KubaMiszcz/Praca-Inzynierska---RoboPajak/kalibracja serwa SG90/2016-11-22 serwo kalibr.jpg

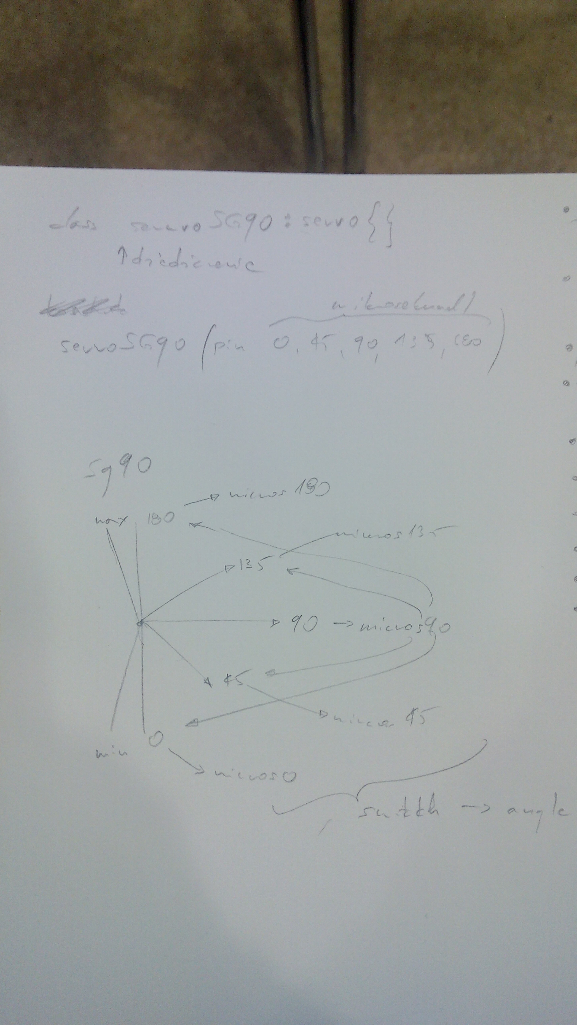
kalibracja serwa SG90/2016-11-22 serwo kalibr.jpg
