KubaMiszcz/Praca-Inzynierska---RoboPajak/2016-12-15 210624.jpg

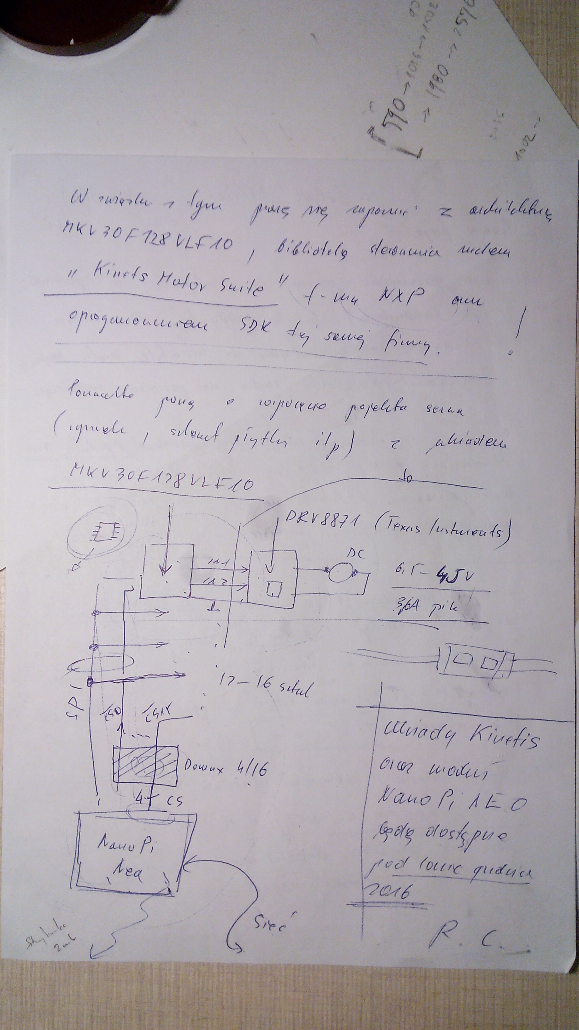
2016-12-15 210624.jpg
