KubaMiszcz/Praca-Inzynierska---RoboPajak/kalibracja serwa SG90/serialcomm/README.md

# serialcomm
communication betwee c# and serialport

na podstawie:
https://majsterkowo.pl/arduino-i-visual-c

plus moje upgrady i poprawki
