KubaMiszcz/Praca-Inzynierska---RoboPajak/do zrobienia plan rozpiska.docx

1. zrobic pozostale 4 nogi i korpus-baze
- czekam na serwa z aliexpressu
2. kalibrator serw i skalibrowac serwa sprawdzic czy trzeba kazde kalibrowac osobno
- metoda do sterowania serwem na podstawei danych z kalibracji - poprawka na nieliniowosc
3. glowa - 8 diod losowo zapalanych/gaszonych
- osobny modul niezalezny - arduino
4. noga o 3 stopniach swobody xyz, notacja DH, kinematyka odwrotna i prosta
- niech suwa noga na poczatek
- sterowanie jakies żeby robil krok
- noga,serwo, robot: klasa w C++(Visual Micro)
- zeby chodzil prosto - zaprogramowane/obliczone wczesniej sekwencje posrednie
- trzeci segment do nog na ok 4cm ktory bybly caly czas pionowo (moze jakas stopa" amortyzowana na koncu)
- zeby skrecal i podnosil sie i obnizal, robil jakies proste figury (sekwencje ktore da rade zrobic)
- przesylanie z zewnatrz zadanej trasy XY i wykonywanie jej - import trasy z pliku
- jezyk skryptowy do wykonywania trasy
5. komunikacja z HC-05
6. sterowanie przez COM z C# sieci petriego
7. DOKUMENTACJA
- napisz co zrobiles matlab uwagi cos tam napisz
- o sieciach petreigo napisz
- o tej kinematyce to pelna tabelka a do katow T23 tylko rozpisz i te uwagi e reszta się prosto liczy
8. pilot do sterowania
- HC-05 i pilot od radia
9. rejestrowal swoje polozenie XY (+Z ale trza by cos do pomiary wysokosci, albo na podstawie przechylow ale to chyba szkoda czasu)
10. wizualizajca/interfejs na PC/Android w c#/Xamarin, (moze w Unity tylko czy po cos?) - komunikacja Bluetooth
