KubaMiszcz/Praca-Inzynierska---RoboPajak/plytka MKV30F128Vxx10P/48LQFP.docx

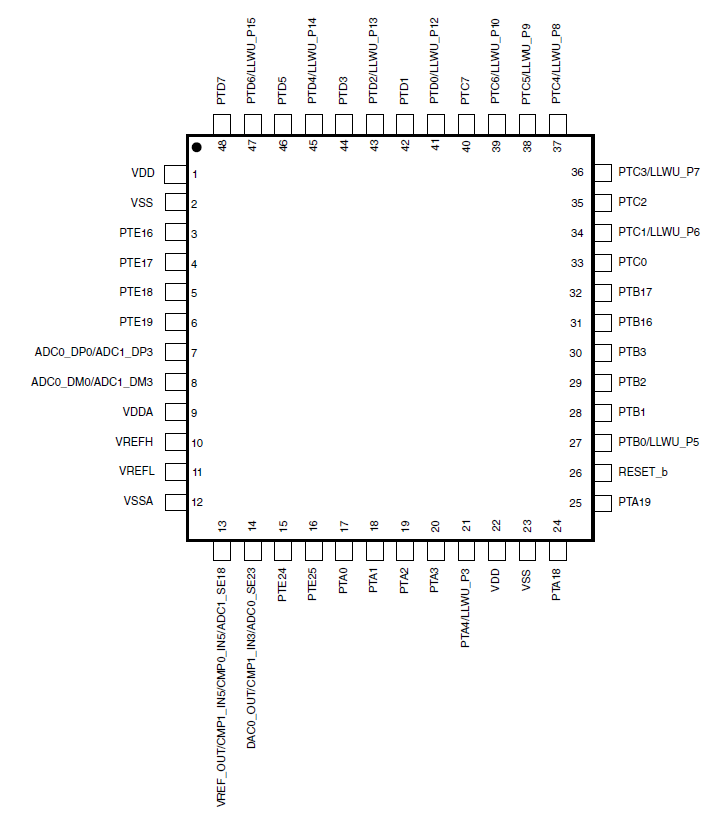
[picture p15: figure]
