KubaMiszcz/Praca-Inzynierska---RoboPajak/=SW 3D v3 new design/spis elementow.xlsx

segment | czesc | szt | kolor | nazwa | cm3 | VB | cm3 |  |  |  |  |  | masaSW | masaRepetier | masaREAL
S0 baza | korpus gora | 1 | czarny
 | korpus dol | 1
 | lacnzik korpusu z 4 obejmami | 1 | obojetne |  |  |  |  |  |  |  |  |  | noga | 509151.36 | mm3 | 509151.36
 | 4obejmy | 1 |  |  |  |  |  |  |  |  |  |  | korpus | 528599.73 | mm3 | 132149.9325
 | zaslepka w obejmie | 4 |  |  |  |  |  |  |  |  |  |  |  |  |  | 641301.2925 | mm3
S1 | rurka lacznik | 1 | obojetne
 | serwo | 2 | czarny
 | obudowa serwa | 2 | czarny
 |  |  |  |  |  |  |  |  |  |  |  |  |  |  |  | 26.1 | cm3
S2 | obejma | 1
 | zaslepka w obejmie | 1 | czarny |  |  |  |  |  |  |  |  |  |  |  |  | 52185.33 | mm3
 | rurka R2 | 1 |  |  |  |  |  |  |  |  |  |  |  |  |  | 52.18533
 | rurka lacznik | 2 | obojetne
 | serwo | 1
 | obudowa serwa | 1
S3 | obejma | 1 | czarny |  | 12.1
 | zaslepka w obejmie | 1
 | rurka R3 | 1 | czarny
 | rurka lacznik | 2 | obojetne
 | serwo | 1 | czarny |  |  | dolna 333 10% | 13.5
 | obudowa serwa | 1 | czarny | czapka |  | dolna 331 | 10.2 | dolna ??? |  | gorna 241 | ??? | 331 obie polwki: 20.6
S4 noga | obejma | 1
 | zaslepka w obejmie | 1 | czarny
 | rurka lacznik | 1 | obojetne
 | golen | 1
 | palec | 3 | czarny | palec232 | 2.6 | palec 342 | 3.6 | palec 333 | 3.1/ | palec 333 | 3.1
