KubaMiszcz/Praca-Inzynierska---RoboPajak/2016-12-01 PI opiska.jpg

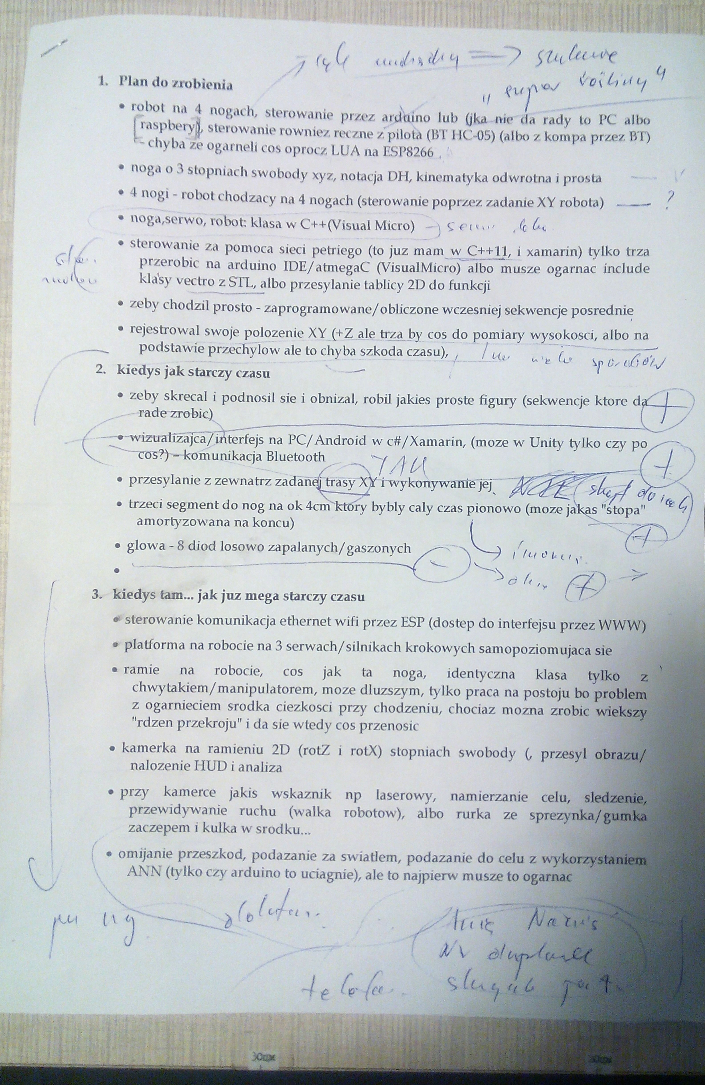
2016-12-01 PI opiska.jpg
