KubaMiszcz/Praca-Inzynierska---RoboPajak/2016-12-15 210615.jpg

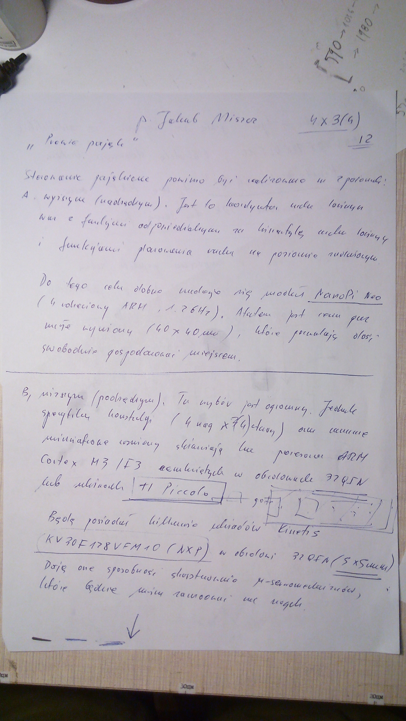
2016-12-15 210615.jpg
