KubaMiszcz/Praca-Inzynierska---RoboPajak/foto idea/2017-03-16 135014.jpg

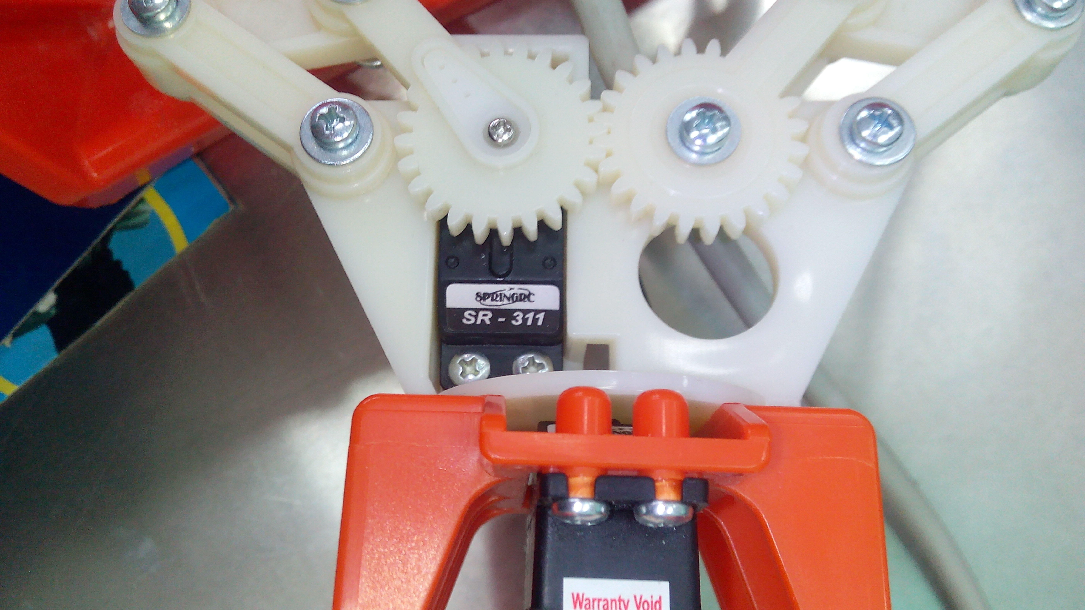
foto idea/2017-03-16 135014.jpg
