KubaMiszcz/Praca-Inzynierska---RoboPajak/foto idea/2017-03-16 135029.jpg

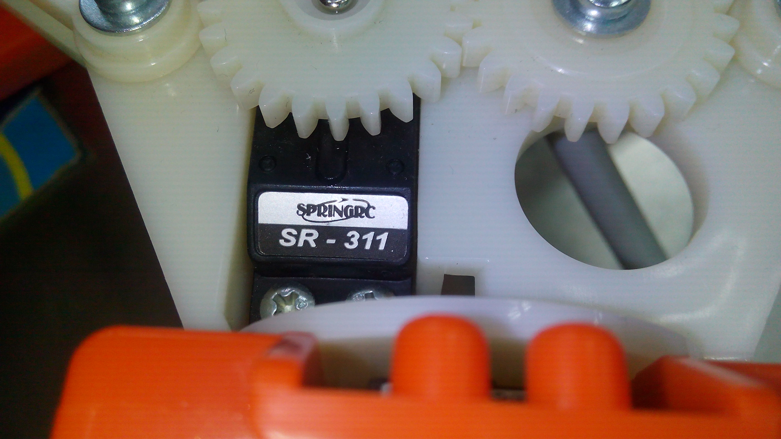
foto idea/2017-03-16 135029.jpg
