KubaMiszcz/Praca-Inzynierska---RoboPajak/foto idea/83620007d3c88add1a90197fbf7187ce.jpg

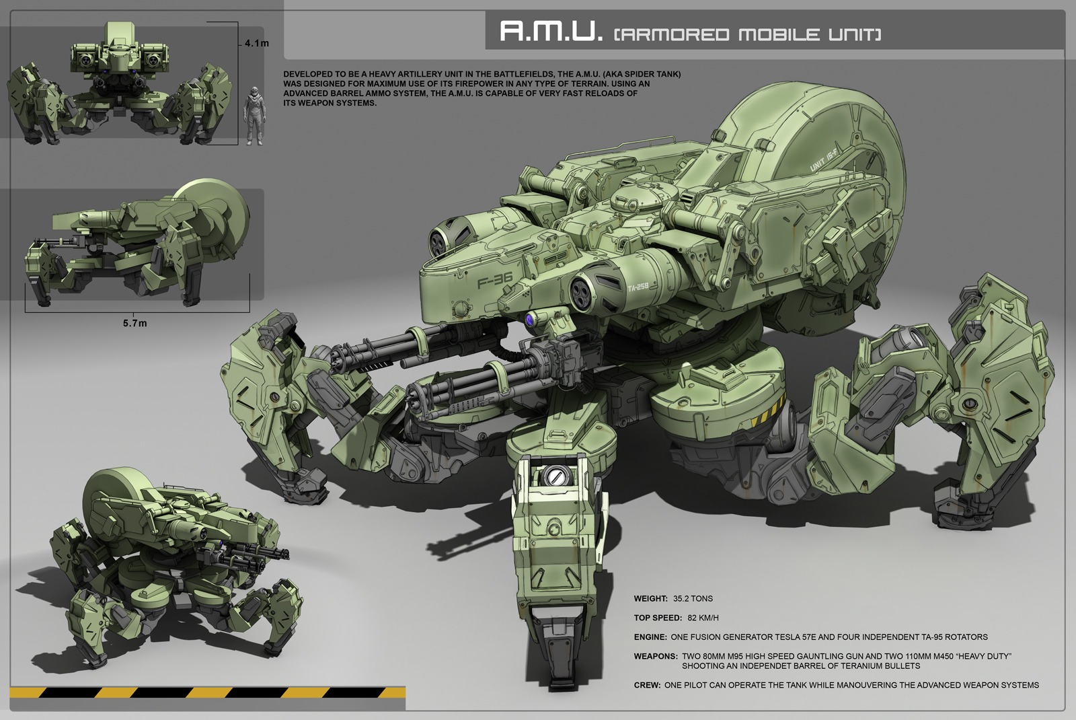
foto idea/83620007d3c88add1a90197fbf7187ce.jpg
