KubaMiszcz/Praca-Inzynierska---RoboPajak/foto idea/c6SfzFi.png

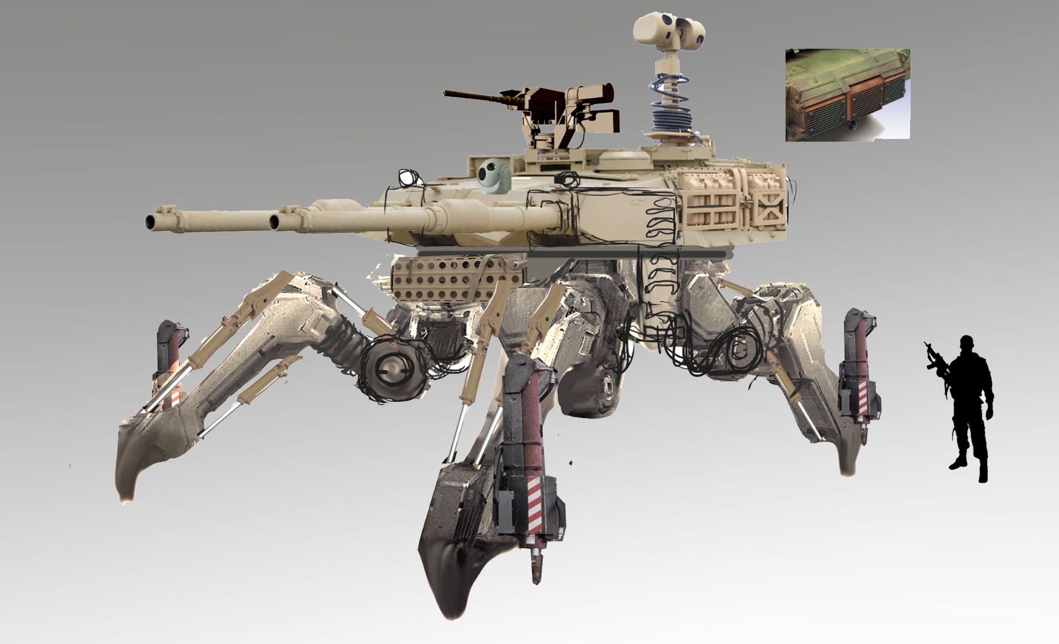
foto idea/c6SfzFi.png
