KubaMiszcz/Praca-Inzynierska---RoboPajak/foto idea/megalith_spider_tank_5354.jpg

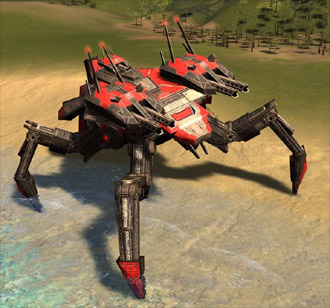
foto idea/megalith_spider_tank_5354.jpg
