KubaMiszcz/Praca-Inzynierska---RoboPajak/foto idea/spider_tank_colored_by_silencedarm-d62n22h.jpg

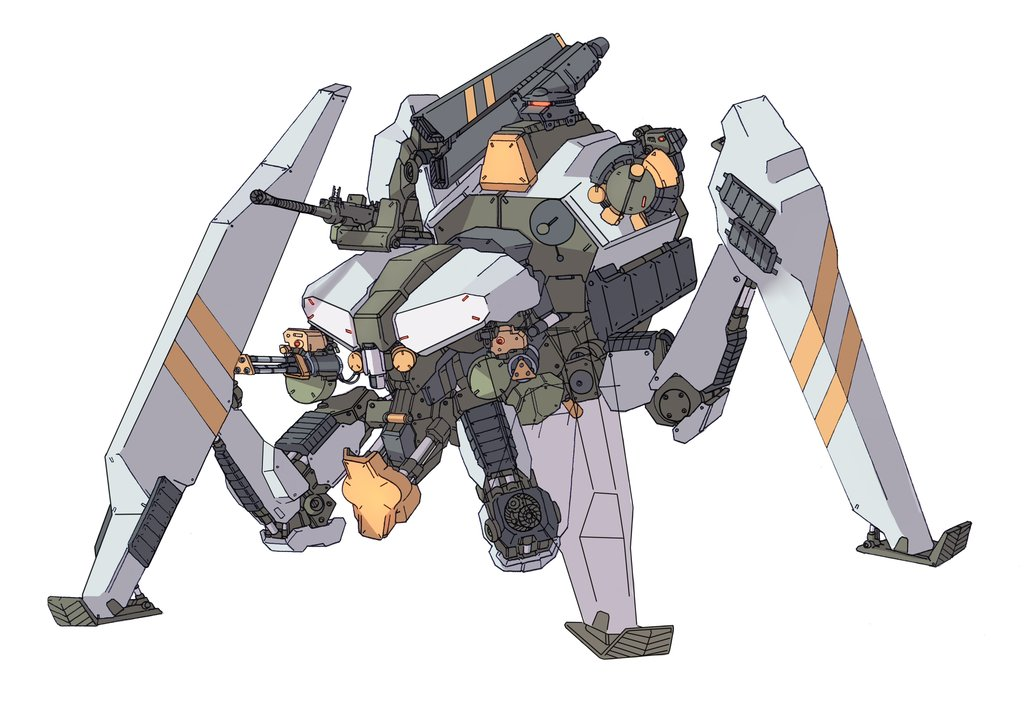
foto idea/spider_tank_colored_by_silencedarm-d62n22h.jpg
