KubaMiszcz/Praca-Inzynierska---RoboPajak/foto idea/spider_tank_in_progress_by_shanenelson.jpg

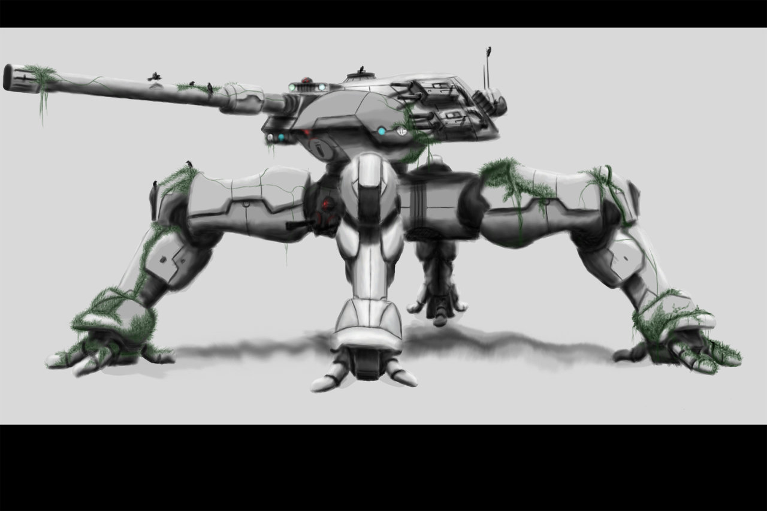
foto idea/spider_tank_in_progress_by_shanenelson.jpg
