KubaMiszcz/Praca-Inzynierska---RoboPajak/fotografie/2016-12-25 pierwsza wersja 1.jpg

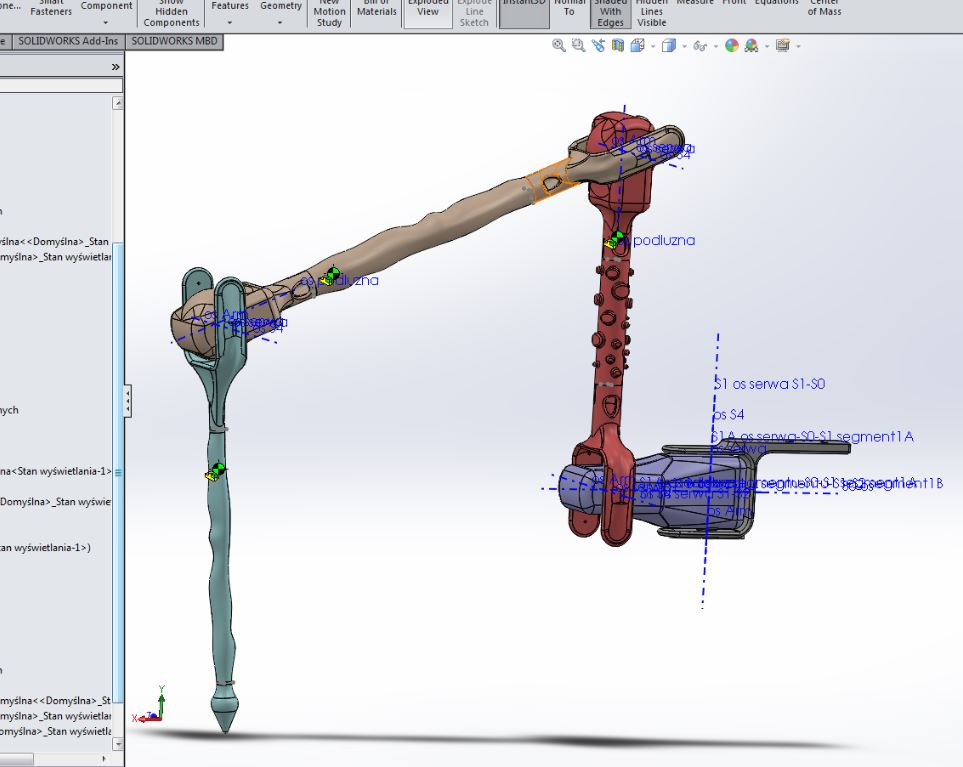
fotografie/2016-12-25 pierwsza wersja 1.jpg
