KubaMiszcz/Praca-Inzynierska---RoboPajak/fotografie/2016-12-25 pierwsza wersja 2.jpg

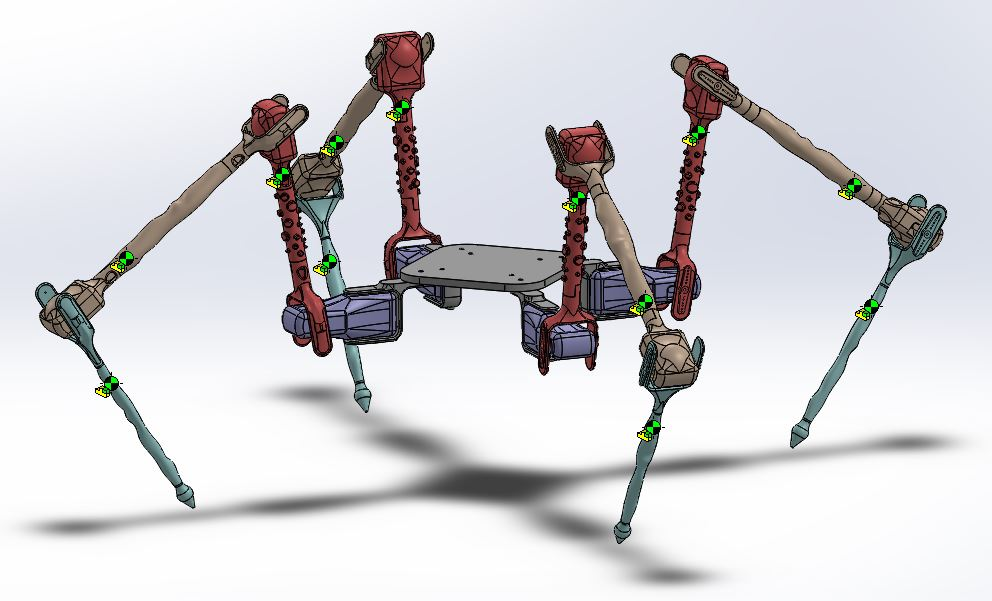
fotografie/2016-12-25 pierwsza wersja 2.jpg
