KubaMiszcz/Praca-Inzynierska---RoboPajak/fotografie/2017-01-03 pierwsza wersja 3.jpg

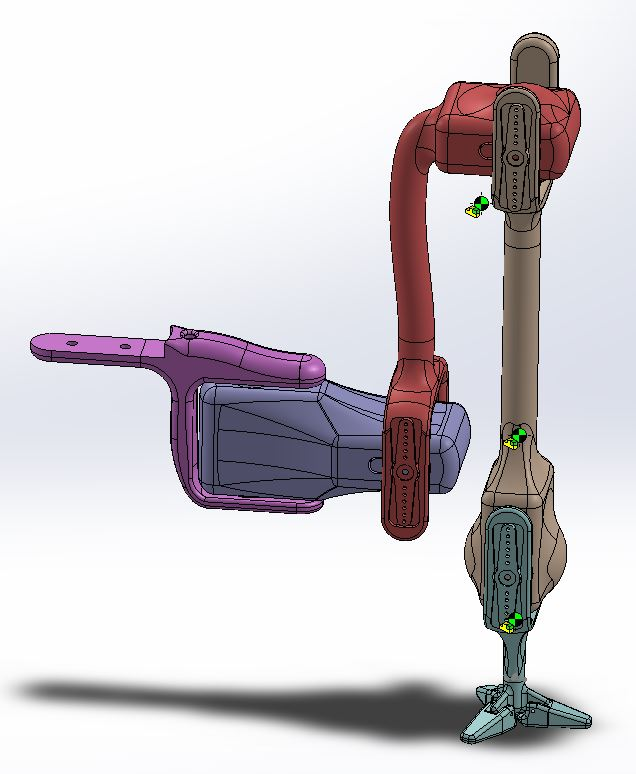
fotografie/2017-01-03 pierwsza wersja 3.jpg
