KubaMiszcz/Praca-Inzynierska---RoboPajak/fotografie/2017-01-05 202605 druk3d.jpg

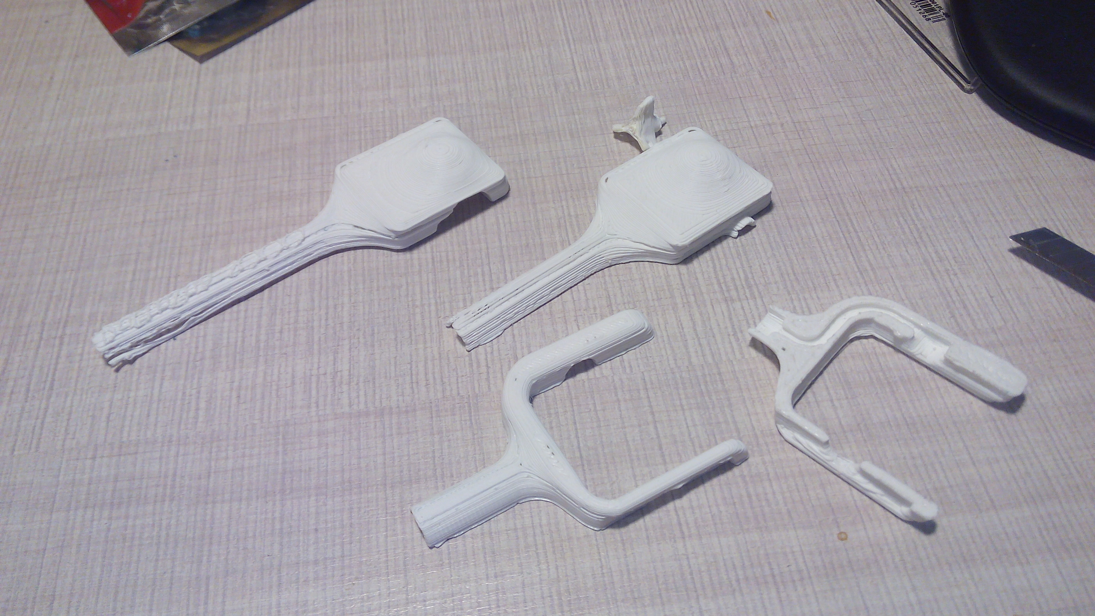
fotografie/2017-01-05 202605 druk3d.jpg
