KubaMiszcz/Praca-Inzynierska---RoboPajak/fotografie/2017-02-20 19-36-34 robot V2 9.jpg

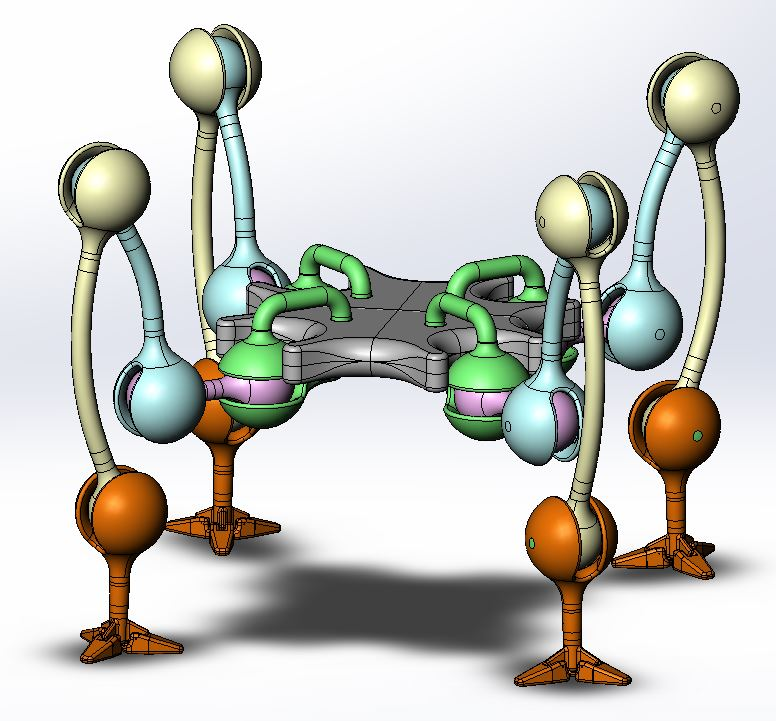
fotografie/2017-02-20 19-36-34 robot V2 9.jpg
