KubaMiszcz/Praca-Inzynierska---RoboPajak/fotografie/2017-02-23 09-51-42 robot V2 1.jpg

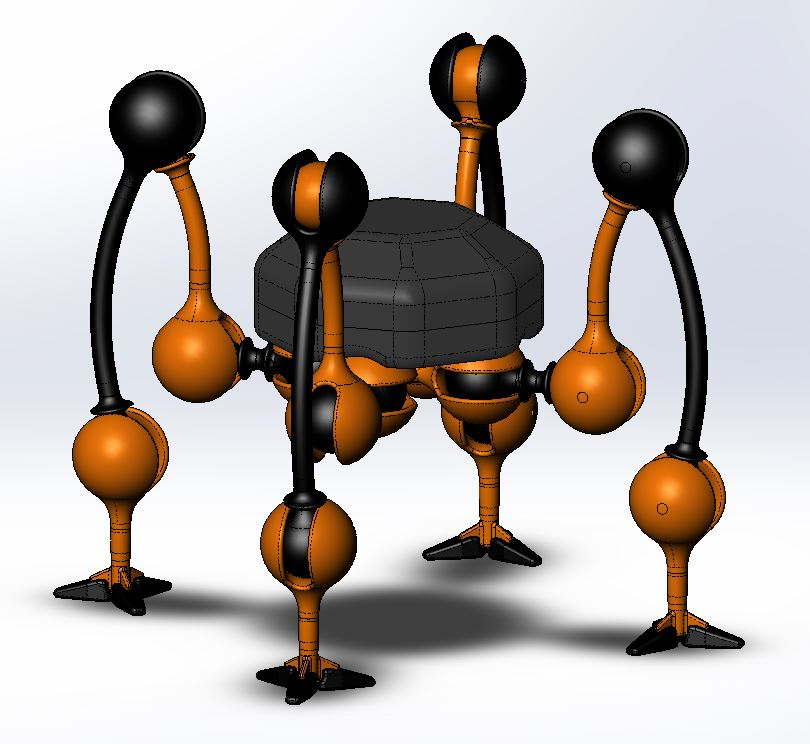
fotografie/2017-02-23 09-51-42 robot V2 1.jpg
