KubaMiszcz/Praca-Inzynierska---RoboPajak/fotografie/2017-02-23 09-52-02 robot V2 2.jpg

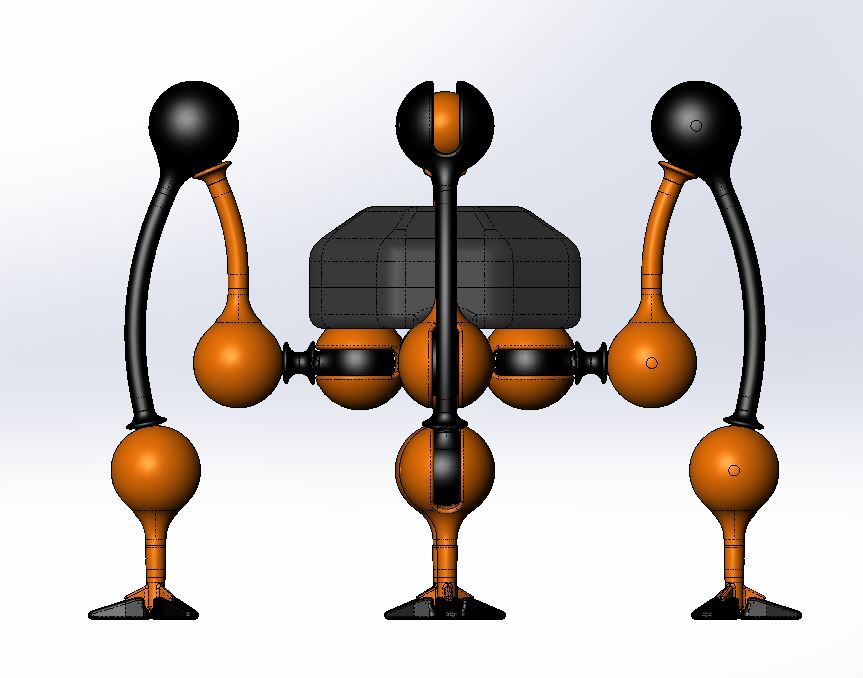
fotografie/2017-02-23 09-52-02 robot V2 2.jpg
