KubaMiszcz/Praca-Inzynierska---RoboPajak/fotografie/2017-02-23 09-52-28 robot V2 3.jpg

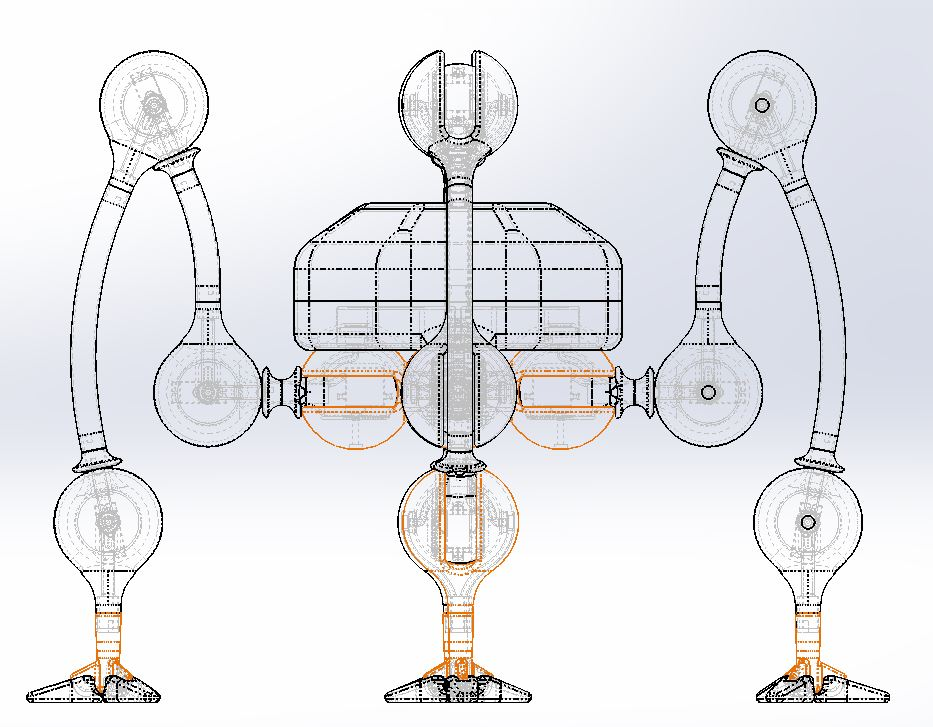
fotografie/2017-02-23 09-52-28 robot V2 3.jpg
