KubaMiszcz/Praca-Inzynierska---RoboPajak/fotografie/2017-02-23 09-53-06 robot V2 4.jpg

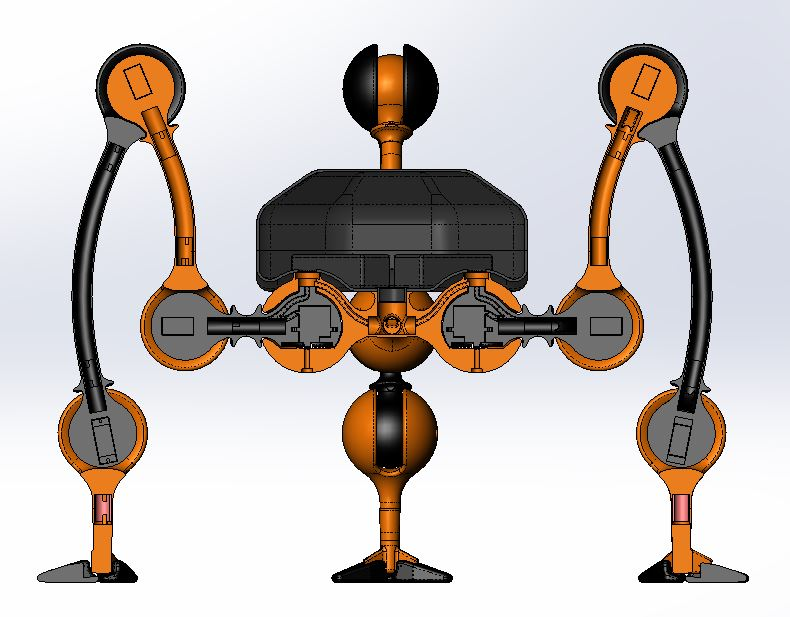
fotografie/2017-02-23 09-53-06 robot V2 4.jpg
