KubaMiszcz/Praca-Inzynierska---RoboPajak/fotografie/2017-02-23 09-54-14 robot V2 5.jpg

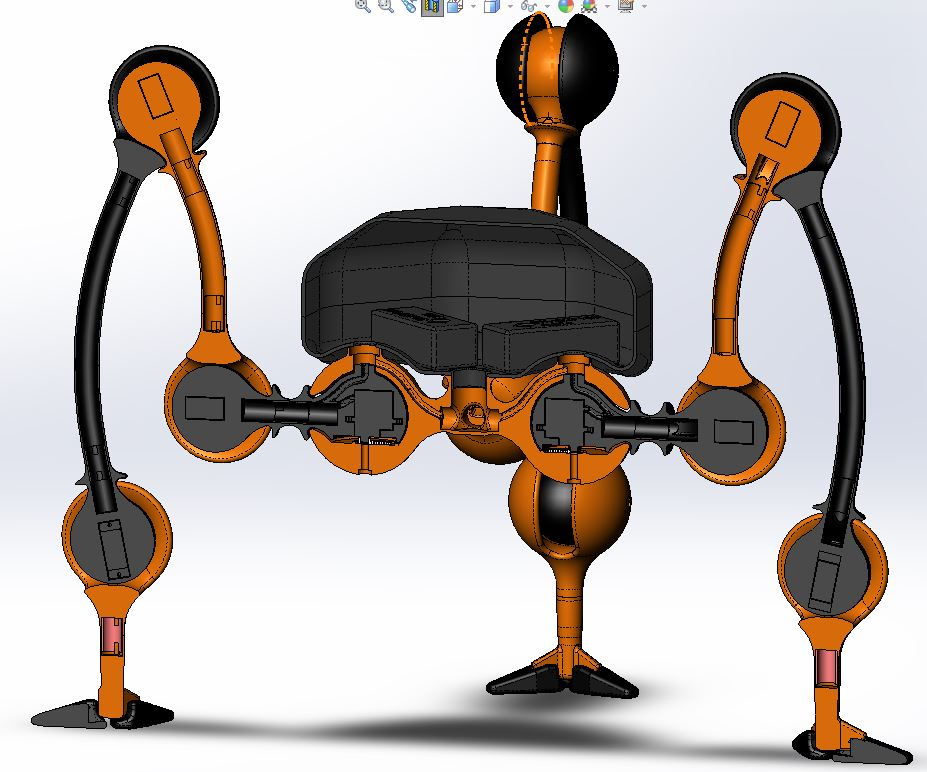
fotografie/2017-02-23 09-54-14 robot V2 5.jpg
