KubaMiszcz/Praca-Inzynierska---RoboPajak/fotografie/2017-02-23 10-03-38 robot V2 6.jpg

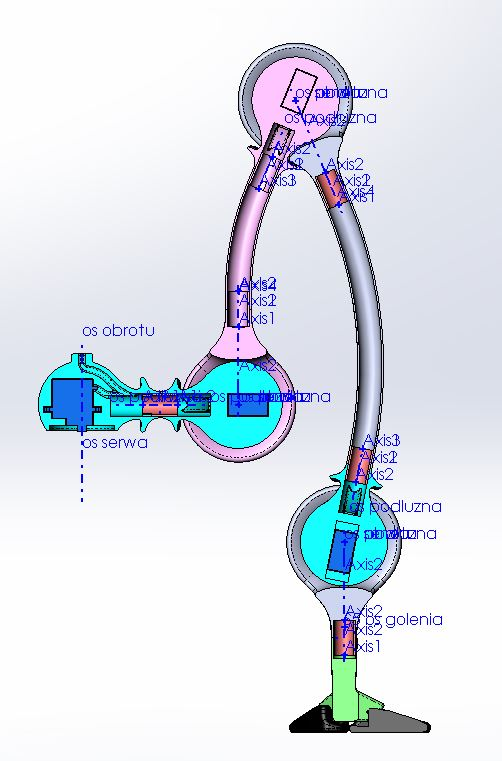
fotografie/2017-02-23 10-03-38 robot V2 6.jpg
