KubaMiszcz/Praca-Inzynierska---RoboPajak/fotografie/2017-02-23 10-05-08 robot V2 7.jpg

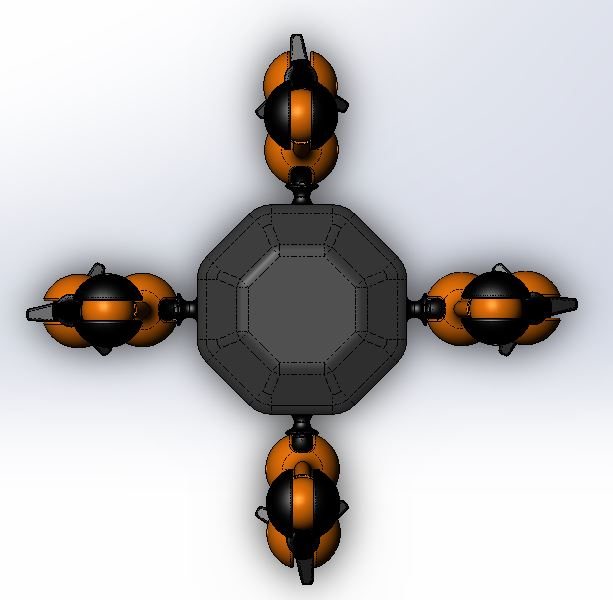
fotografie/2017-02-23 10-05-08 robot V2 7.jpg
