KubaMiszcz/Praca-Inzynierska---RoboPajak/fotografie/2017-02-23 10-05-28 robot V2 8.jpg

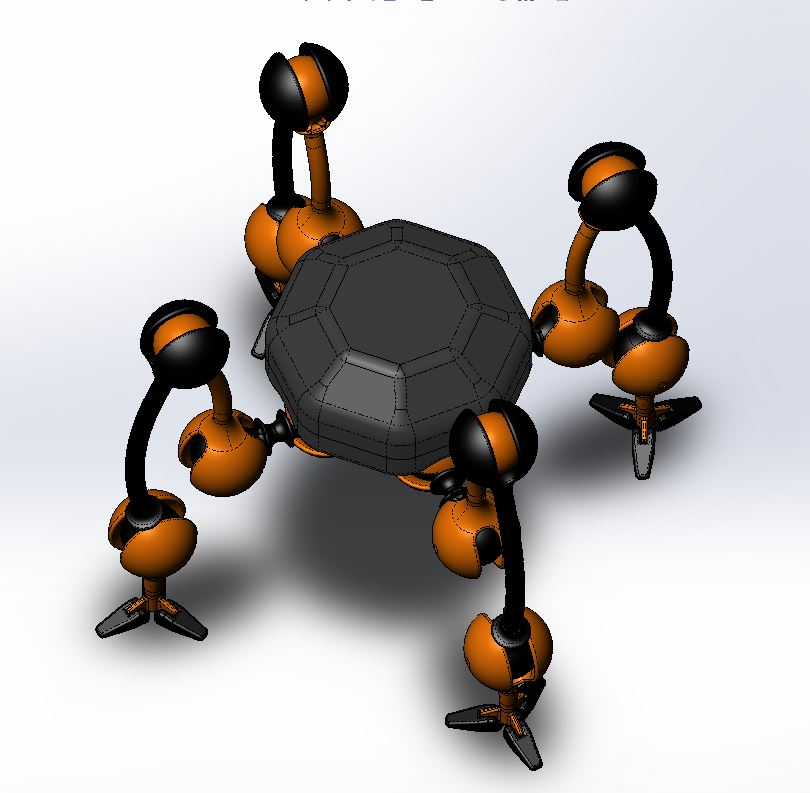
fotografie/2017-02-23 10-05-28 robot V2 8.jpg
