KubaMiszcz/Praca-Inzynierska---RoboPajak/fotografie/2017-02-23 11-02-16 robot V2 10.jpg

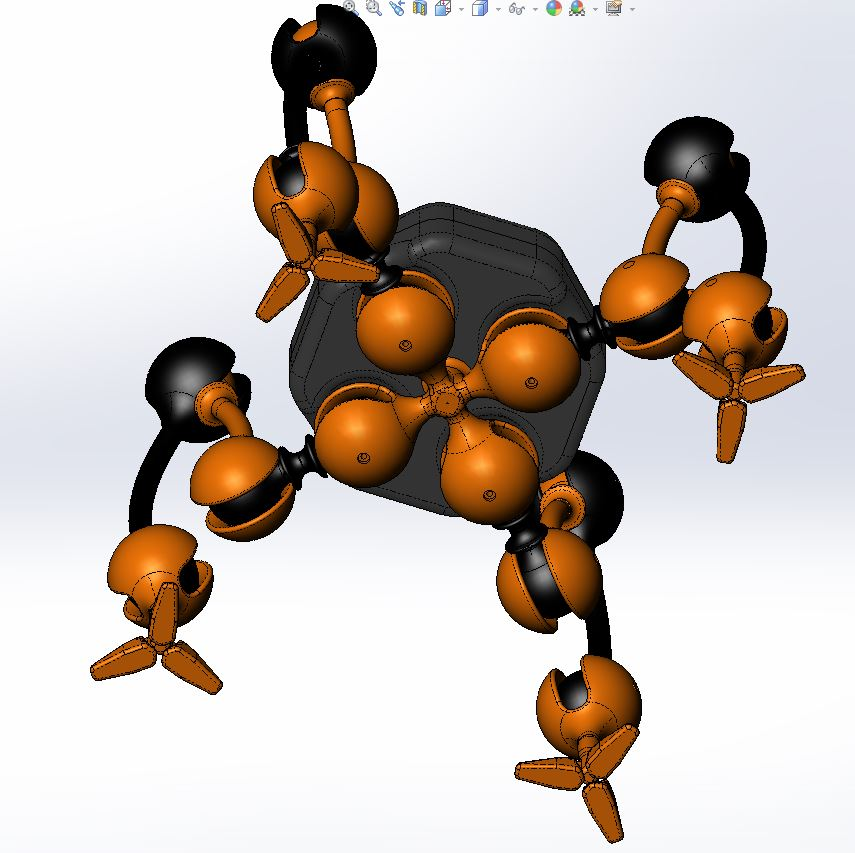
fotografie/2017-02-23 11-02-16 robot V2 10.jpg
