KubaMiszcz/Praca-Inzynierska---RoboPajak/fotografie/2017-02-23 11-03-10 robot V2 12.jpg

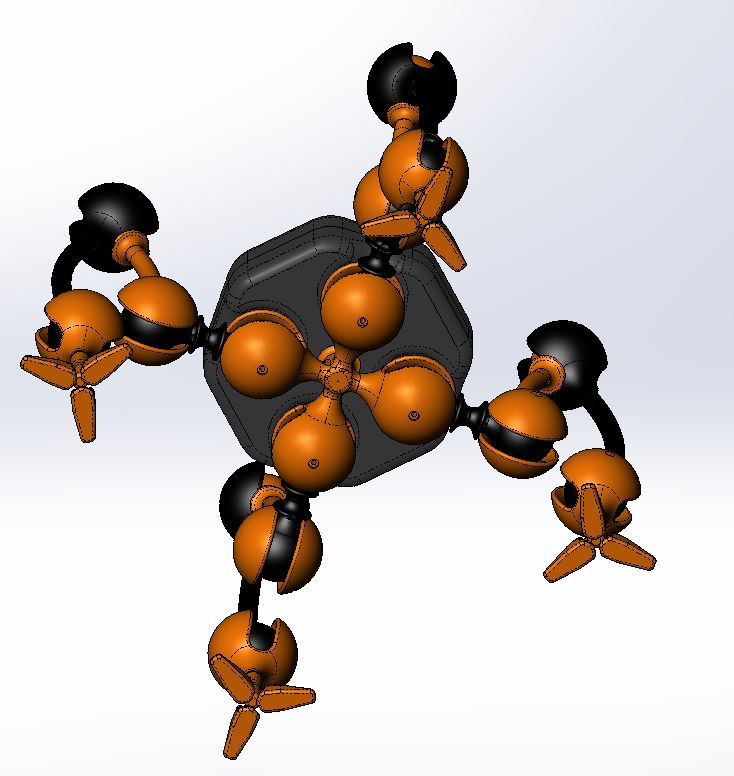
fotografie/2017-02-23 11-03-10 robot V2 12.jpg
