KubaMiszcz/Praca-Inzynierska---RoboPajak/materialy pomocnicze - zrodla/stm32-3 rozpiska rdzeni.jpg

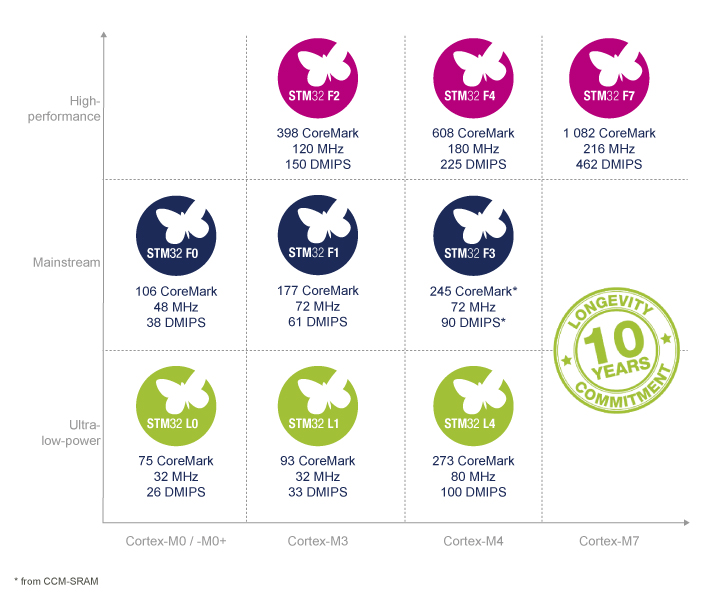
materialy pomocnicze - zrodla/stm32-3 rozpiska rdzeni.jpg
