KubaMiszcz/Praca-Inzynierska---RoboPajak/plytka MKV30F128Vxx10P/MKV30F128VFL10PminimumV2/!PCB!bottomLayer.png

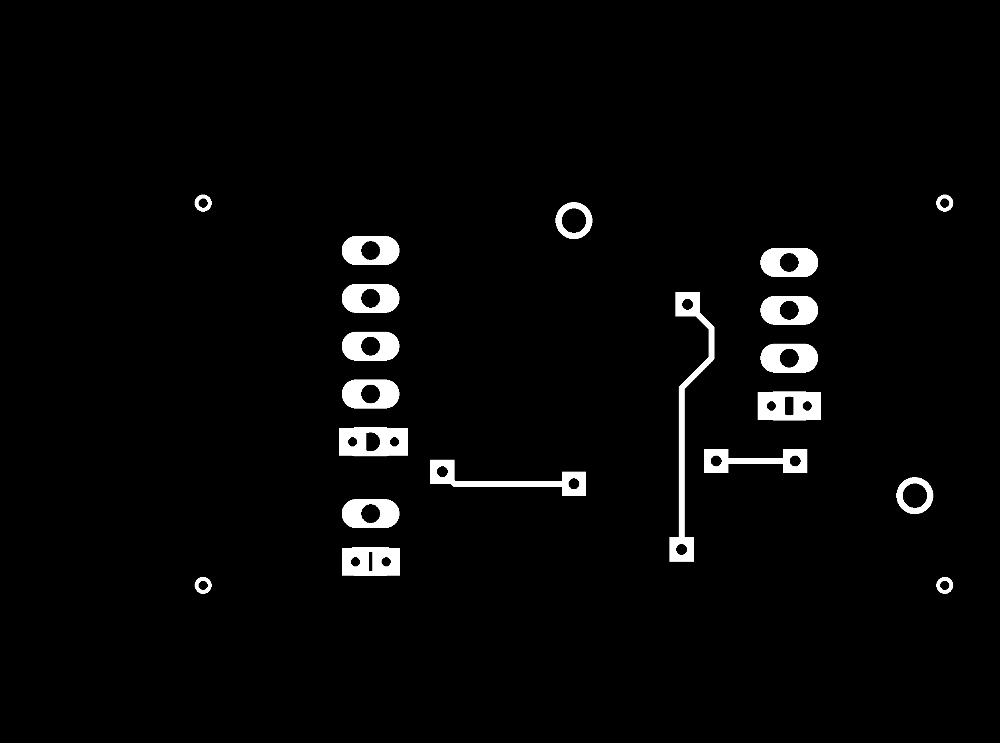
plytka MKV30F128Vxx10P/MKV30F128VFL10PminimumV2/!PCB!bottomLayer.png
