KubaMiszcz/Praca-Inzynierska---RoboPajak/=SW 3D v2 kulkowe preguby/A SX noga.SLDASM

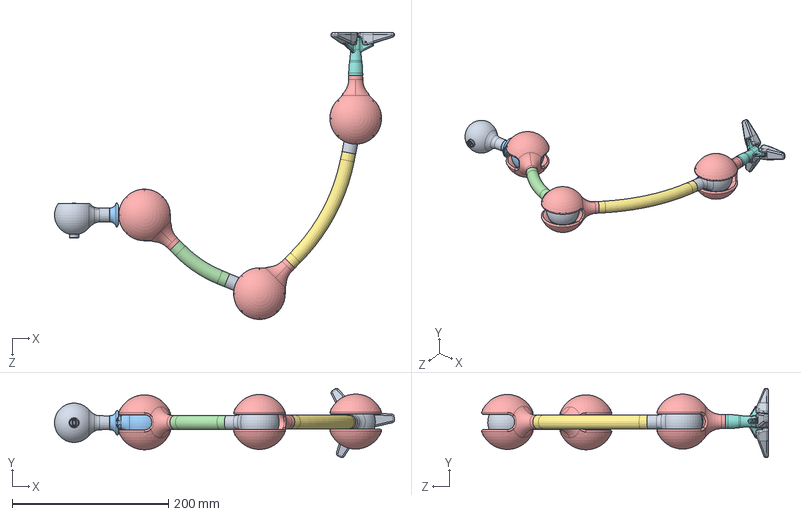
[picture p52: CAD file, 2017-05-17]
=SW 3D v2 kulkowe preguby/A SX noga.SLDASM
434.7 x 88.7 x 366.8 mm
PRT v3 uni obudowa serwa x 3
PRT servo SG90 x 4
PRT uni obudowas serwa 90st z wpustem
PRT S2 rurka v2 wygieta
PRT v2 uni obejma serwa ze znacznikami x 3
PRT SingleServoArm x 3
PRT S3 rurka v2 wygieta
Prt S4 golen
PRT S4 palec v2 sciecie 120st x 3
