KubaMiszcz/Praca-Inzynierska---RoboPajak/=SW 3D v2 kulkowe preguby/parts ogolne/zz/A zzzzzz v3 testowy przegub.SLDASM

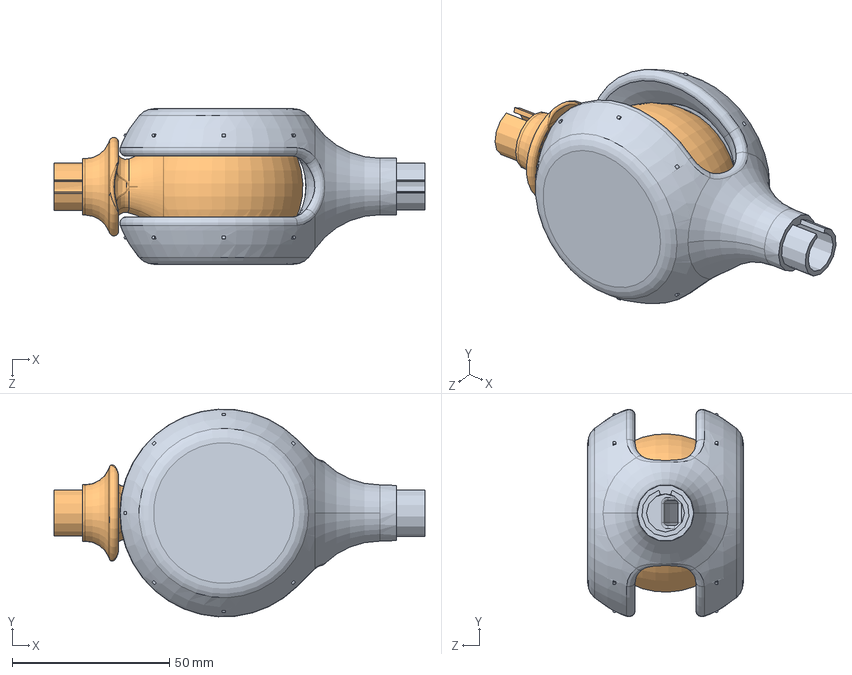
[picture p53: CAD file, 2017-05-17]
=SW 3D v2 kulkowe preguby/parts ogolne/zz/A zzzzzz v3 testowy przegub.SLDASM
118.0 x 66.0 x 49.5 mm
PRT v3 uni obejma serwa ciensza
PRT v3 uni obudowas serwa ciensza
PRT servo SG90
