KubaMiszcz/Praca-Inzynierska---RoboPajak/=SW 3D v2 kulkowe preguby/S0 baza/==/S0 korpus obudowa okragla + dodatki.SLDASM

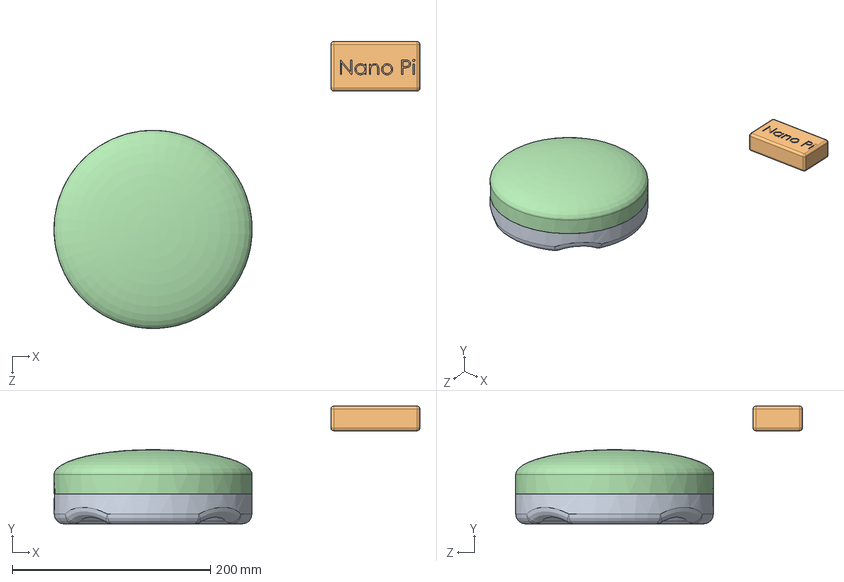
[picture p54: CAD file, 2017-05-17]
=SW 3D v2 kulkowe preguby/S0 baza/==/S0 korpus obudowa okragla + dodatki.SLDASM
369.3 x 118.9 x 289.6 mm
S0 korpus obudowa dolna
NanoPi
STM32F103C8T6 x 4
S0 korpus obudowa gora
