KubaMiszcz/Praca-Inzynierska---RoboPajak/=SW 3D v2 kulkowe preguby/S0 baza/A S0 v3 korpus obudowa + dodatki osmiokat bez pochylen.SLDASM

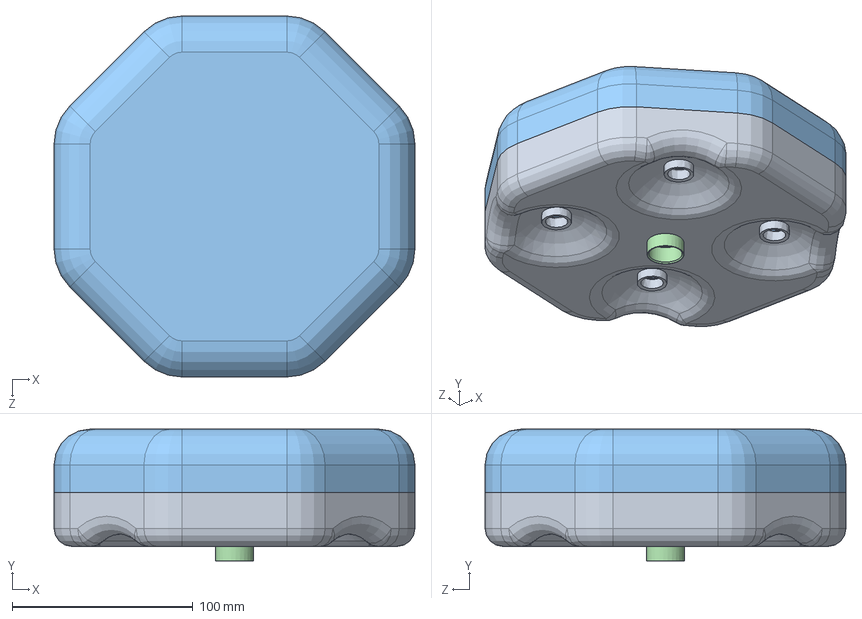
[picture p55: CAD file, 2017-05-17]
=SW 3D v2 kulkowe preguby/S0 baza/A S0 v3 korpus obudowa + dodatki osmiokat bez pochylen.SLDASM
200.0 x 73.0 x 200.0 mm
PRT S0 korpus obudowa dolna v2 osmiokat
PRT STM32F103C8T6 x 4
PRT S0 korpus obudowa gorna v3 osmiokat bez pochylen
Prt S0 lacznik baza+4obejmyPart1
