KubaMiszcz/Praca-Inzynierska---RoboPajak/=SW 3D v2 kulkowe preguby/S4 segment/A S4 segment.SLDASM

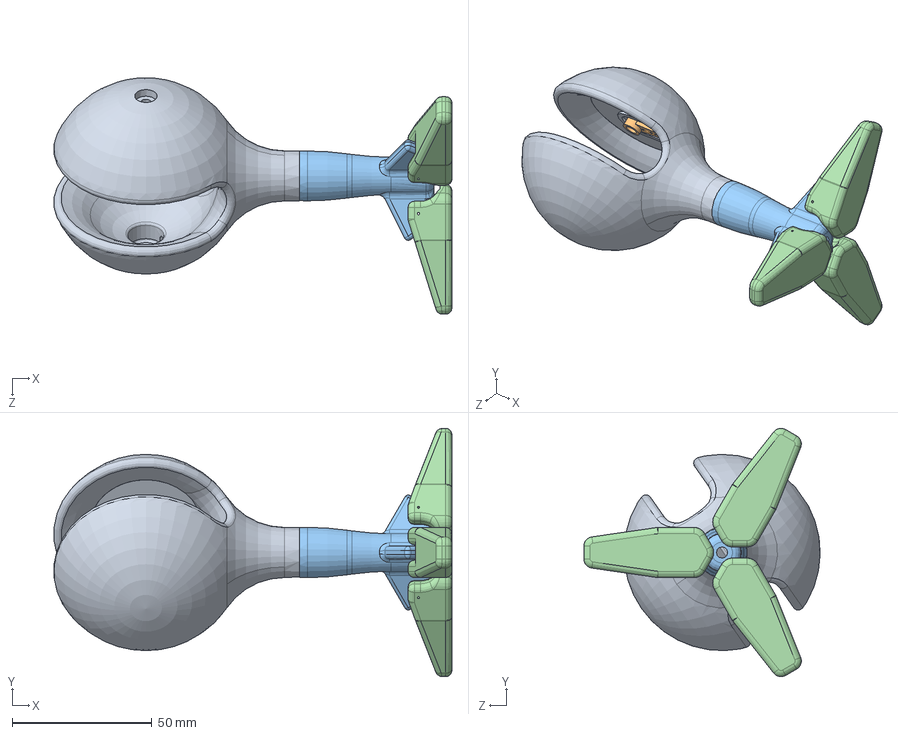
[picture p56: CAD file, 2017-05-17]
=SW 3D v2 kulkowe preguby/S4 segment/A S4 segment.SLDASM
142.6 x 89.0 x 84.7 mm
PRT v2 uni obejma serwa ze znacznikami
PRT SingleServoArm
Prt S4 golen
PRT S4 palec v2 sciecie 120st x 3
