KubaMiszcz/Praca-Inzynierska---RoboPajak/=SW 3D v2 kulkowe preguby/z parts fabryczne i dodatki/zzskasuj.SLDASM

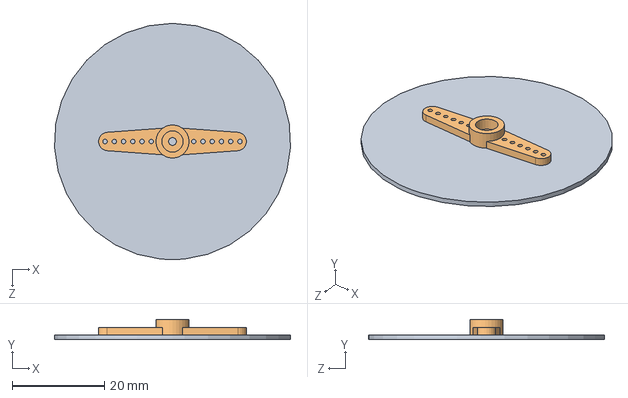
[picture p57: CAD file, 2017-05-17]
=SW 3D v2 kulkowe preguby/z parts fabryczne i dodatki/zzskasuj.SLDASM
51.1 x 4.43 x 51.2 mm
PRT szablon arm
PRT DoubleServoArm
