KubaMiszcz/Praca-Inzynierska---RoboPajak/=SW 3D v3 new design/A SX noga.SLDASM

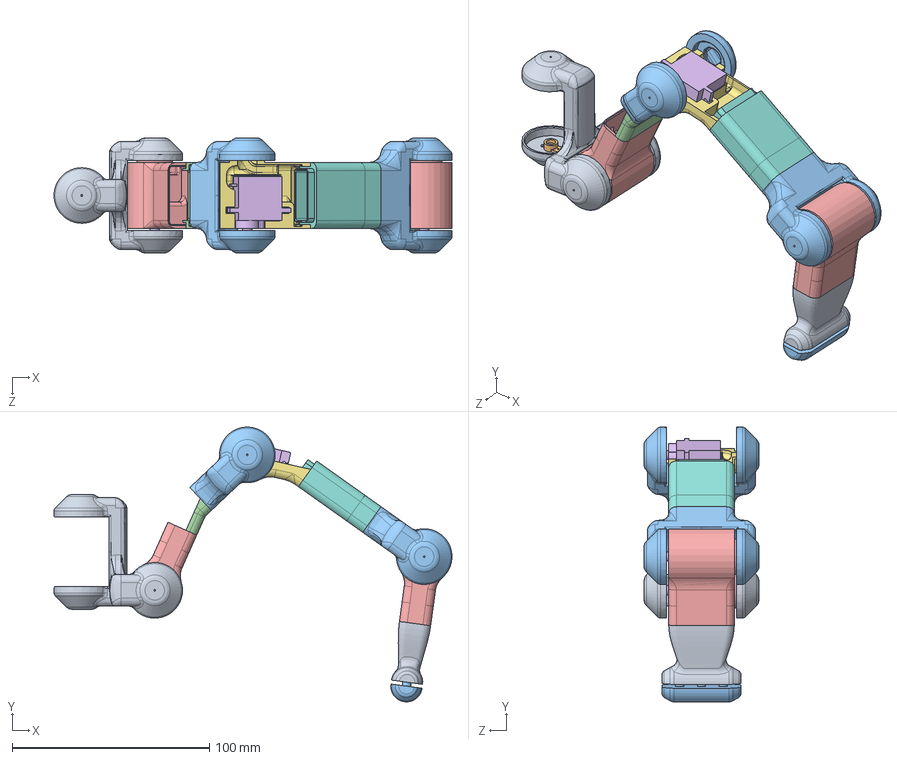
[picture p58: CAD file, 2017-05-17]
=SW 3D v3 new design/A SX noga.SLDASM
201.7 x 139.3 x 58.3 mm
P S1 v2 segment obejmy 90st
P SingleServoArm x 4
P v8 uni obejma serwa szeroka rurka x 2
P S2 rurka v8 sciecia
P v9 uni obudowa serwa szeroka rurak x 2
P servo SG90 x 3
P v8a uni obudowa serwa szeroka rurak 90st
P S3 rurka v9 wygieta sciecia
P S4 v4 golen
P endstop
P S4 trzpien do endstopu
