KubaMiszcz/Praca-Inzynierska---RoboPajak/=SW 3D v3 new design/S0 baza/A S0 v3 podstawa z serwami.SLDASM

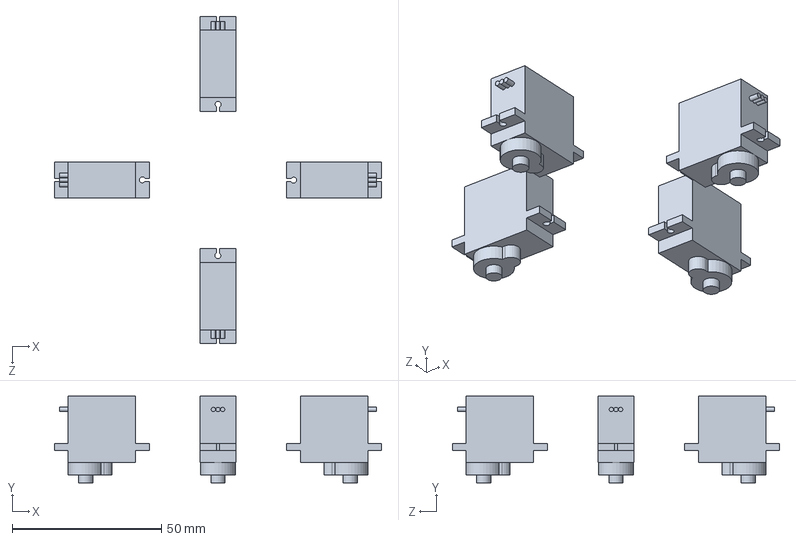
[picture p59: CAD file, 2017-05-17]
=SW 3D v3 new design/S0 baza/A S0 v3 podstawa z serwami.SLDASM
109.4 x 29.0 x 109.4 mm
P servo SG90 x 4
