KubaMiszcz/Praca-Inzynierska---RoboPajak/=SW 3D v3 new design/S4 segment/==/A S4 segment.SLDASM

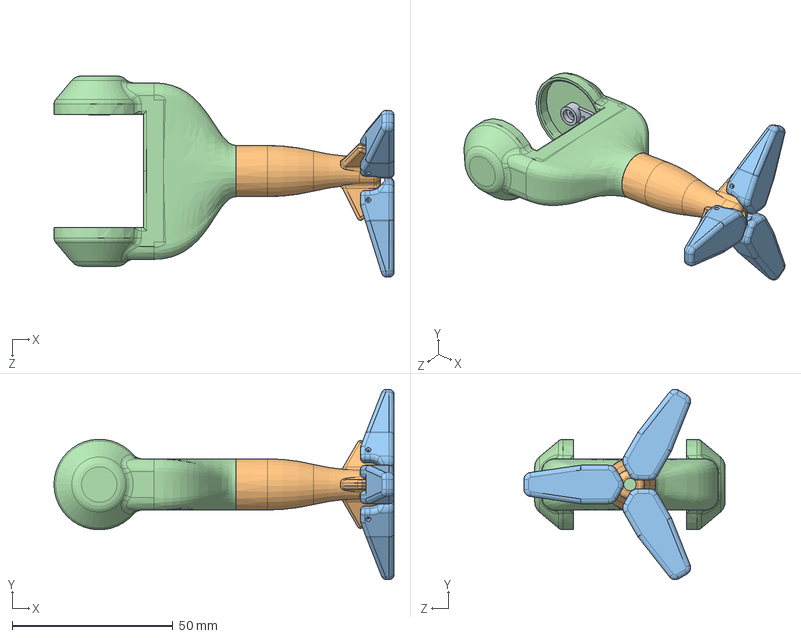
[picture p60: CAD file, 2017-05-17]
=SW 3D v3 new design/S4 segment/==/A S4 segment.SLDASM
105.9 x 59.3 x 62.7 mm
P SingleServoArm
P S4 golen
P S4 palec v2 sciecie 120st x 3
P S4 v1 obejma przy goleniu
