KubaMiszcz/Praca-Inzynierska---RoboPajak/=SW 3D v3 new design/S4 segment/A S4 v2 segment.SLDASM

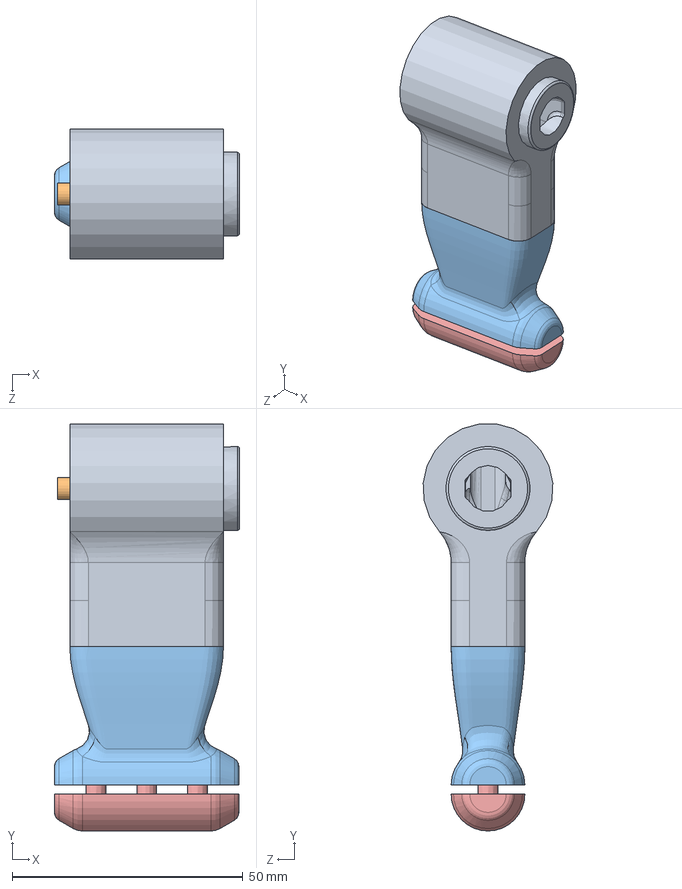
[picture p61: CAD file, 2017-05-17]
=SW 3D v3 new design/S4 segment/A S4 v2 segment.SLDASM
40.2 x 88.2 x 28.1 mm
P v9 uni obudowa serwa szeroka rurak
P servo SG90
P S4 v4 golen
P endstop
P S4 trzpien do endstopu
