KubaMiszcz/Praca-Inzynierska---RoboPajak/=SW 3D v3 new design/zzz testy/gwintyczypasuja.SLDASM

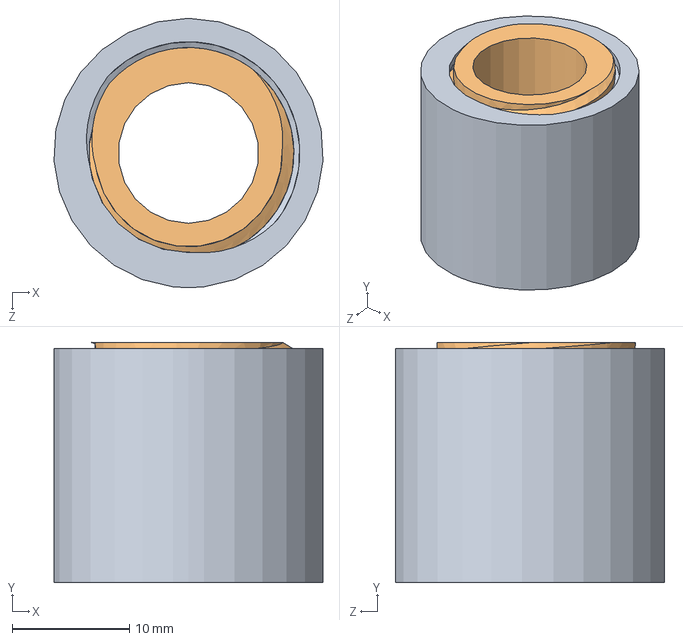
[picture p62: CAD file, 2017-05-17]
=SW 3D v3 new design/zzz testy/gwintyczypasuja.SLDASM
23.0 x 20.5 x 23.0 mm
tuleja gwint
gwint
