KubaMiszcz/Praca-Inzynierska---RoboPajak/zzz inne/Solidworks model3D v1/==aROBO PAJAK CALYv1.SLDASM

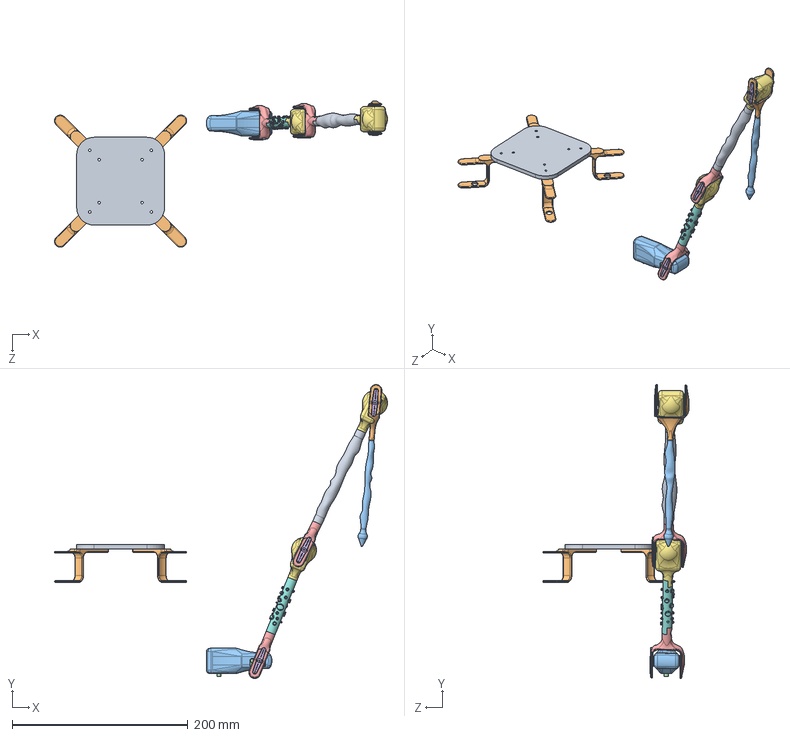
[picture p63: CAD file, 2017-05-17]
zzz inne/Solidworks model3D v1/==aROBO PAJAK CALYv1.SLDASM
378.8 x 334.4 x 166.6 mm
S0 - podstawa
S0-S1(baza-obejma) x 4
S1 segment 2 obudowy na serwo
servo SG90 x 4
obejma serwa x 2
ServoArm x 3
obudowa na serwo x 2
rurkaS2
rurkaS3v2
S4 obejma serwa
S4 rurka v2
