KubaMiszcz/Praca-Inzynierska---RoboPajak/zzz inne/Solidworks model3D v1/S2 - segment/S2 servo w obudowie.SLDASM

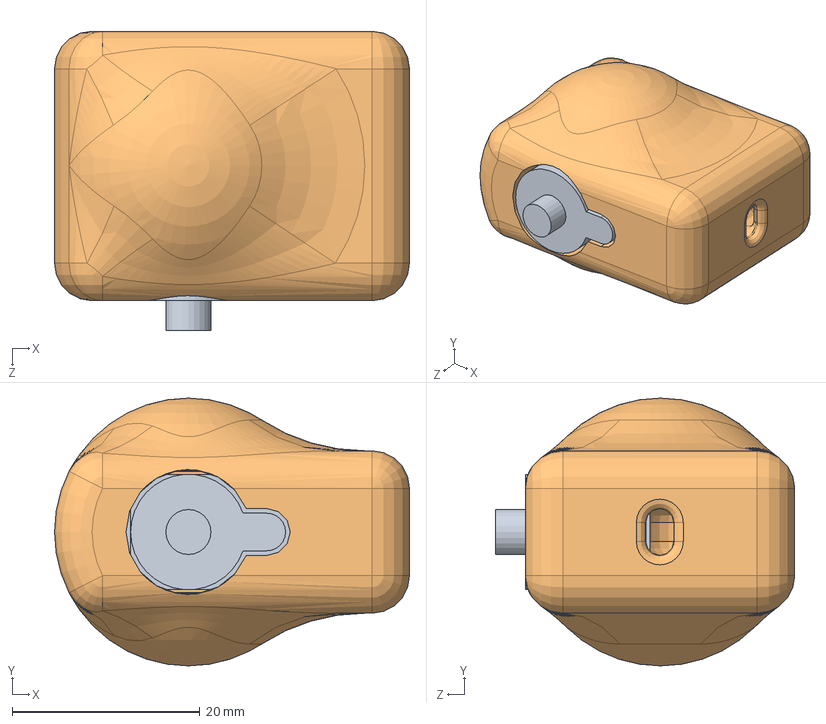
[picture p64: CAD file, 2017-05-17]
zzz inne/Solidworks model3D v1/S2 - segment/S2 servo w obudowie.SLDASM
37.8 x 28.5 x 31.9 mm
servo SG90
S2 obudowa na serwo v2
