KubaMiszcz/Praca-Inzynierska---RoboPajak/zzz inne/Solidworks model3D v1/zz arch/S3 - segment v1.SLDASM

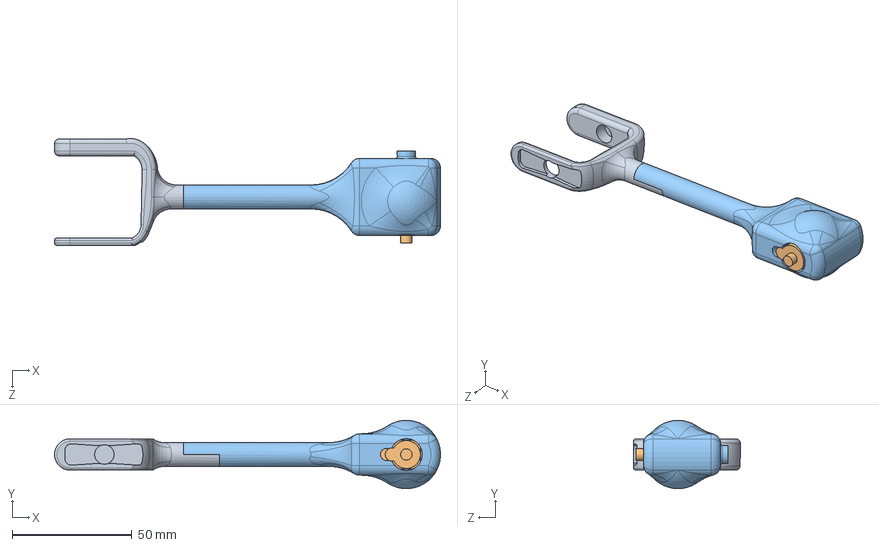
[picture p65: CAD file, 2017-05-17]
zzz inne/Solidworks model3D v1/zz arch/S3 - segment v1.SLDASM
161.0 x 28.5 x 44.7 mm
S3 obejma serwa v2 grubsza na kabel
servo SG90
S3 obudowa na serwo v2
