KubaMiszcz/Praca-Inzynierska---RoboPajak/=SW 3D v2 kulkowe preguby/A S4 ASMem1.SLDASM

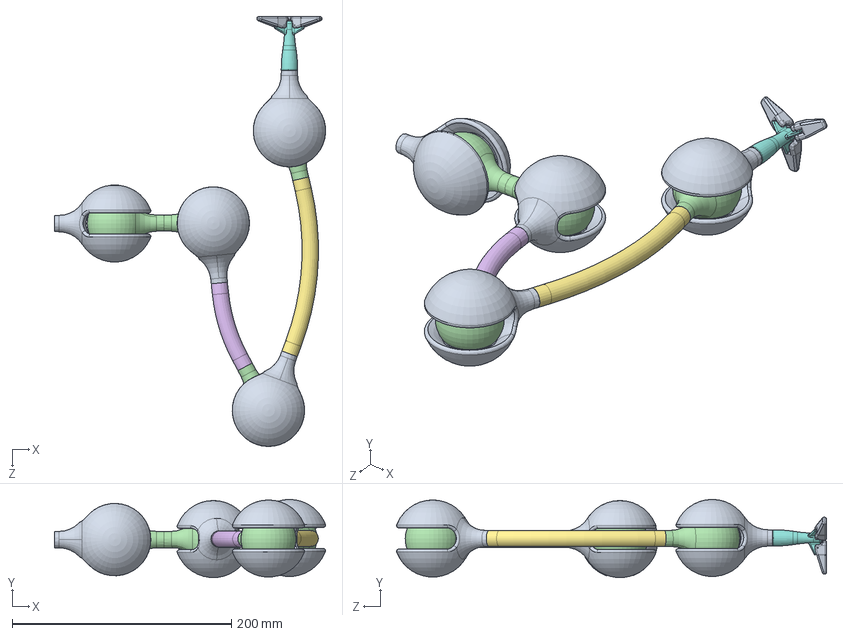
[picture p66: CAD file, 2017-05-17]
=SW 3D v2 kulkowe preguby/A S4 ASMem1.SLDASM
247.5 x 71.4 x 392.3 mm
uni obejma serwa x 4
SingleServoArm x 4
zaslepka obejmy serwa x 4
uni obudowas serwa x 4
servo SG90 x 4
S2 rurka v2 wygieta
S3 rurka v2 wygieta
S4 golen
S4 palec v2 sciecie 120st x 3
lacznik rurek
