KubaMiszcz/Praca-Inzynierska---RoboPajak/=SW 3D v2 kulkowe preguby/S0 baza/A S0 v2 baza cala.SLDASM

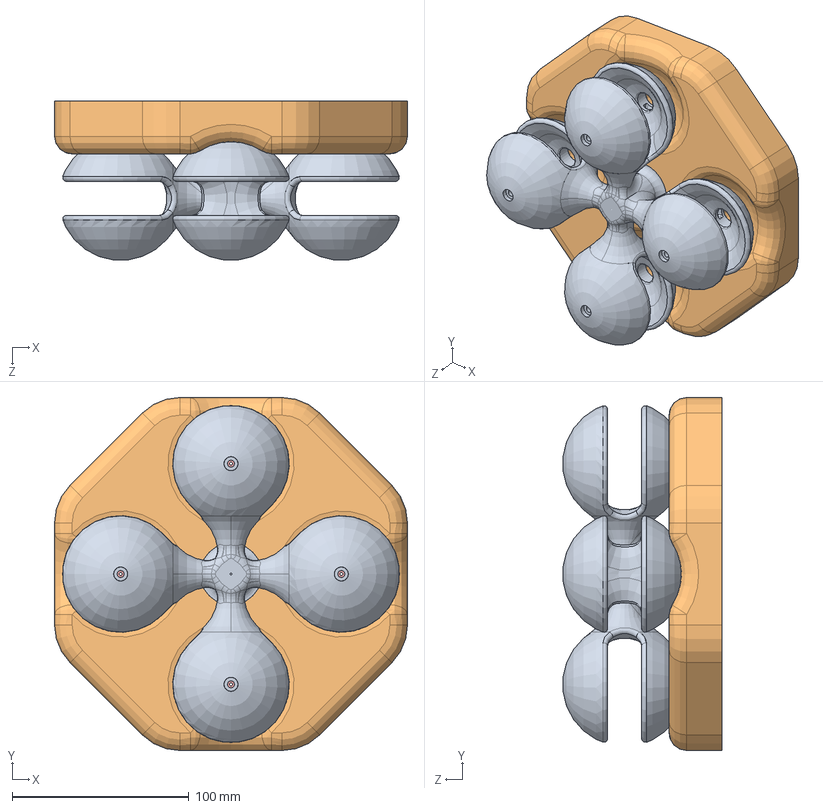
[picture p67: CAD file, 2017-05-17]
=SW 3D v2 kulkowe preguby/S0 baza/A S0 v2 baza cala.SLDASM
200.0 x 200.0 x 90.1 mm
PRT S0 obejma serwa do bazy v2 import z uniparts
PRT S0 korpus obudowa dolna v2 osmiokat
PRT STM32F103C8T6 x 3
Prt S0 lacznik baza+4obejmyPart1
PRT SingleServoArm x 4
