KubaMiszcz/Praca-Inzynierska---RoboPajak/=SW 3D v2 kulkowe preguby/S1 segment/A S1 segment.SLDASM

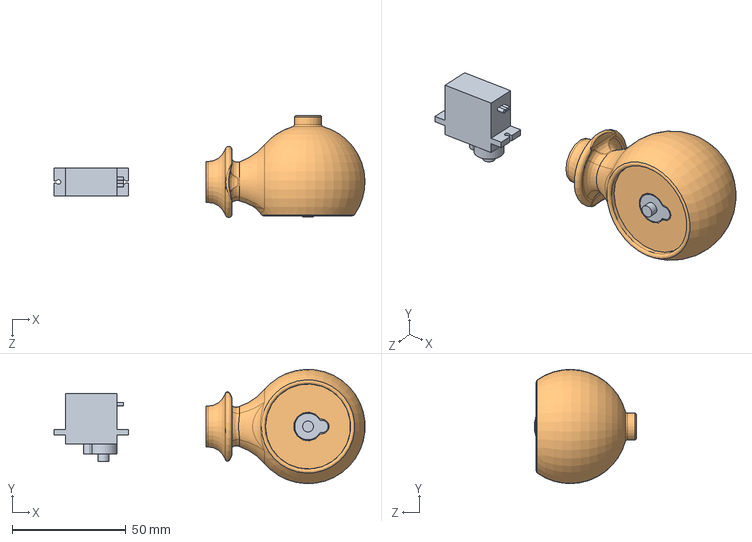
[picture p68: CAD file, 2017-05-17]
=SW 3D v2 kulkowe preguby/S1 segment/A S1 segment.SLDASM
136.9 x 50.3 x 44.9 mm
PRT servo SG90 x 2
PRT uni obudowas serwa 90st z wpustem
