KubaMiszcz/Praca-Inzynierska---RoboPajak/=SW 3D v2 kulkowe preguby/S3 segment/A S3 segment.SLDASM

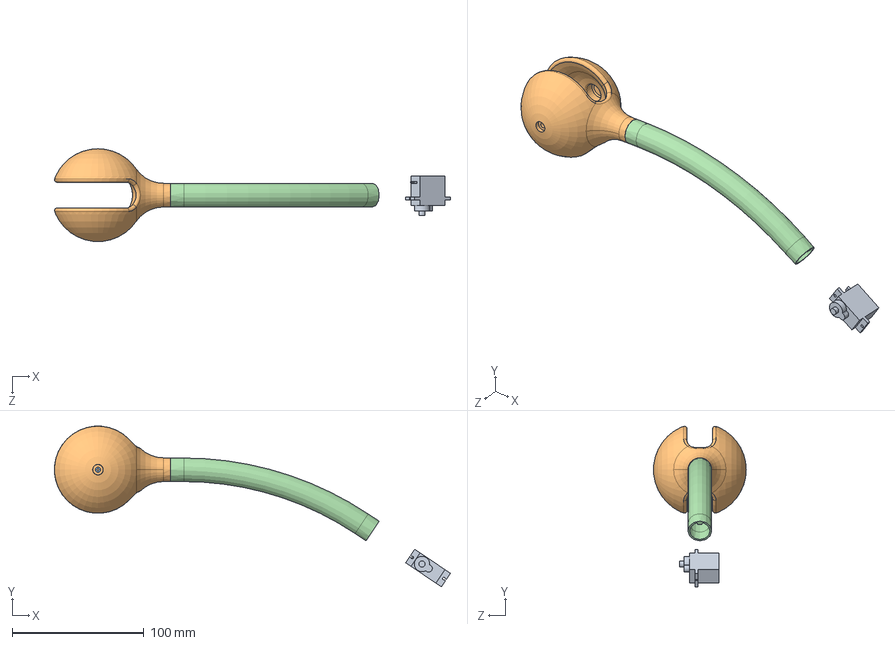
[picture p69: CAD file, 2017-05-17]
=SW 3D v2 kulkowe preguby/S3 segment/A S3 segment.SLDASM
300.0 x 121.6 x 70.1 mm
PRT servo SG90
PRT v2 uni obejma serwa ze znacznikami
PRT SingleServoArm
PRT S3 rurka v2 wygieta
