KubaMiszcz/Praca-Inzynierska---RoboPajak/=SW 3D v3 new design/A Robot caly.SLDASM

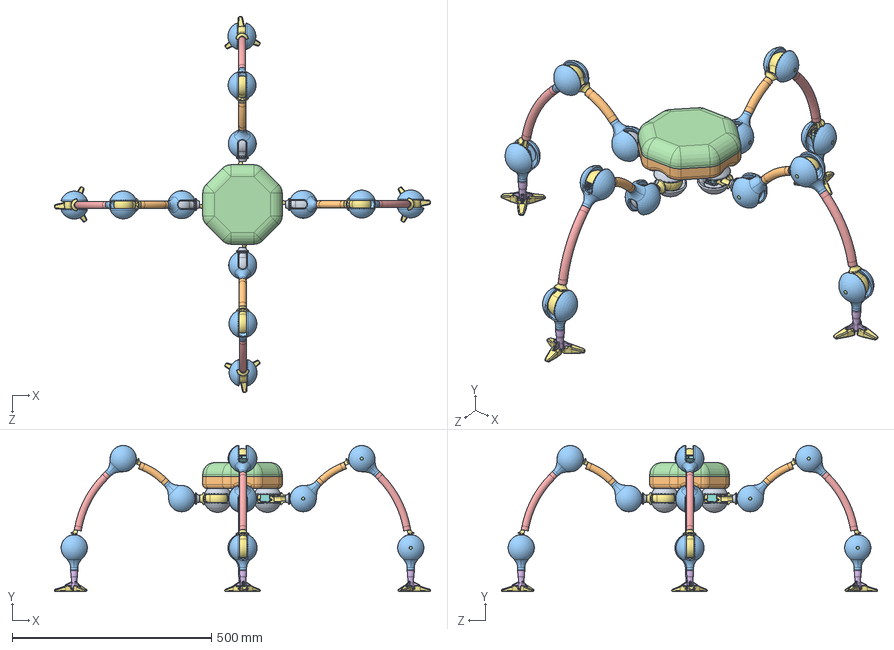
[picture p70: CAD file, 2017-05-17]
=SW 3D v3 new design/A Robot caly.SLDASM
944.3 x 366.9 x 944.3 mm
PRT S0 obejma serwa do bazy v2 import z uniparts
PRT S0 korpus obudowa dolna v2 osmiokat
PRT STM32F103C8T6 x 3
Prt S0 lacznik baza+4obejmyPart1
PRT SingleServoArm x 16
PRT uni obudowas serwa x 12
PRT servo SG90 x 16
PRT uni obudowas serwa 90st z wpustem x 4
PRT S2 rurka v2 wygieta x 4
PRT v2 uni obejma serwa ze znacznikami x 12
PRT zaslepka obejmy serwa x 12
PRT S3 rurka v2 wygieta x 4
Prt S4 golen x 4
PRT S4 palec v2 sciecie 120st x 12
