KubaMiszcz/Praca-Inzynierska---RoboPajak/=SW 3D v3 new design/S0 baza/A S0 v3 baza cala.SLDASM

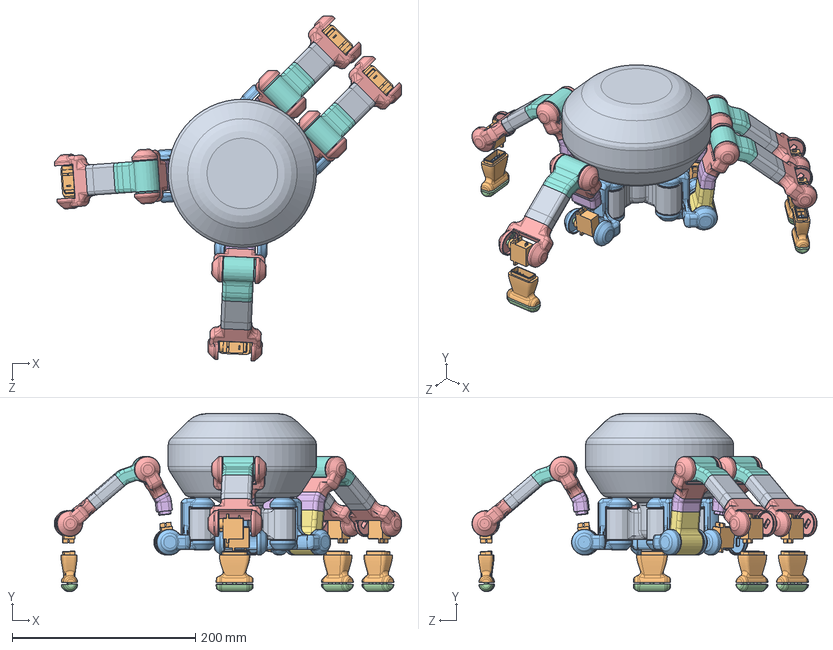
[picture p71: CAD file, 2017-05-17]
=SW 3D v3 new design/S0 baza/A S0 v3 baza cala.SLDASM
379.6 x 194.6 x 377.0 mm
P S0 v2 podstawa 4 obudowy serw
P servo SG90 x 16
P S1 v2 segment obejmy 90st x 4
P SingleServoArm x 16
P v9 uni obejma serwa szeroka rurka+1mm x 8
P S2 rurka v8 sciecia x 4
P v8a uni obudowa serwa szeroka rurak 90st x 4
P S3 rurka v9 wygieta sciecia x 4
P S4 v4 golen x 4
P endstop x 4
P S4 trzpien do endstopu x 4
