KubaMiszcz/Praca-Inzynierska---RoboPajak/=SW 3D v3 new design/S2 segment/zz/A S2 segment.SLDASM

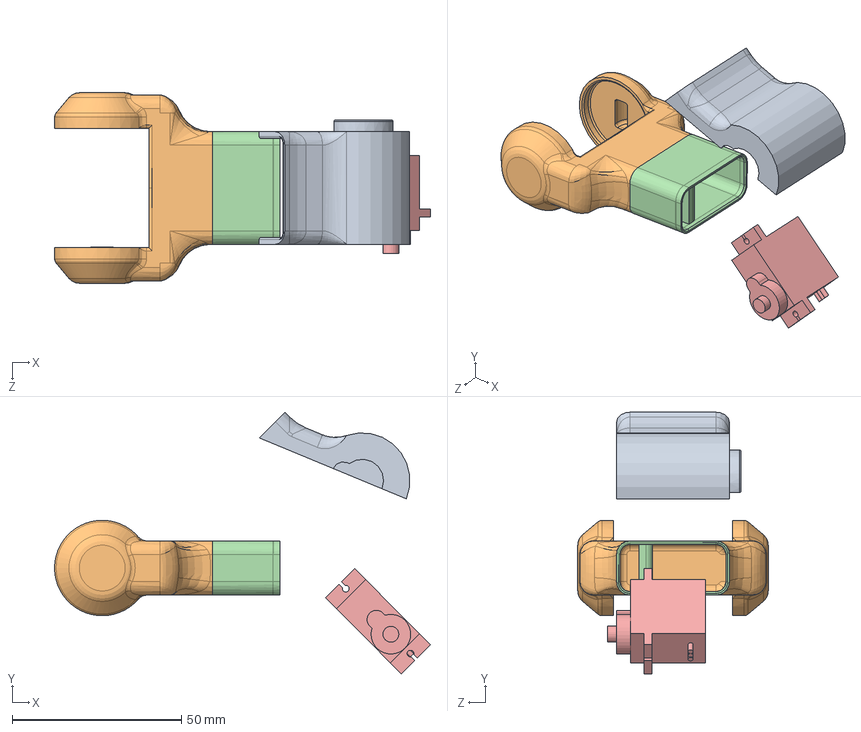
[picture p73: CAD file, 2017-05-17]
=SW 3D v3 new design/S2 segment/zz/A S2 segment.SLDASM
111.1 x 77.3 x 56.3 mm
P v8 uni obejma serwa szeroka rurka
P SingleServoArm
P S2 rurka v6
P servo SG90
P v8a uni obudowa serwa szeroka rurak 90st
