KubaMiszcz/Praca-Inzynierska---RoboPajak/zzz inne/Solidworks model3D v1/S0 - baza.SLDASM

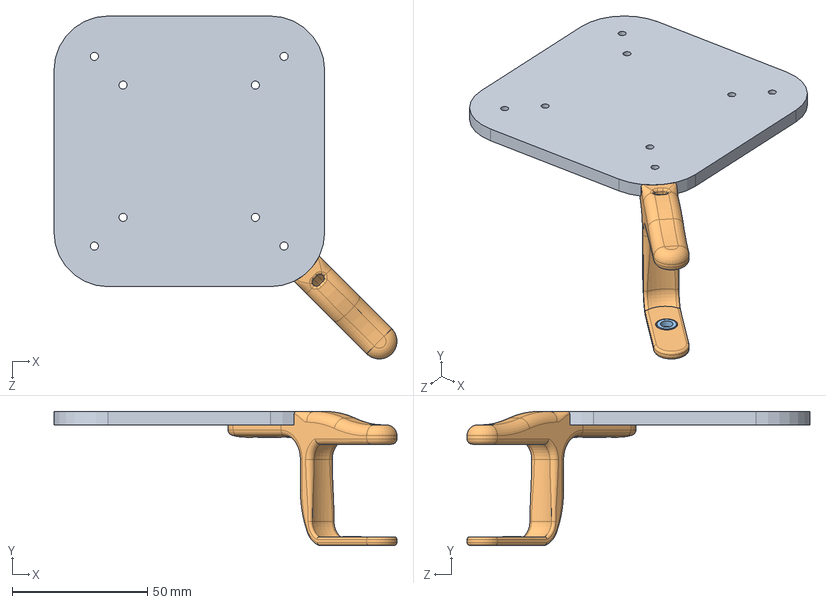
[picture p74: CAD file, 2017-05-17]
zzz inne/Solidworks model3D v1/S0 - baza.SLDASM
126.7 x 49.6 x 126.7 mm
S0 podstawa
S0 obejma serwa v2 grubsza na kabel
ServoArm
