KubaMiszcz/Praca-Inzynierska---RoboPajak/zzz inne/Solidworks model3D v1/S0 - baza/S0 obejma serwa v2 lacznik z baza.SLDASM

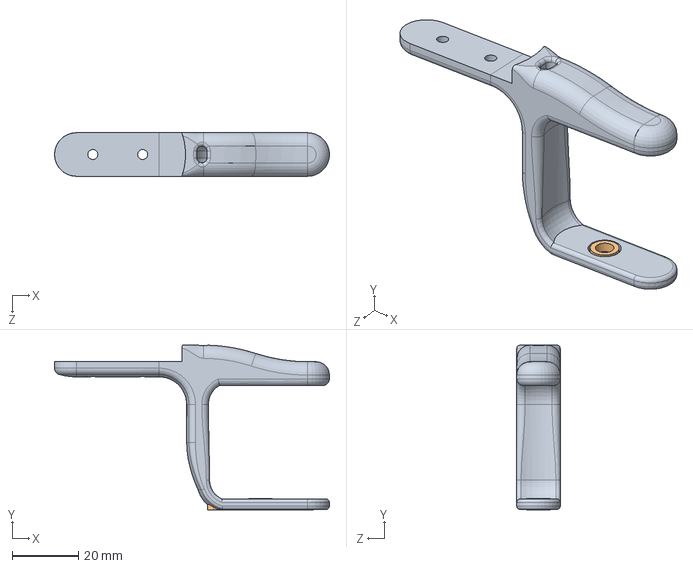
[picture p75: CAD file, 2017-05-17]
zzz inne/Solidworks model3D v1/S0 - baza/S0 obejma serwa v2 lacznik z baza.SLDASM
82.9 x 49.6 x 13.1 mm
S0 obejma serwa v2 grubsza na kabel
ServoArm
