KubaMiszcz/Praca-Inzynierska---RoboPajak/=SW 3D v2 kulkowe preguby/S0 baza/==/S0 baza.SLDASM

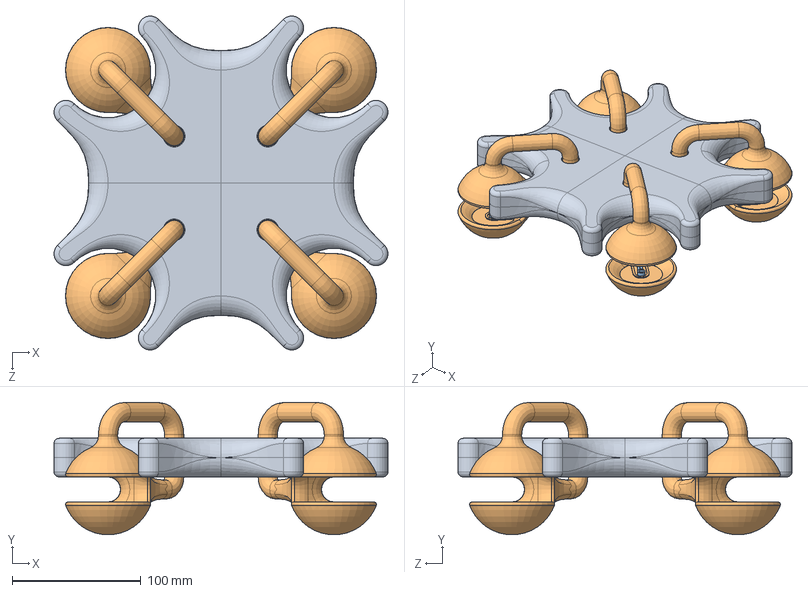
[picture p76: CAD file, 2017-05-17]
=SW 3D v2 kulkowe preguby/S0 baza/==/S0 baza.SLDASM
259.1 x 102.4 x 259.1 mm
S0 podstawa x 2
S0 obejma serwa do bazy x 4
SingleServoArm x 4
