KubaMiszcz/Praca-Inzynierska---RoboPajak/=SW 3D v2 kulkowe preguby/S0 baza/A S0 korpus obudowa + dodatki v2 osmiokat.SLDASM

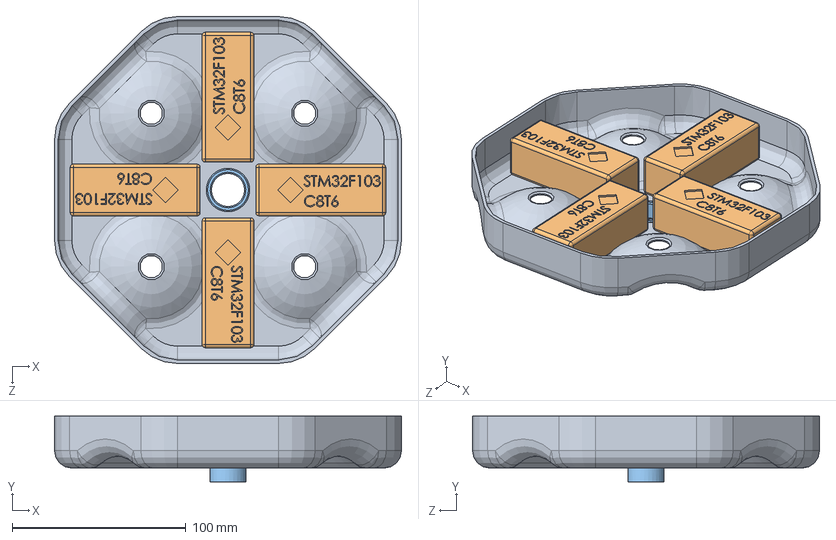
[picture p77: CAD file, 2017-05-17]
=SW 3D v2 kulkowe preguby/S0 baza/A S0 korpus obudowa + dodatki v2 osmiokat.SLDASM
200.0 x 38.0 x 200.0 mm
S0 korpus obudowa dolna v2 osmiokat
STM32F103C8T6 x 4
S0 lacznik baza+4obejmyPart1
