KubaMiszcz/Praca-Inzynierska---RoboPajak/=SW 3D v2 kulkowe preguby/S2 segment/A S2 segment.SLDASM

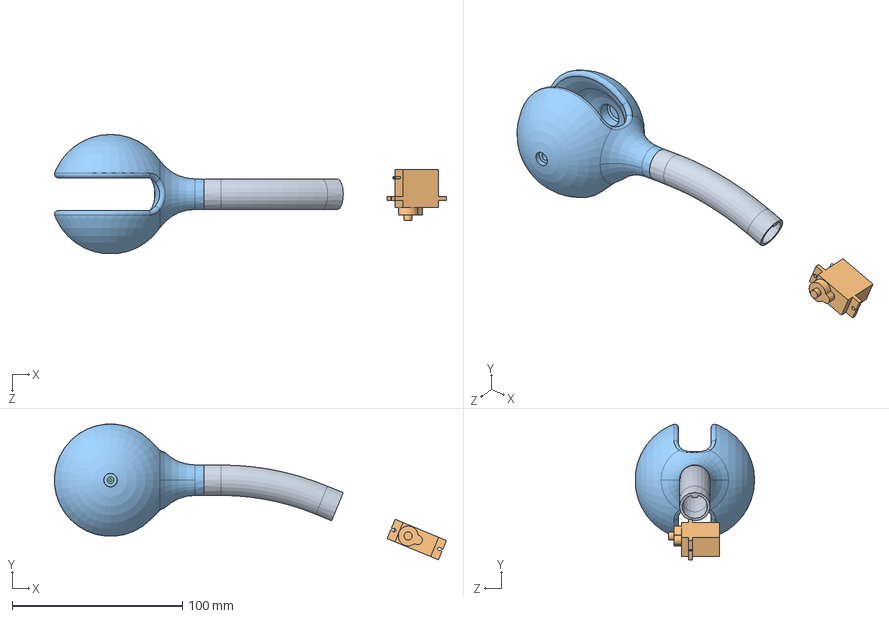
[picture p78: CAD file, 2017-05-17]
=SW 3D v2 kulkowe preguby/S2 segment/A S2 segment.SLDASM
230.5 x 79.8 x 70.1 mm
PRT S2 rurka v2 wygieta
PRT servo SG90
PRT v2 uni obejma serwa ze znacznikami
PRT SingleServoArm
