KubaMiszcz/Praca-Inzynierska---RoboPajak/=SW 3D v3 new design/S3 segment/zz/A S3 segment.SLDASM

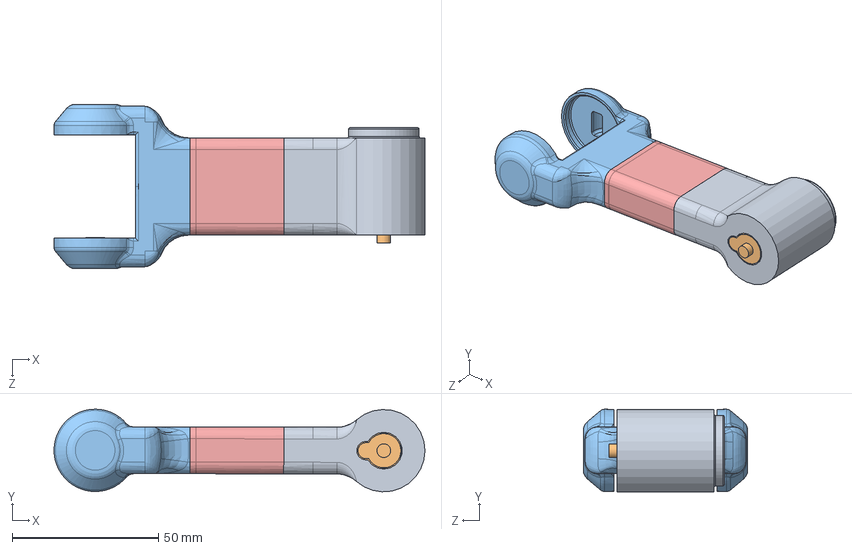
[picture p79: CAD file, 2017-05-17]
=SW 3D v3 new design/S3 segment/zz/A S3 segment.SLDASM
127.0 x 28.3 x 56.3 mm
P v8 uni obudowa serwa szeroka rurak
P servo SG90
P v8 uni obejma serwa szeroka rurka
P SingleServoArm
P S3 rurka v7 wygieta
