KubaMiszcz/Praca-Inzynierska---RoboPajak/zzz inne/Solidworks model3D v1/S1 - uchwyt do bazy.SLDASM

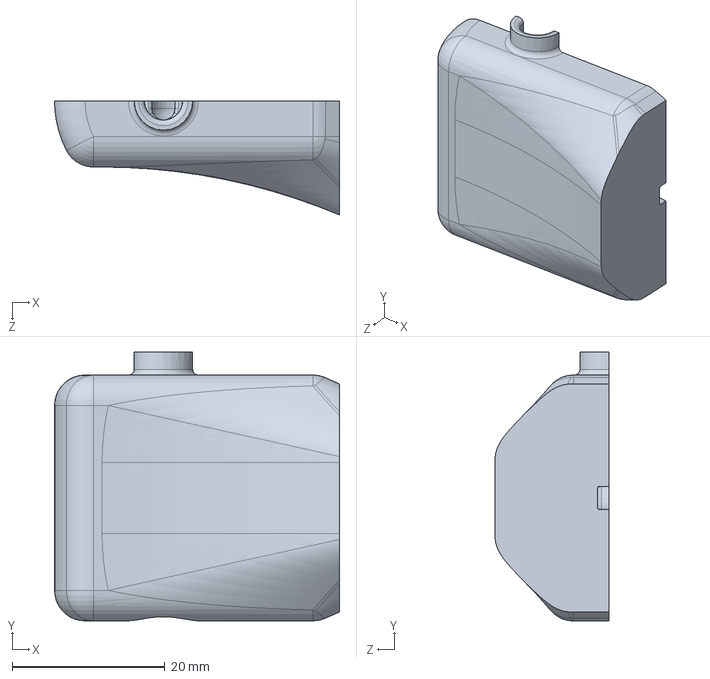
[picture p80: CAD file, 2017-05-17]
zzz inne/Solidworks model3D v1/S1 - uchwyt do bazy.SLDASM
37.3 x 35.2 x 14.9 mm
