KubaMiszcz/Praca-Inzynierska---RoboPajak/zzz inne/Solidworks model3D v1/S3 - segment/S3 servo w obudowie.SLDASM

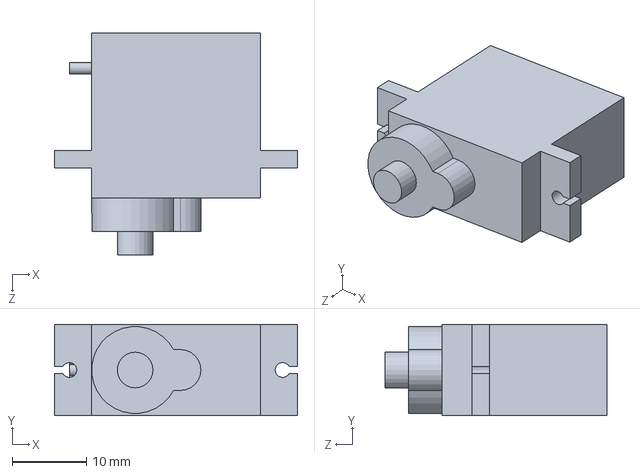
[picture p81: CAD file, 2017-05-17]
zzz inne/Solidworks model3D v1/S3 - segment/S3 servo w obudowie.SLDASM
32.7 x 12.3 x 29.9 mm
