KubaMiszcz/Praca-Inzynierska---RoboPajak/=SW 3D v2 kulkowe preguby/S0 baza/A zz S0 testy baza v2  z nogami juz.SLDASM

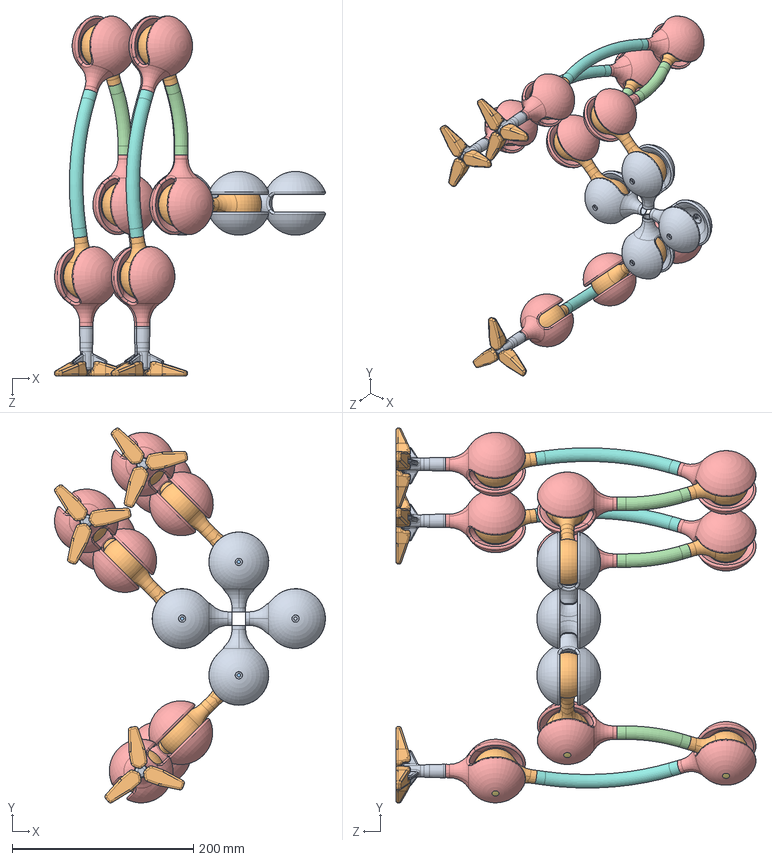
[picture p82: CAD file, 2017-05-17]
=SW 3D v3 new design/S0 baza/==/A zz S0 testy baza v2 z nogami juz.SLDASM
298.8 x 413.2 x 396.9 mm
S0 obejma serwa do bazy v2 import z uniparts
uni obudowas serwa x 12
servo SG90 x 12
S2 rurka v2 wygieta x 3
uni obejma serwa x 9
SingleServoArm x 9
zaslepka obejmy serwa x 9
S3 rurka v2 wygieta x 3
S4 golen x 3
S4 palec v2 sciecie 120st x 9
lacznik rurek x 3
