KubaMiszcz/Praca-Inzynierska---RoboPajak/=SW 3D v3 new design/S1 segment/zz/A S1 segment.SLDASM

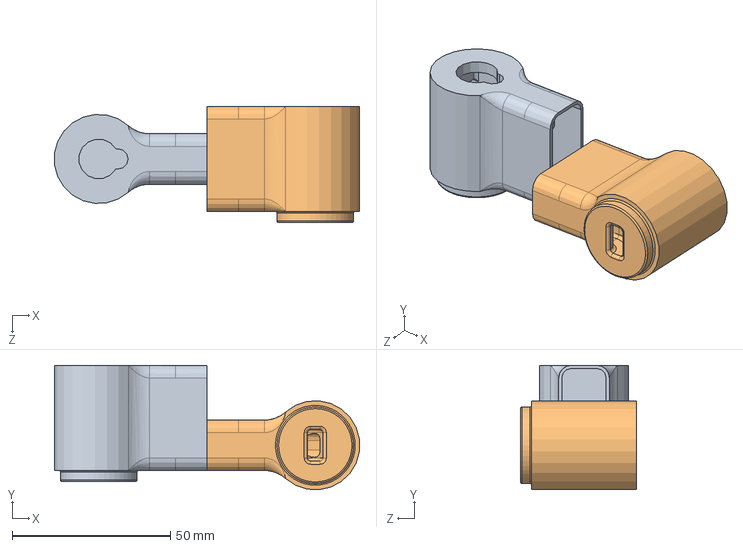
[picture p83: CAD file, 2017-05-17]
=SW 3D v3 new design/S1 segment/zz/A S1 segment.SLDASM
96.4 x 39.4 x 36.8 mm
P S1 obudowy serw o 90st
P v8 uni obudowa serwa szeroka rurak
