KubaMiszcz/Praca-Inzynierska---RoboPajak/=SW 3D v3 new design/S3 segment/A S3 v2 segment.SLDASM

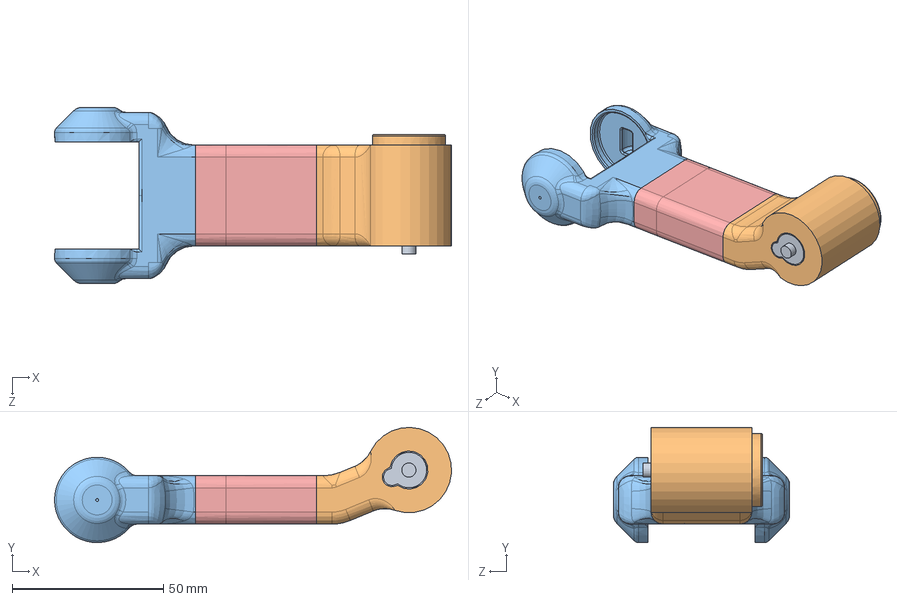
[picture p84: CAD file, 2017-05-17]
=SW 3D v3 new design/S3 segment/A S3 v2 segment.SLDASM
131.2 x 38.1 x 58.3 mm
P servo SG90
P v8a uni obudowa serwa szeroka rurak 90st
P v8 uni obejma serwa szeroka rurka
P SingleServoArm
P S3 rurka v9 wygieta sciecia
