KubaMiszcz/Praca-Inzynierska---RoboPajak/zzz inne/Solidworks model3D v1/==aROBO PAJAK CALYv2.SLDASM

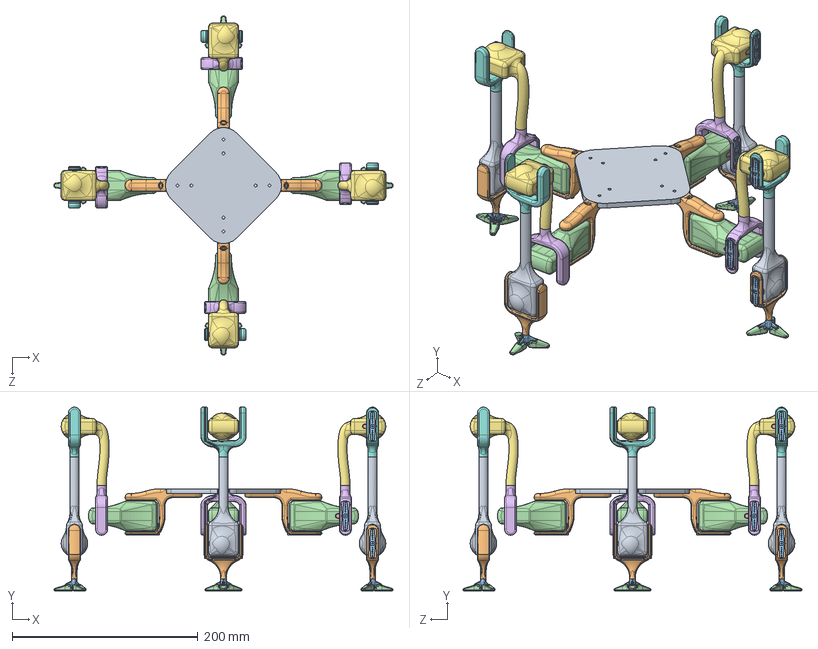
[picture p85: CAD file, 2017-05-17]
zzz inne/Solidworks model3D v1/==aROBO PAJAK CALYv2.SLDASM
364.9 x 197.8 x 364.9 mm
S0 podstawa
S0 obejma serwa v2 grubsza na kabel x 4
ServoArm x 16
S1 segment 2 obudowy na serwo v2 x 4
servo SG90 x 16
S2 obejma serwa v2 grubsza na kabel x 4
S2 obudowa na serwo v3 x 4
S3 obejma serwa v2 grubsza na kabel x 4
S3 obudowa na serwo v2 x 4
S4 obejma serwa x 4
S4 golen x 4
S4 palec v2 sciecie 120st x 12
