KubaMiszcz/Praca-Inzynierska---RoboPajak/=SW 3D v3 new design/S2 segment/A S2 v2 segment.SLDASM

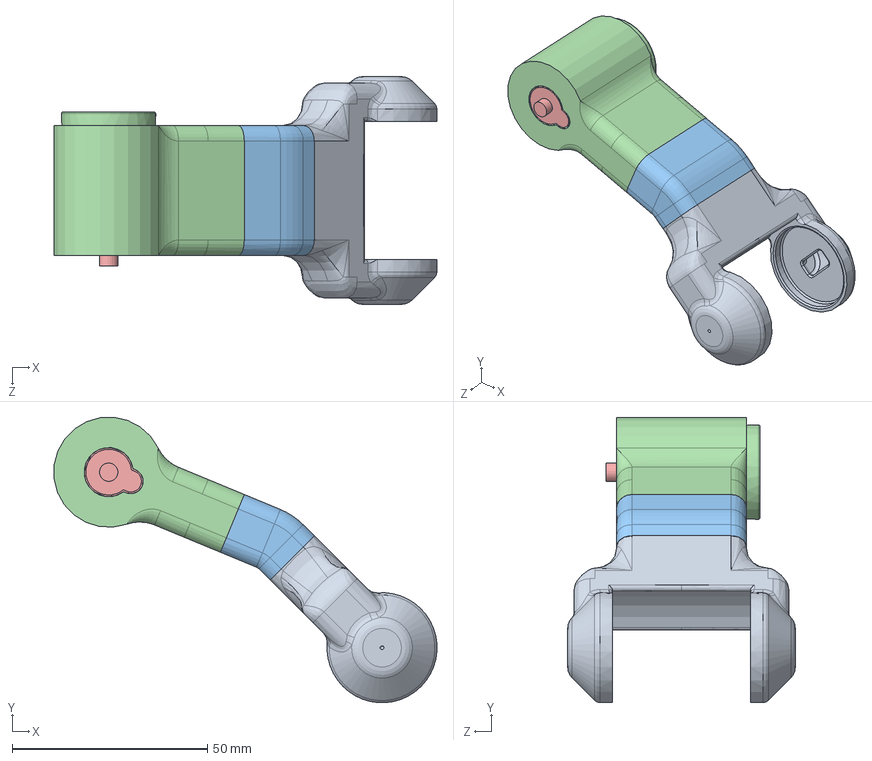
[picture p86: CAD file, 2017-05-17]
=SW 3D v3 new design/S2 segment/A S2 v2 segment.SLDASM
98.0 x 73.0 x 58.3 mm
P v8 uni obejma serwa szeroka rurka
P SingleServoArm
P S2 rurka v8 sciecia
P v9 uni obudowa serwa szeroka rurak
P servo SG90
