KubaMiszcz/Praca-Inzynierska---RoboPajak/=SW 3D v3 new design/S4 segment/test.SLDASM

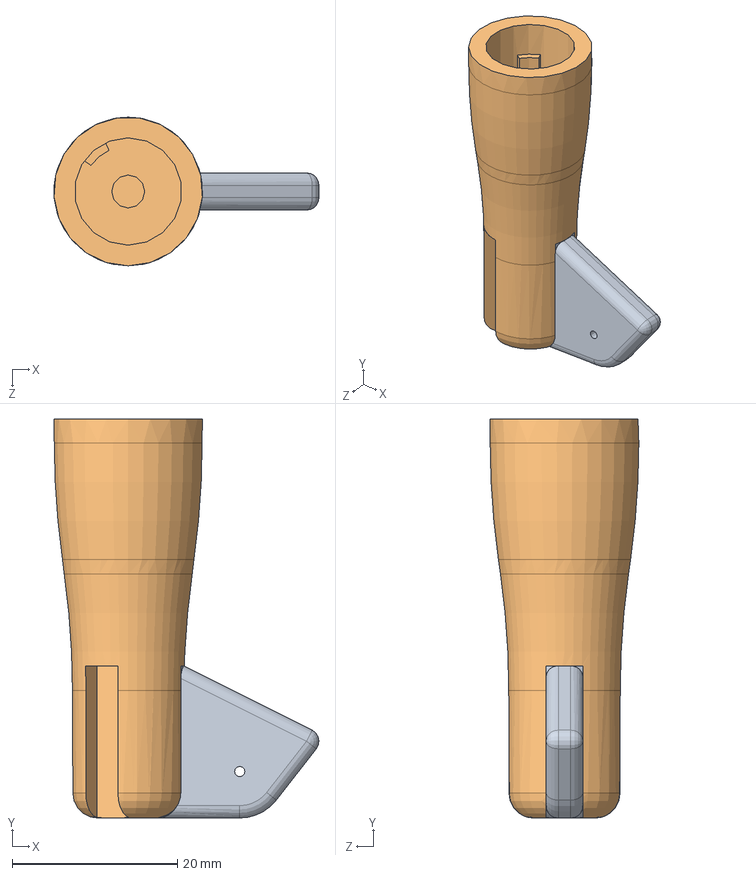
[picture p87: CAD file, 2017-05-17]
=SW 3D v3 new design/S4 segment/test.SLDASM
32.1 x 48.3 x 18.0 mm
Prt S4 uchwyt na palce do golenia
Prt S4 v3 golen bez uchwytow na palce
