KubaMiszcz/Praca-Inzynierska---RoboPajak/zzz inne/Solidworks model3D v1/servo w obudowie.SLDASM

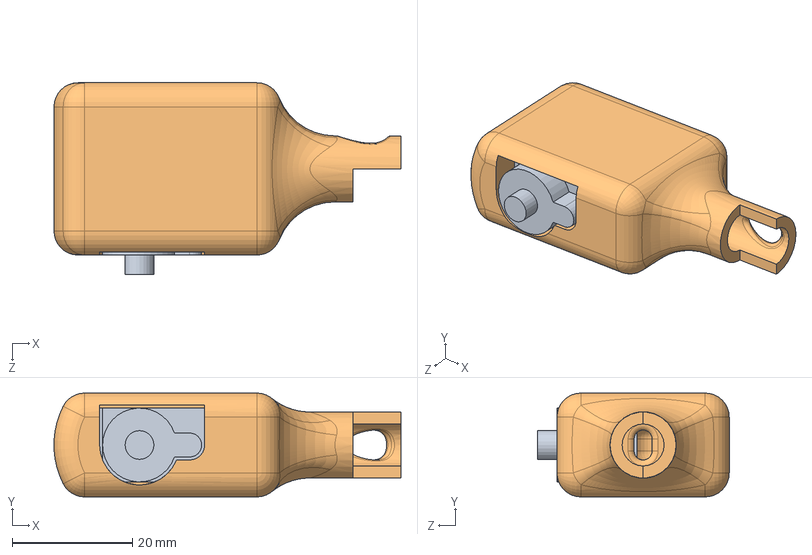
[picture p88: CAD file, 2017-05-17]
zzz inne/Solidworks model3D v1/servo w obudowie.SLDASM
57.8 x 17.3 x 31.9 mm
servo SG90
obudowa na serwo
