KubaMiszcz/Praca-Inzynierska---RoboPajak/=SW 3D v2 kulkowe preguby/parts ogolne/skasuj 3.SLDASM

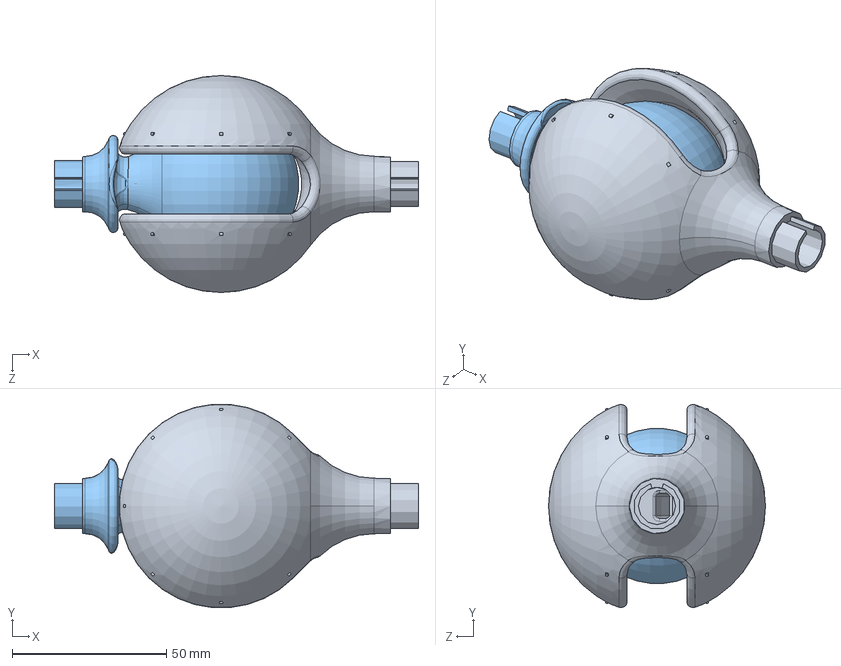
[picture p89: CAD file, 2017-05-17]
=SW 3D v2 kulkowe preguby/parts ogolne/skasuj 3.SLDASM
118.0 x 65.9 x 70.4 mm
PRT v2 uni obejma serwa ze znacznikami
PRT v3 prowadnik w obejmie
PRT v3 uni obudowa serwa
