KubaMiszcz/Praca-Inzynierska---RoboPajak/=SW 3D v3 new design/parts ogolne/A uni obudowas serwa + serwo 90st.SLDASM

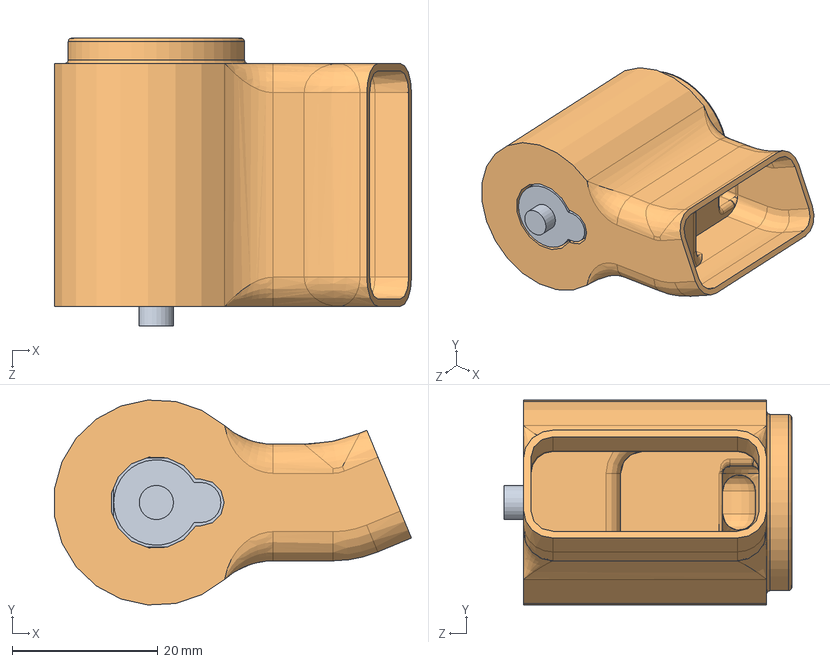
[picture p90: CAD file, 2017-05-17]
=SW 3D v3 new design/parts ogolne/A uni obudowas serwa + serwo 90st.SLDASM
49.0 x 28.1 x 39.5 mm
P servo SG90
P v8a uni obudowa serwa szeroka rurak 90st
