KubaMiszcz/Praca-Inzynierska---RoboPajak/zzz inne/Solidworks model3D v1/S3 - segment v2.SLDASM

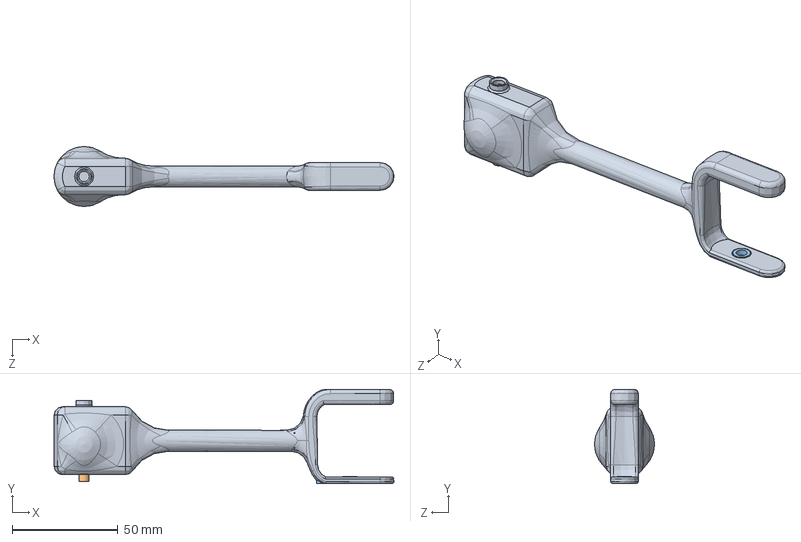
[picture p91: CAD file, 2017-05-17]
zzz inne/Solidworks model3D v1/S3 - segment v2.SLDASM
161.0 x 44.8 x 28.5 mm
S3 segment calosc v2
servo SG90
ServoArm
