KubaMiszcz/Praca-Inzynierska---RoboPajak/zzz inne/Solidworks model3D v1/==Noga1v4.SLDASM

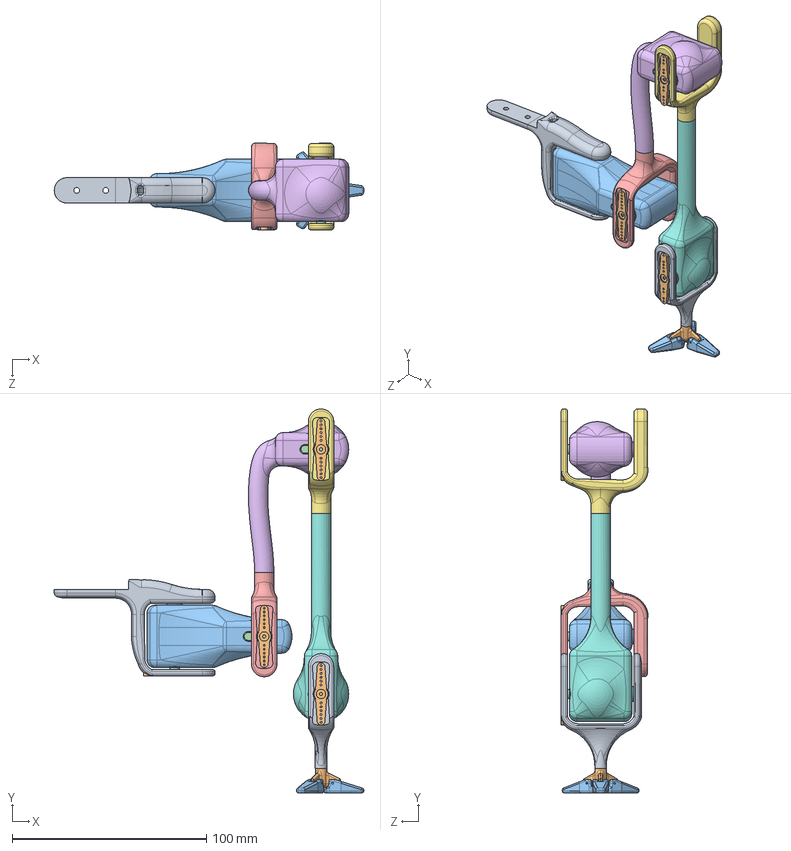
[picture p92: CAD file, 2017-05-17]
zzz inne/Solidworks model3D v1/==Noga1v4.SLDASM
159.4 x 197.8 x 44.8 mm
S0 obejma serwa v2 grubsza na kabel
ServoArm x 4
S1 segment 2 obudowy na serwo v2
servo SG90 x 4
S2 obejma serwa v2 grubsza na kabel
S2 obudowa na serwo v3
S3 obejma serwa v2 grubsza na kabel
S3 obudowa na serwo v2
S4 obejma serwa
S4 golen
S4 palec v2 sciecie 120st x 3
