KubaMiszcz/Praca-Inzynierska---RoboPajak/=SW 3D v2 kulkowe preguby/parts ogolne/skausj.SLDASM

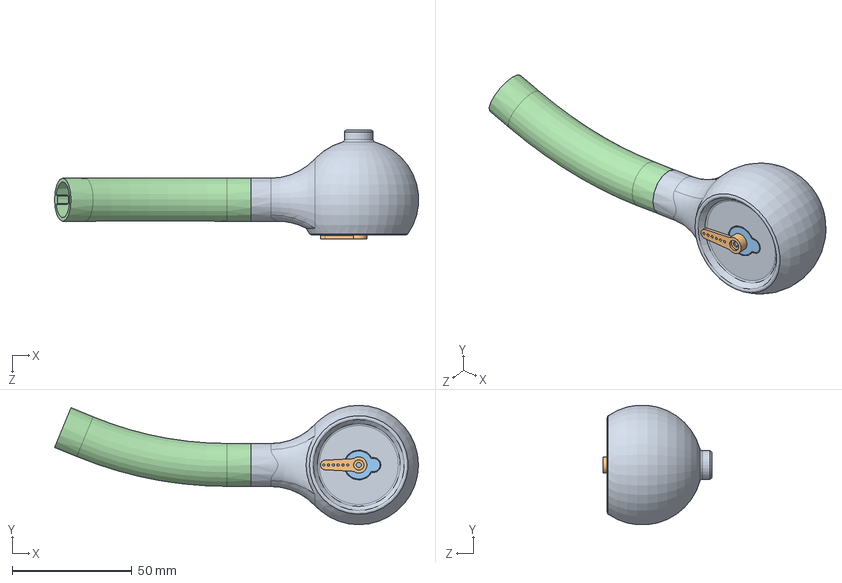
[picture p93: CAD file, 2017-05-17]
=SW 3D v2 kulkowe preguby/parts ogolne/skausj.SLDASM
151.8 x 49.8 x 45.3 mm
P v3 uni obudowa serwa
P servo SG90
P S2 rurka v2 wygieta
