KubaMiszcz/Praca-Inzynierska---RoboPajak/zzz inne/Solidworks model3D v1/S4 - segment.SLDASM

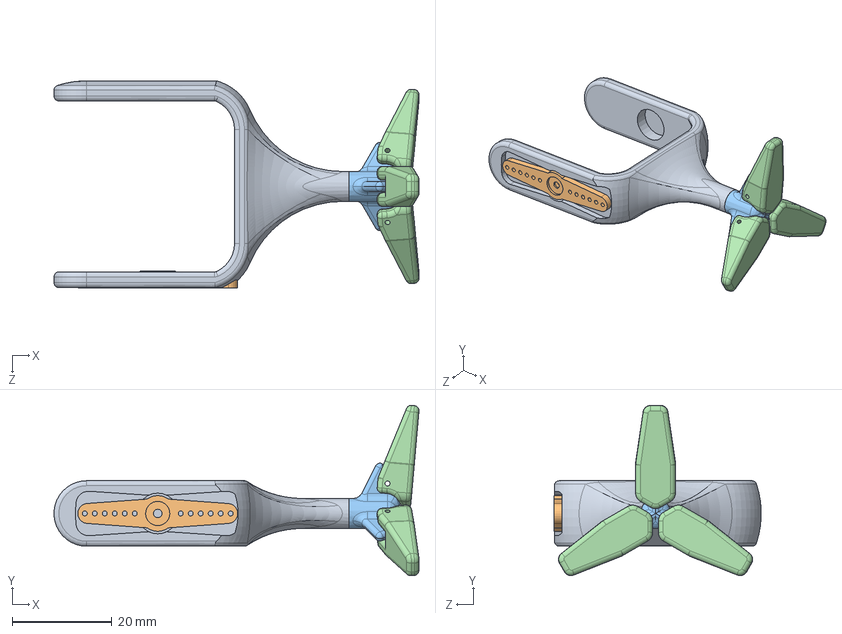
[picture p94: CAD file, 2017-05-17]
zzz inne/Solidworks model3D v1/S4 - segment.SLDASM
73.1 x 34.1 x 41.5 mm
S4 obejma serwa
ServoArm
S4 golen
S4 palec v2 sciecie 120st x 3
