KubaMiszcz/Praca-Inzynierska---RoboPajak/zzz inne/Solidworks model3D v1/S2 - segment.SLDASM

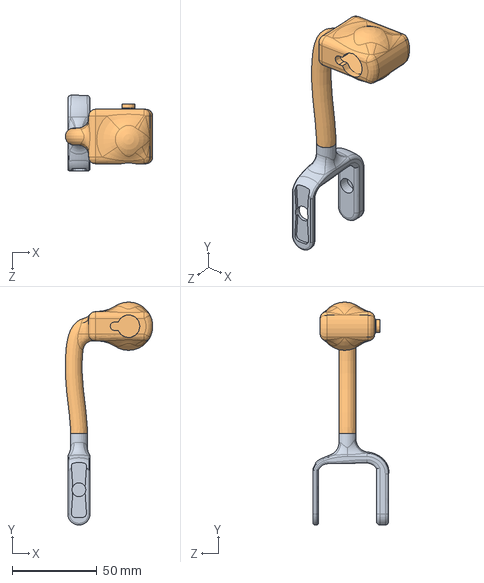
[picture p95: CAD file, 2017-05-17]
zzz inne/Solidworks model3D v1/S2 - segment.SLDASM
51.5 x 131.4 x 44.7 mm
S2 obejma serwa v2 grubsza na kabel
S2 obudowa na serwo v3
