KubaMiszcz/Praca-Inzynierska---RoboPajak/zzz inne/Solidworks model3D v1/S2 - segment/S2 servo w obudowie v2.SLDASM

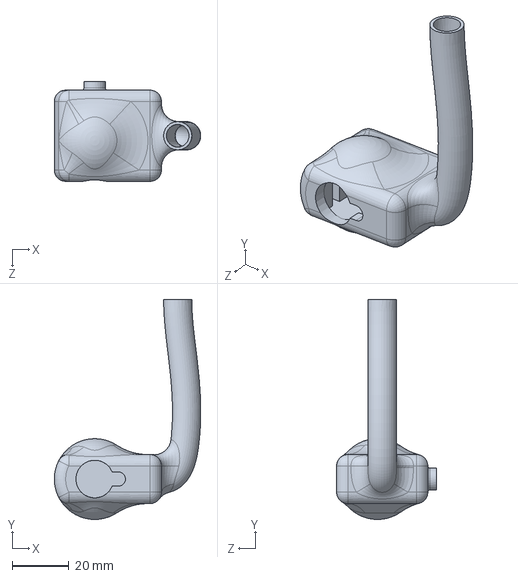
[picture p96: CAD file, 2017-05-17]
zzz inne/Solidworks model3D v1/S2 - segment/S2 servo w obudowie v2.SLDASM
51.7 x 77.6 x 35.2 mm
