KubaMiszcz/Praca-Inzynierska---RoboPajak/=SW 3D v3 new design/parts ogolne/zzzzzz v2 testowy przegub.SLDASM

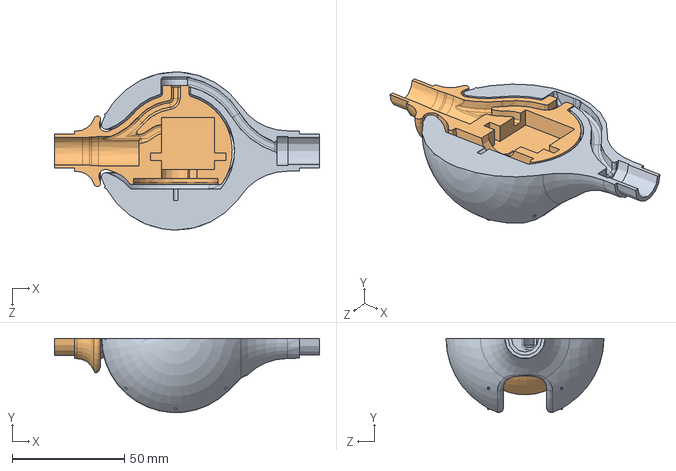
[picture p97: CAD file, 2017-05-17]
=SW 3D v3 new design/parts ogolne/zzzzzz v2 testowy przegub.SLDASM
118.0 x 33.0 x 70.4 mm
PRT v2 uni obejma serwa ze znacznikami
PRT uni obudowas serwa
