KubaMiszcz/Praca-Inzynierska---RoboPajak/zzz inne/Solidworks model3D v1/skasuj.SLDASM

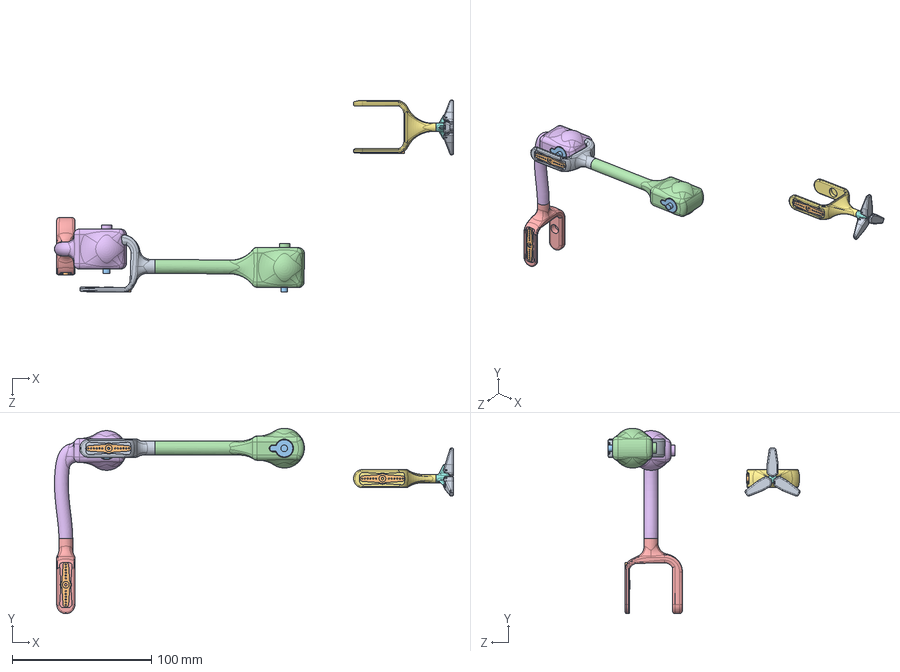
[picture p98: CAD file, 2017-05-17]
zzz inne/Solidworks model3D v1/skasuj.SLDASM
286.4 x 133.1 x 138.1 mm
S3 obejma serwa v2 grubsza na kabel
ServoArm x 3
servo SG90 x 2
S3 obudowa na serwo v2
S2 obejma serwa v2 grubsza na kabel
S2 obudowa na serwo v2
S4 obejma serwa
S4 golen
S4 palec v2 sciecie 120st x 3
