KubaMiszcz/Praca-Inzynierska---RoboPajak/=SW 3D v3 new design/parts ogolne/zz przegub testy.SLDASM

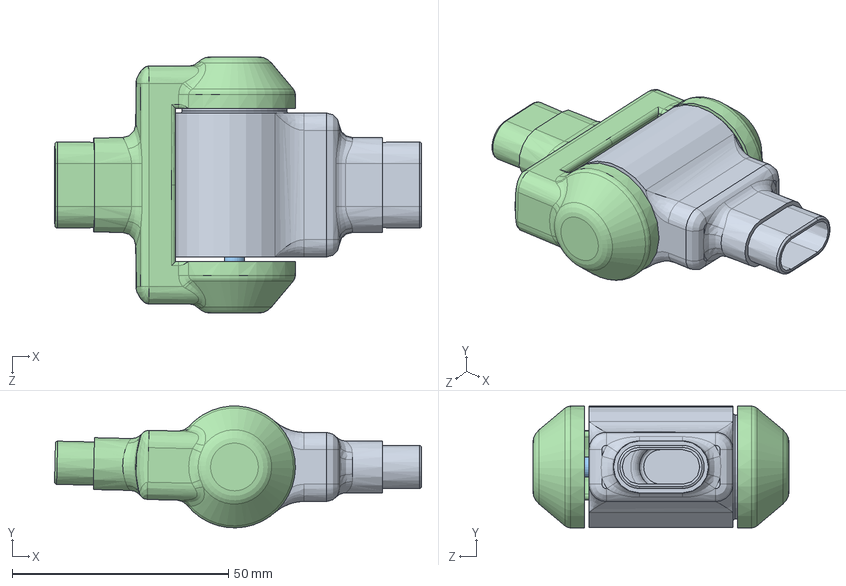
[picture p99: CAD file, 2017-05-17]
=SW 3D v3 new design/parts ogolne/zz przegub testy.SLDASM
84.9 x 28.2 x 59.3 mm
P v5 uni obudowa serwa
P SingleServoArm
P servo SG90
P v5 uni obejma serwa
