KubaMiszcz/Praca-Inzynierska---RoboPajak/=SW 3D v3 new design/parts ogolne/A uni obejma serwa + arm.SLDASM

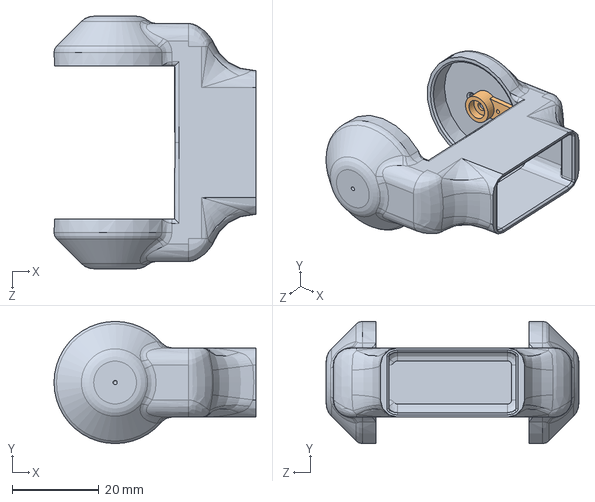
[picture p100: CAD file, 2017-05-17]
=SW 3D v3 new design/parts ogolne/A uni obejma serwa + arm.SLDASM
46.6 x 28.2 x 58.3 mm
P v8 uni obejma serwa szeroka rurka
P SingleServoArm
