KubaMiszcz/Praca-Inzynierska---RoboPajak/=SW 3D v3 new design/parts ogolne/A uni obudowas serwa + serwo.SLDASM

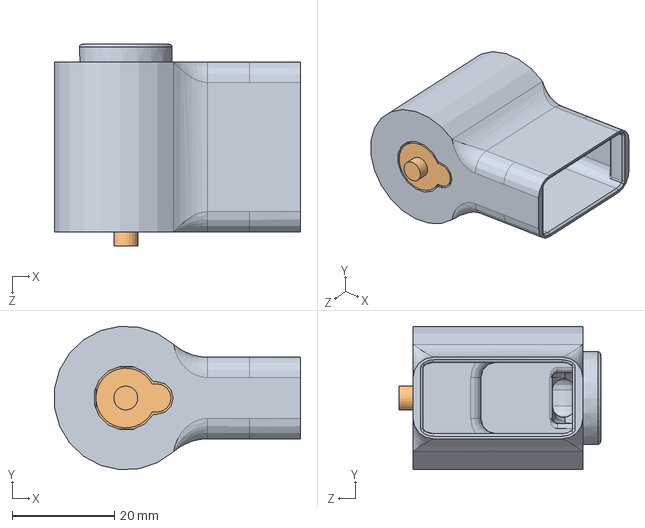
[picture p101: CAD file, 2017-05-17]
=SW 3D v3 new design/parts ogolne/A uni obudowas serwa + serwo.SLDASM
48.2 x 28.1 x 39.5 mm
P v9 uni obudowa serwa szeroka rurak
P servo SG90
