KubaMiszcz/Praca-Inzynierska---RoboPajak/=SW 3D v2 kulkowe preguby/parts ogolne/A uni obejma serwa + arm.SLDASM

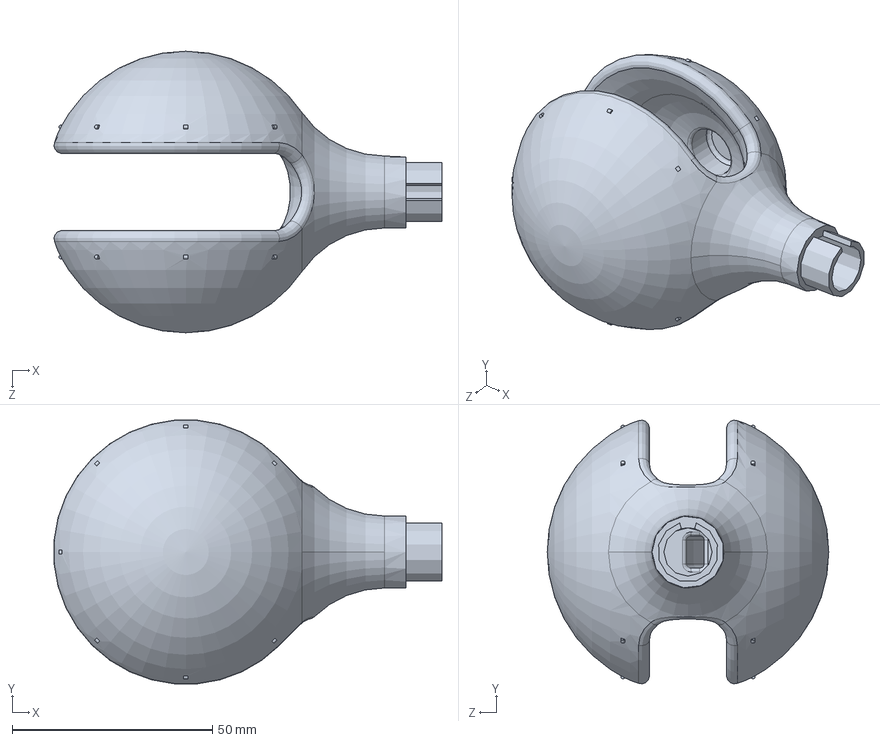
[picture p102: CAD file, 2017-05-17]
=SW 3D v2 kulkowe preguby/parts ogolne/A uni obejma serwa + arm.SLDASM
96.9 x 65.9 x 70.4 mm
PRT v2 uni obejma serwa ze znacznikami
PRT SingleServoArm
