KubaMiszcz/Praca-Inzynierska---RoboPajak/=SW 3D v2 kulkowe preguby/parts ogolne/STL v2 uni obej mniejsze pol.STL

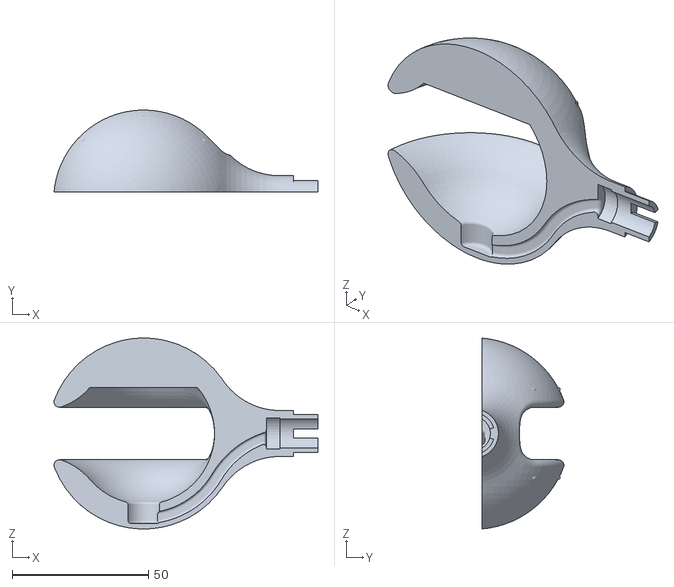
[picture p103: CAD file, 2017-05-17]
=SW 3D v2 kulkowe preguby/parts ogolne/STL v2 uni obej mniejsze pol.STL
96.9 x 30.1 x 70.1
