KubaMiszcz/Praca-Inzynierska---RoboPajak/=SW 3D v2 kulkowe preguby/S1 segment/zz/P S1 dwie obejmy 90st part.SLDPRT

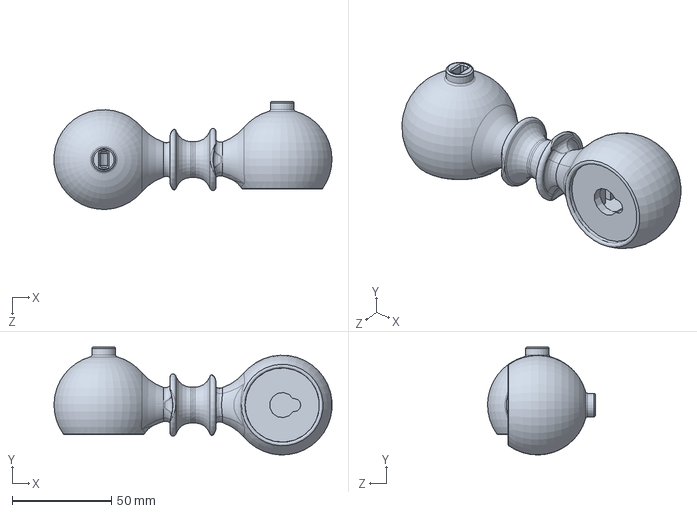
[picture p104: CAD file, 2017-05-17]
=SW 3D v2 kulkowe preguby/S1 segment/zz/P S1 dwie obejmy 90st part.SLDPRT
140.2 x 54.4 x 54.4 mm
