KubaMiszcz/Praca-Inzynierska---RoboPajak/=SW 3D v2 kulkowe preguby/S2 segment/STL S2 rurka v2 wygieta lewa.STL

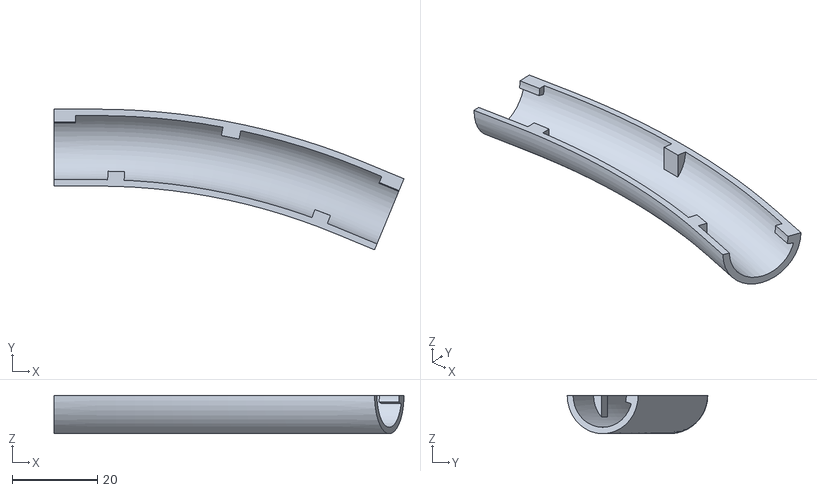
[picture p105: CAD file, 2017-05-17]
=SW 3D v2 kulkowe preguby/S2 segment/STL S2 rurka v2 wygieta lewa.STL
81.9 x 32.9 x 9.00
