KubaMiszcz/Praca-Inzynierska---RoboPajak/=SW 3D v2 kulkowe preguby/S3 segment/STL S3 rurka v2 wygieta.STL

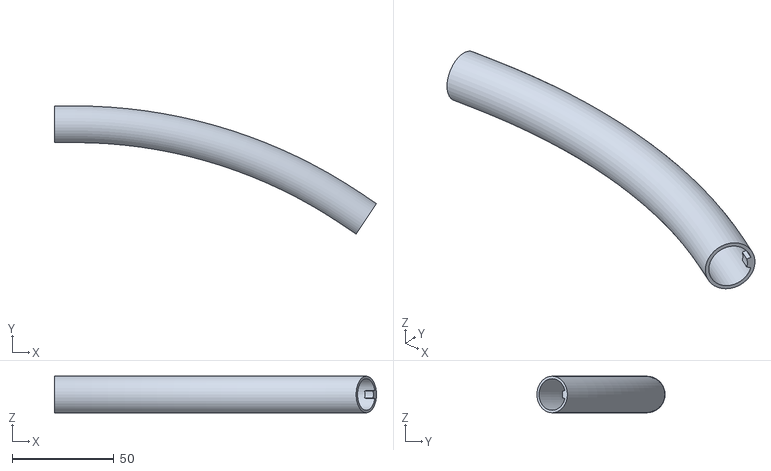
[picture p106: CAD file, 2017-05-17]
=SW 3D v2 kulkowe preguby/S3 segment/STL S3 rurka v2 wygieta.STL
158.1 x 62.9 x 18.0
