KubaMiszcz/Praca-Inzynierska---RoboPajak/=SW 3D v2 kulkowe preguby/S4 segment/==/P S4 golen ze szpicem.SLDPRT

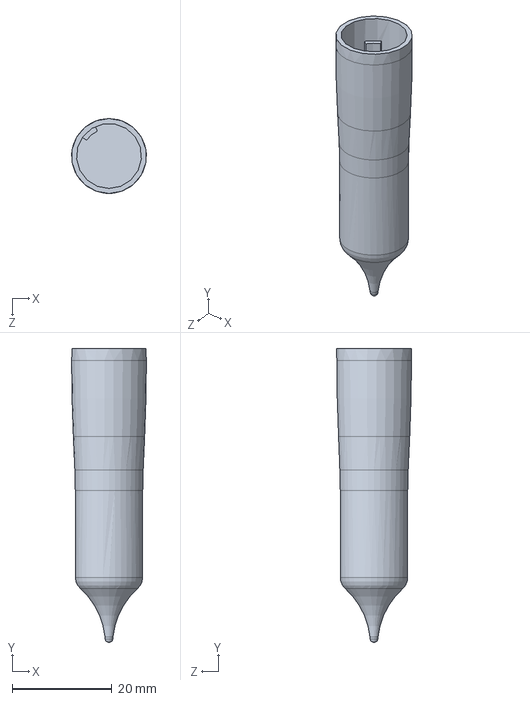
[picture p107: CAD file, 2017-05-17]
=SW 3D v2 kulkowe preguby/S4 segment/==/P S4 golen ze szpicem.SLDPRT
15.0 x 58.8 x 15.0 mm
