KubaMiszcz/Praca-Inzynierska---RoboPajak/=SW 3D v2 kulkowe preguby/zzz testy/gwint.SLDPRT

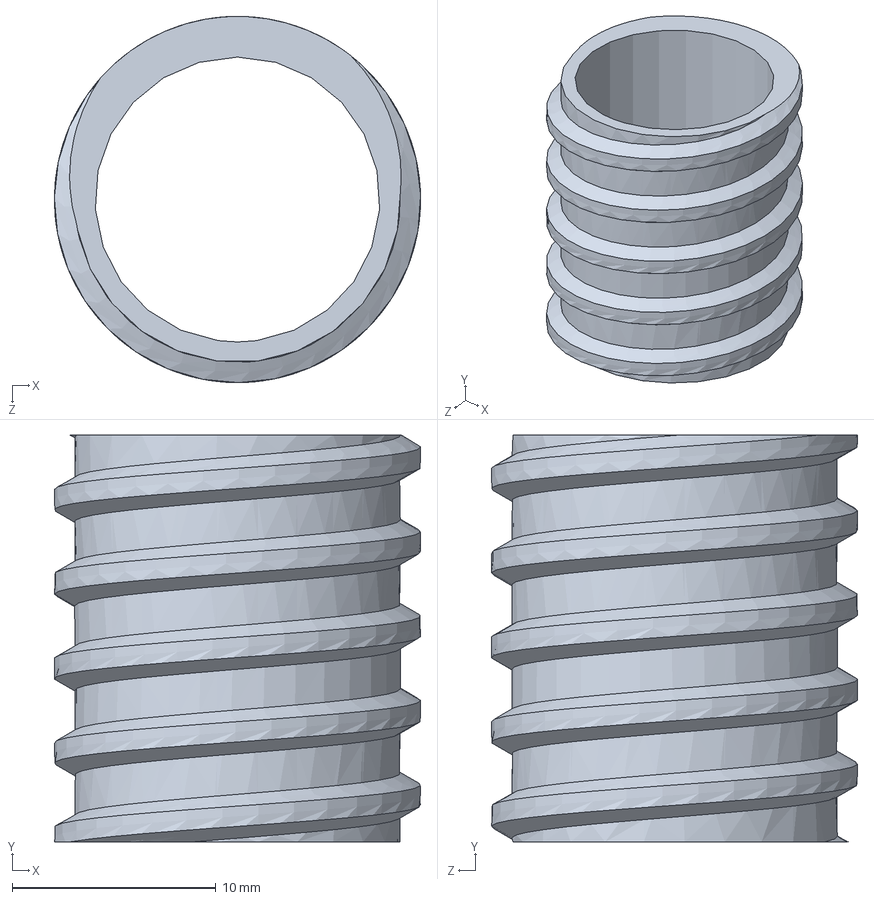
[picture p108: CAD file, 2017-05-17]
=SW 3D v2 kulkowe preguby/zzz testy/gwint.SLDPRT
18.0 x 20.0 x 18.0 mm
