KubaMiszcz/Praca-Inzynierska---RoboPajak/=SW 3D v3 new design/parts ogolne/rozkladobejmyproste.stl

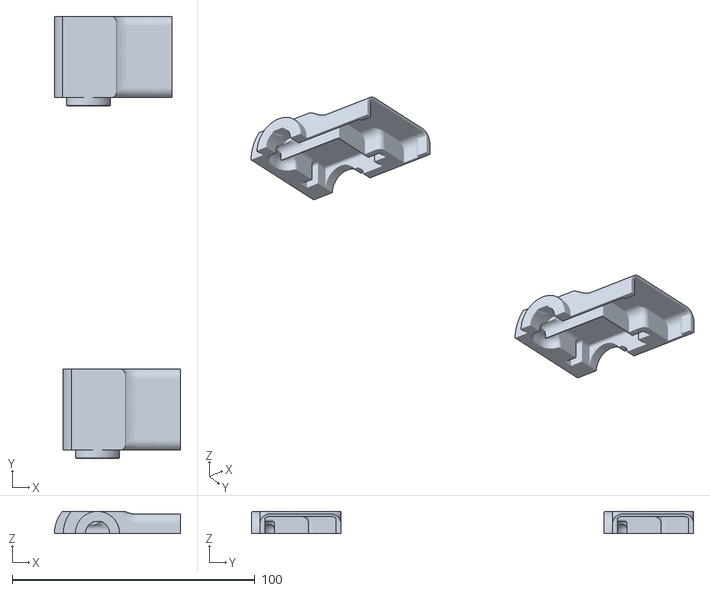
[picture p109: CAD file, 2017-06-12]
=SW 3D v3 new design/parts ogolne/rozkladobejmyproste.stl
52.0 x 181.9 x 9.10
