KubaMiszcz/Praca-Inzynierska---RoboPajak/=SW 3D v3 new design/parts ogolne/zz/P lacznik rurek wciecia 90st.SLDPRT

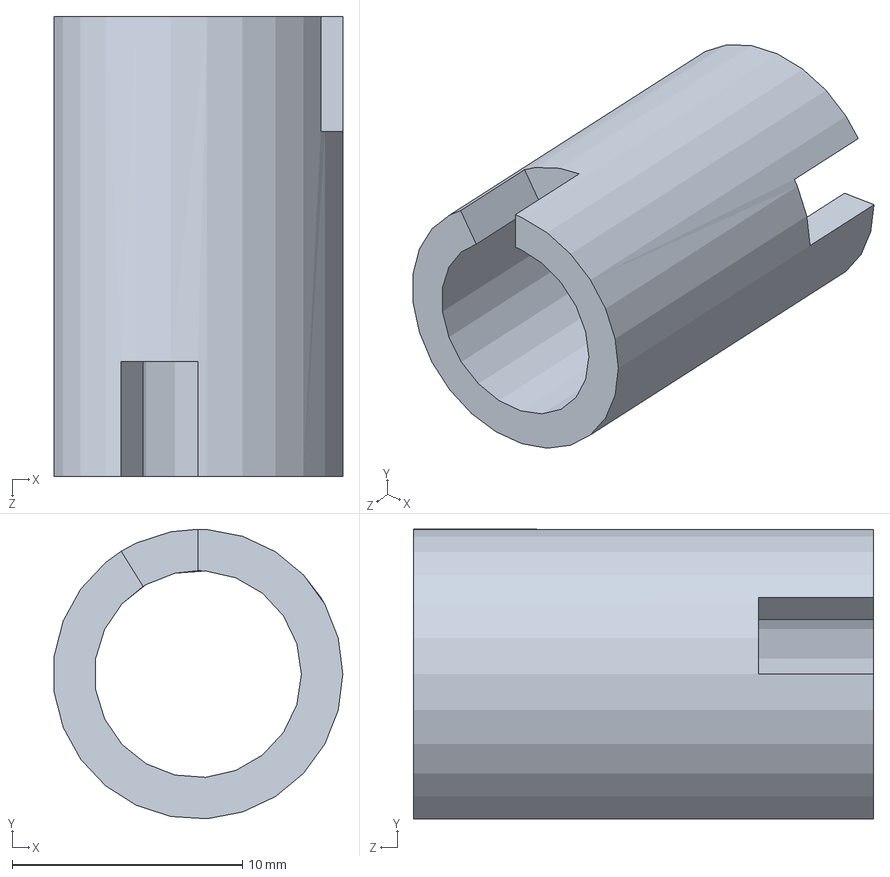
[picture p110: CAD file, 2017-05-17]
=SW 3D v3 new design/parts ogolne/zz/P lacznik rurek wciecia 90st.SLDPRT
12.6 x 12.6 x 20.0 mm
