KubaMiszcz/Praca-Inzynierska---RoboPajak/=SW 3D v3 new design/S1 segment/P S1 v2 segment obejmy 90st.SLDPRT

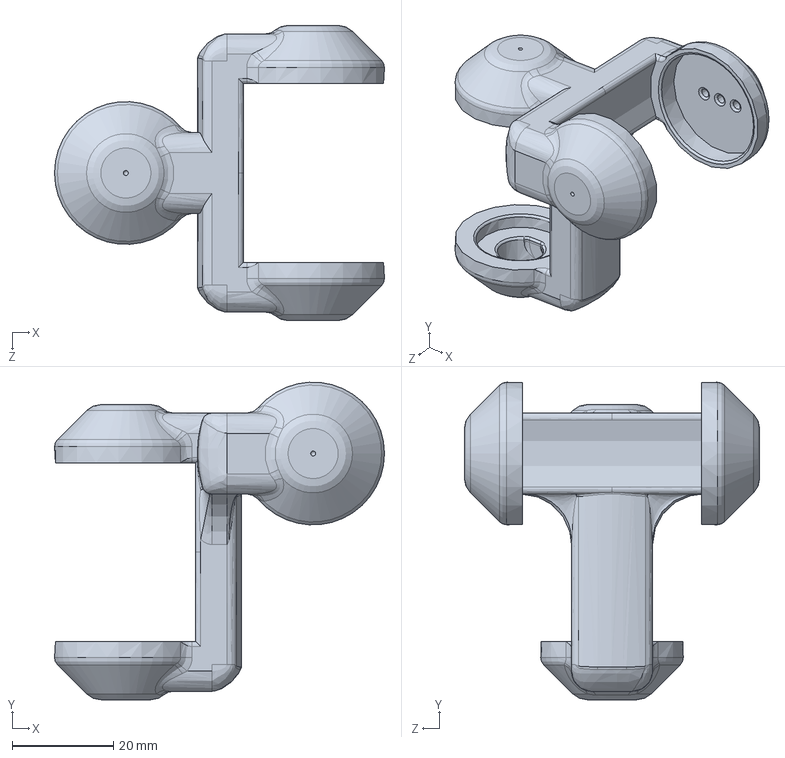
[picture p111: CAD file, 2017-05-17]
=SW 3D v3 new design/S1 segment/P S1 v2 segment obejmy 90st.SLDPRT
65.2 x 62.7 x 58.3 mm
