KubaMiszcz/Praca-Inzynierska---RoboPajak/=SW 3D v3 new design/S2 segment/zz/P S2 rurka v5.SLDPRT

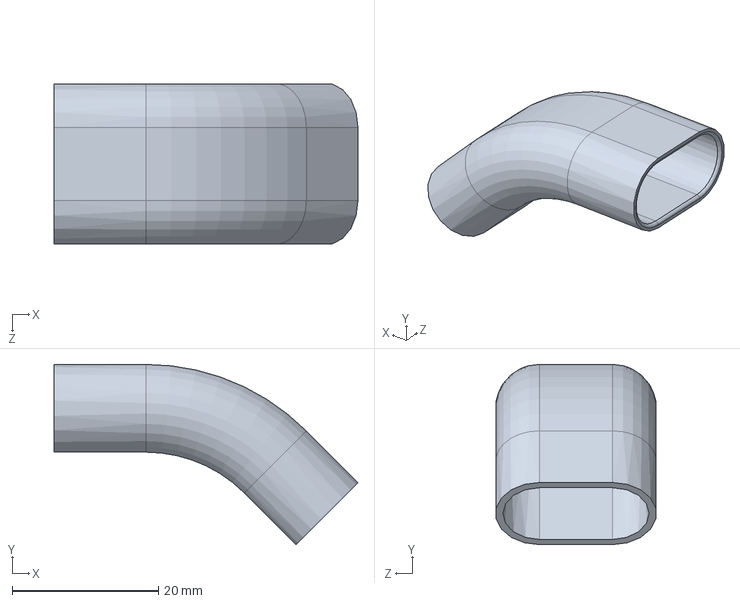
[picture p112: CAD file, 2017-05-17]
=SW 3D v3 new design/S2 segment/zz/P S2 rurka v5.SLDPRT
41.6 x 24.6 x 21.9 mm
