KubaMiszcz/Praca-Inzynierska---RoboPajak/=SW 3D v3 new design/S3 segment/P S3 rurka v7 wygieta.SLDPRT

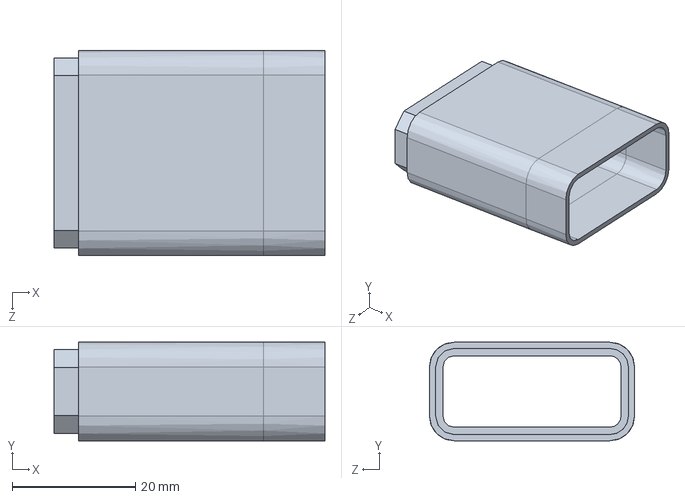
[picture p113: CAD file, 2017-05-17]
=SW 3D v3 new design/S3 segment/P S3 rurka v7 wygieta.SLDPRT
44.0 x 16.0 x 33.3 mm
