KubaMiszcz/Praca-Inzynierska---RoboPajak/=SW 3D v3 new design/S3 segment/zz/P S3 rurka v2 wygieta.SLDPRT

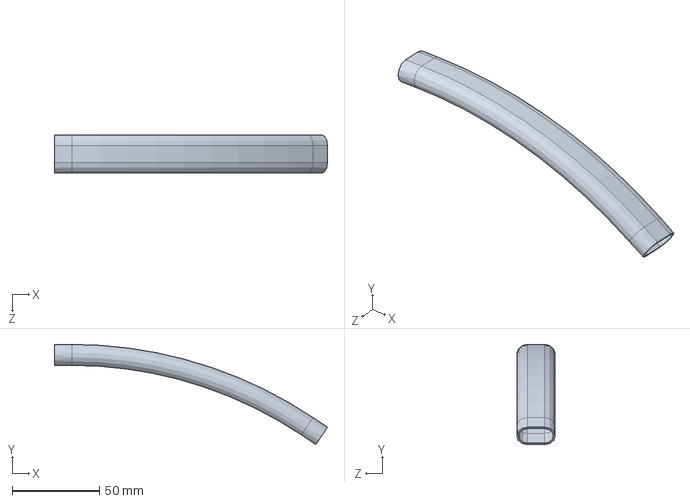
[picture p114: CAD file, 2017-05-17]
=SW 3D v3 new design/S3 segment/zz/P S3 rurka v2 wygieta.SLDPRT
156.4 x 57.4 x 22.0 mm
