KubaMiszcz/Praca-Inzynierska---RoboPajak/=SW 3D v3 new design/z parts fabryczne i dodatki/P SingleServoArm.SLDPRT

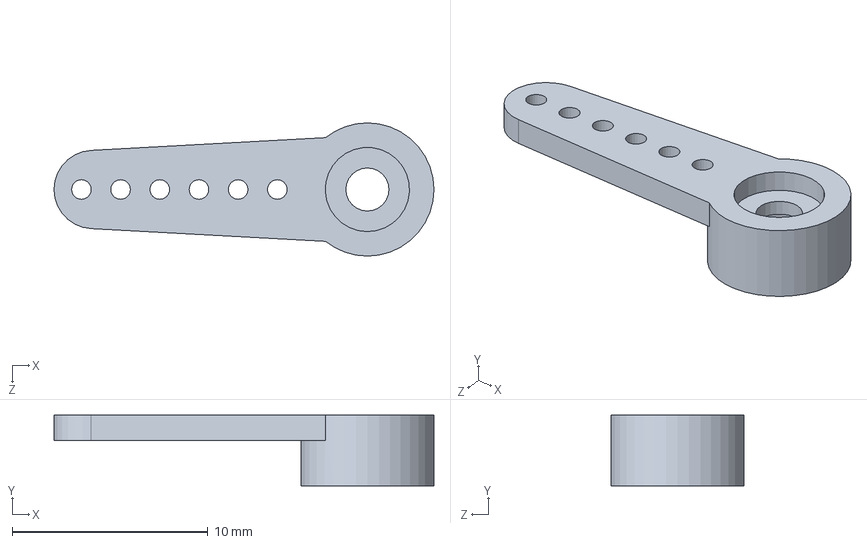
[picture p115: CAD file, 2017-05-17]
=SW 3D v3 new design/z parts fabryczne i dodatki/P SingleServoArm.SLDPRT
19.4 x 3.60 x 6.80 mm
