KubaMiszcz/Praca-Inzynierska---RoboPajak/plytka MKV30F128Vxx10P/MKV30F128VFL10P/DXF/2016-12-16_17-09-52/Library_View.dxf

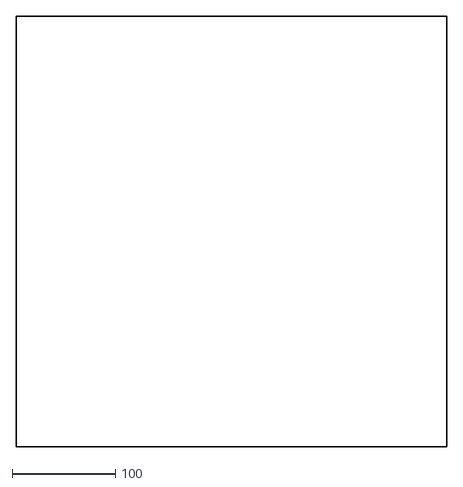
[picture p116: CAD file, 2017-05-17]
plytka MKV30F128Vxx10P/MKV30F128VFL10P/DXF/2016-12-16_17-09-52/Library_View.dxf
416.3 x 416.3
