KubaMiszcz/Praca-Inzynierska---RoboPajak/plytka MKV30F128Vxx10P/MKV30F128VFL10P/STL/2016-12-16_17-09-52/LQFP-48_7X7X1_6-M.stp

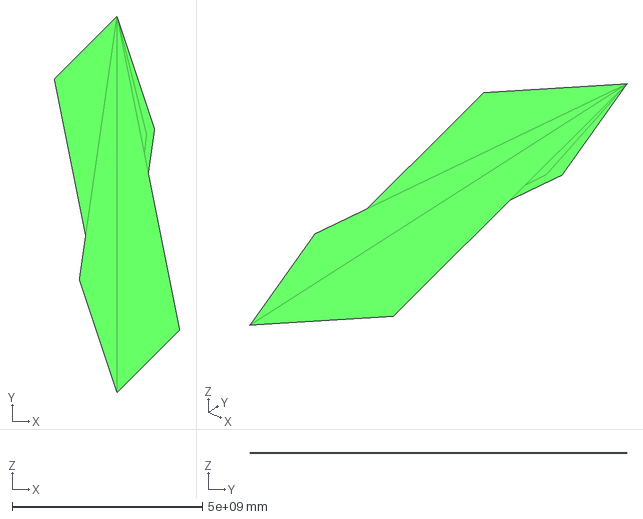
[picture p117: CAD file, 2017-05-17]
plytka MKV30F128Vxx10P/MKV30F128VFL10P/STL/2016-12-16_17-09-52/LQFP-48_7X7X1_6-M.stp
3304831756.0 x 9914495266.0 x 4.00 mm
