KubaMiszcz/Praca-Inzynierska---RoboPajak/zzz inne/Solidworks model3D v1/S0 - baza/S0-S1(baza-obejma).SLDPRT

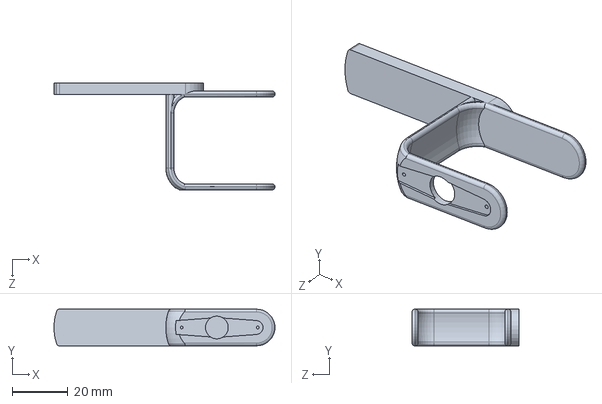
[picture p118: CAD file, 2017-05-17]
zzz inne/Solidworks model3D v1/S0 - baza/S0-S1(baza-obejma).SLDPRT
79.0 x 13.1 x 38.2 mm
