KubaMiszcz/Praca-Inzynierska---RoboPajak/zzz inne/Solidworks model3D v1/S1 - uchwyt do bazy/S1 segment 2 obudowy na serwo v2.SLDPRT

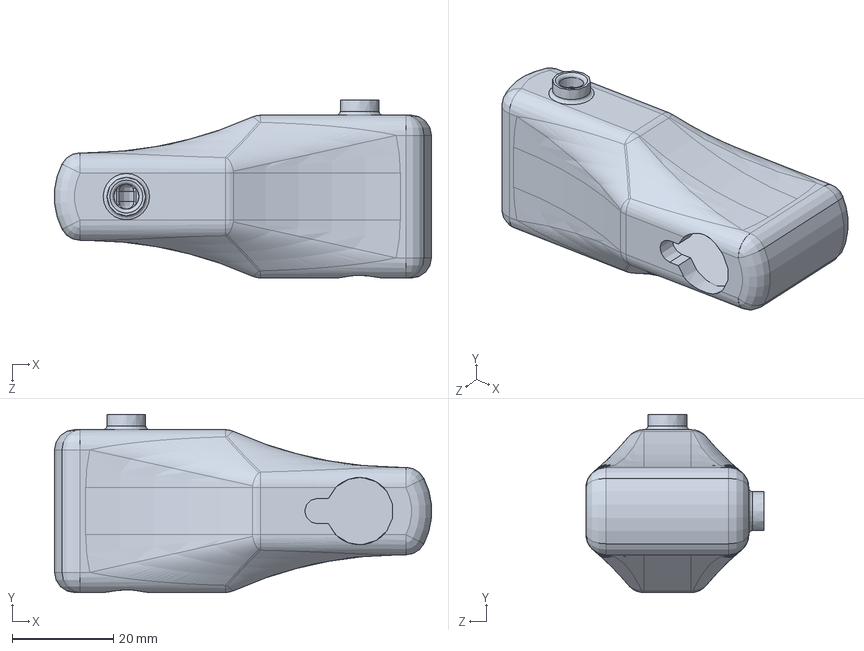
[picture p119: CAD file, 2017-05-17]
zzz inne/Solidworks model3D v1/S1 - uchwyt do bazy/S1 segment 2 obudowy na serwo v2.SLDPRT
74.5 x 35.2 x 35.2 mm
