KubaMiszcz/Praca-Inzynierska---RoboPajak/zzz inne/Solidworks model3D v1/S3 - segment/arch/S3 rurka .SLDPRT

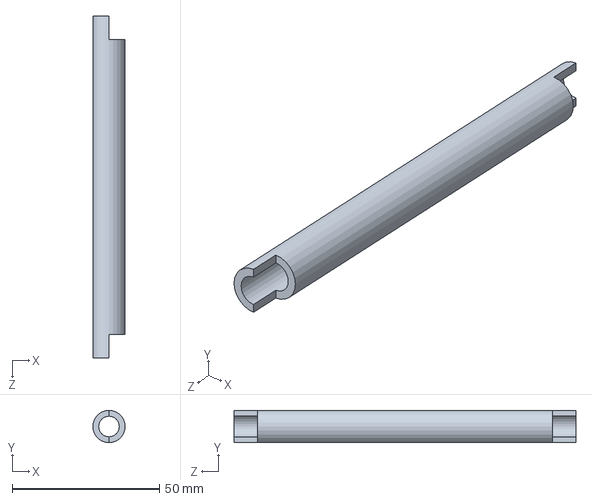
[picture p120: CAD file, 2017-05-17]
zzz inne/Solidworks model3D v1/S3 - segment/arch/S3 rurka .SLDPRT
11.0 x 11.0 x 116.0 mm
