KubaMiszcz/Praca-Inzynierska---RoboPajak/zzz inne/Solidworks model3D v1/S3 - segment/S3 A obud serwo gora.STL

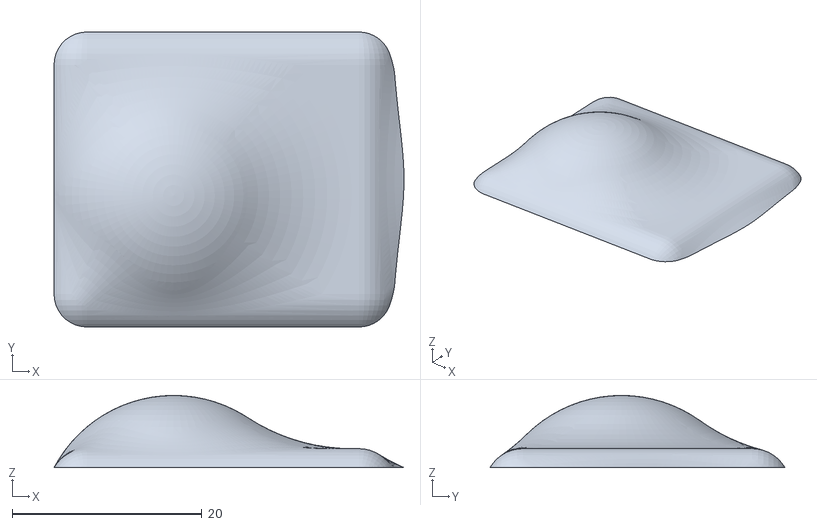
[picture p121: CAD file, 2017-05-17]
zzz inne/Solidworks model3D v1/S3 - segment/S3 A obud serwo gora.STL
36.9 x 31.1 x 7.61
