KubaMiszcz/Praca-Inzynierska---RoboPajak/zzz inne/Solidworks model3D v1/skasuj/kolkoB.STL

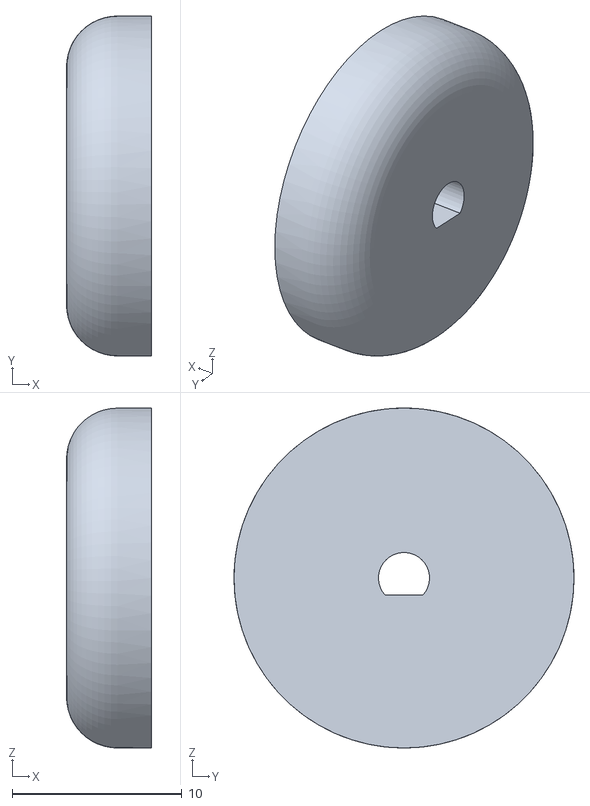
[picture p122: CAD file, 2017-05-17]
zzz inne/Solidworks model3D v1/skasuj/kolkoB.STL
5.00 x 20.0 x 20.0
