KubaMiszcz/Praca-Inzynierska---RoboPajak/zzz inne/Solidworks model3D v1/STL export/S3 - segment - S3 servo w obudowie-1 S3 obudowa na serwo v2-1 B.STL

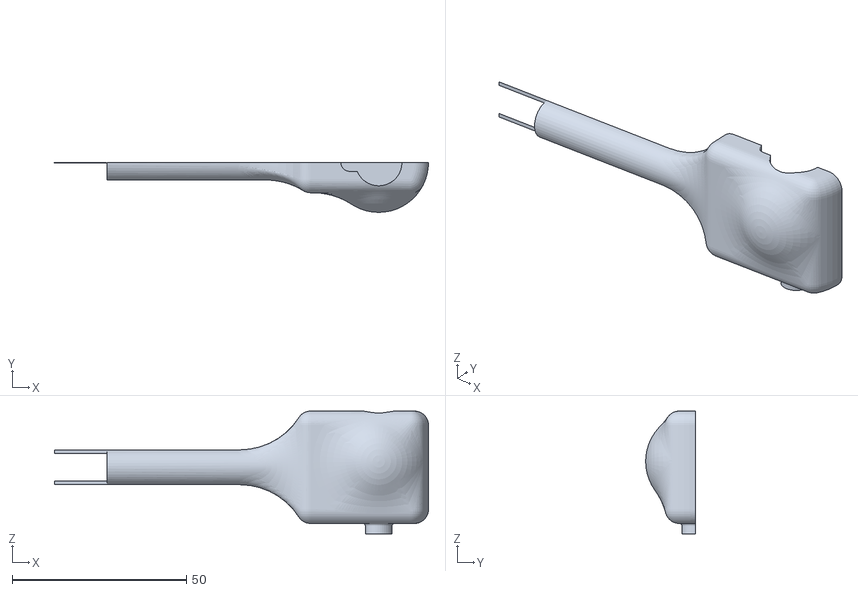
[picture p123: CAD file, 2017-05-17]
zzz inne/Solidworks model3D v1/STL export/S3 - segment - S3 servo w obudowie-1 S3 obudowa na serwo v2-1 B.STL
107.2 x 14.3 x 35.2
