KubaMiszcz/Praca-Inzynierska---RoboPajak/=SW 3D v2 kulkowe preguby/parts ogolne/STL v3 uni obudowa serwa BBB.STL

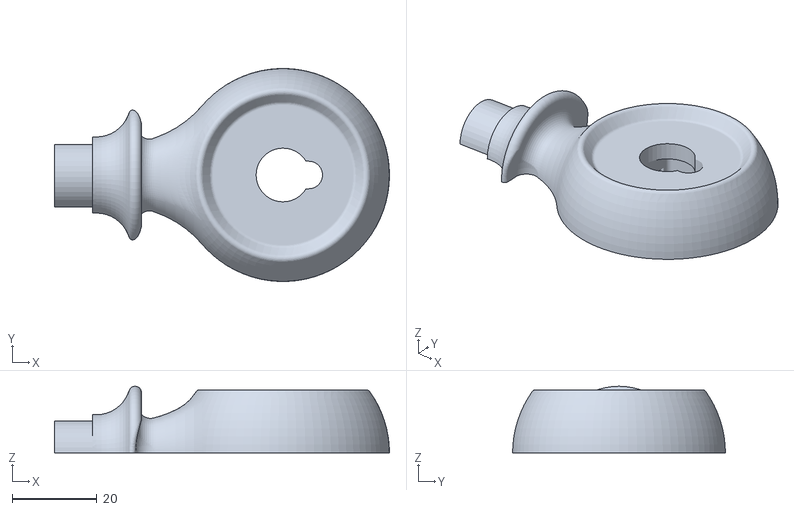
[picture p124: CAD file, 2017-05-17]
=SW 3D v2 kulkowe preguby/parts ogolne/STL v3 uni obudowa serwa BBB.STL
79.2 x 50.3 x 15.7
