KubaMiszcz/Praca-Inzynierska---RoboPajak/=SW 3D v2 kulkowe preguby/S0 baza/==/S0 obejma serwa do bazy.SLDPRT

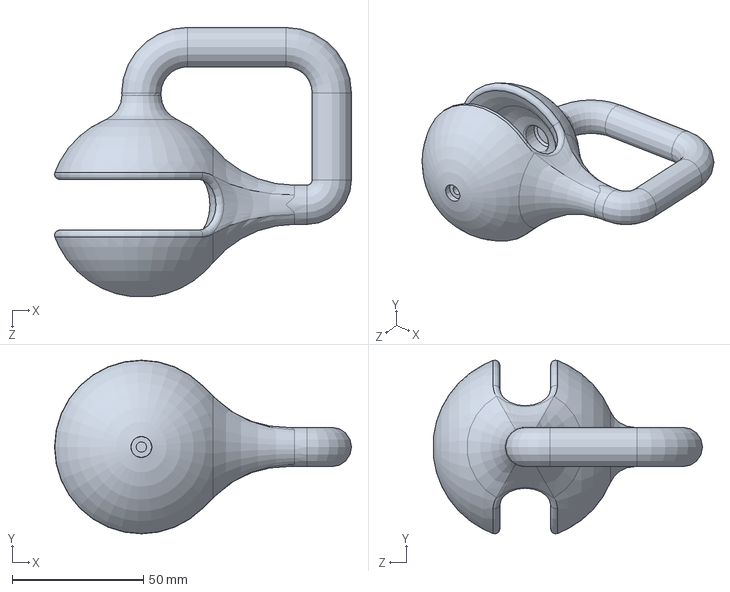
[picture p125: CAD file, 2017-05-17]
=SW 3D v2 kulkowe preguby/S0 baza/==/S0 obejma serwa do bazy.SLDPRT
113.1 x 66.1 x 102.4 mm
