KubaMiszcz/Praca-Inzynierska---RoboPajak/=SW 3D v2 kulkowe preguby/S2 segment/P S2 rurka v2 wygieta.SLDPRT

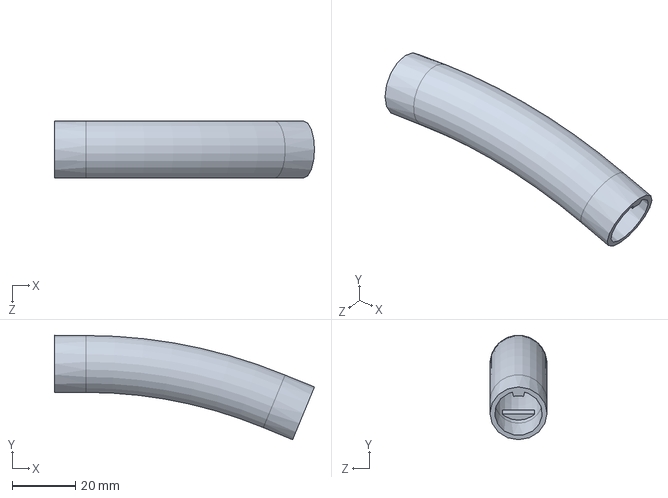
[picture p126: CAD file, 2017-05-17]
=SW 3D v2 kulkowe preguby/S2 segment/P S2 rurka v2 wygieta.SLDPRT
81.9 x 32.9 x 18.0 mm
