KubaMiszcz/Praca-Inzynierska---RoboPajak/=SW 3D v2 kulkowe preguby/S4 segment/P S4 golen.SLDPRT

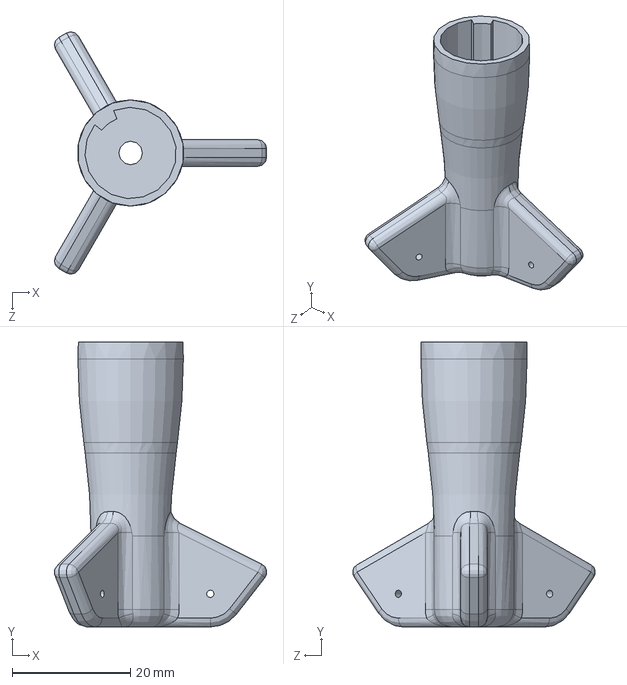
[picture p127: CAD file, 2017-05-17]
=SW 3D v2 kulkowe preguby/S4 segment/P S4 golen.SLDPRT
36.0 x 48.3 x 41.1 mm
