KubaMiszcz/Praca-Inzynierska---RoboPajak/=SW 3D v2 kulkowe preguby/z parts fabryczne i dodatki/P servo SG90.SLDPRT

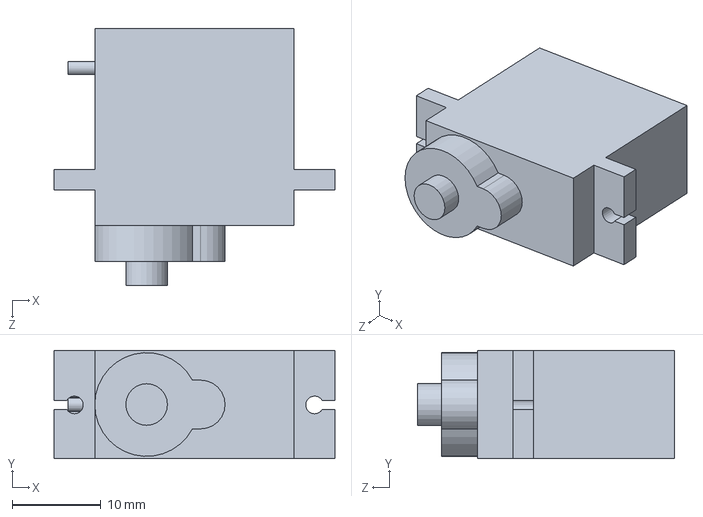
[picture p128: CAD file, 2017-05-17]
=SW 3D v2 kulkowe preguby/z parts fabryczne i dodatki/P servo SG90.SLDPRT
31.7 x 12.2 x 29.0 mm
