KubaMiszcz/Praca-Inzynierska---RoboPajak/=SW 3D v3 new design/parts ogolne/P v9 uni obudowa serwa szeroka rurak.SLDPRT

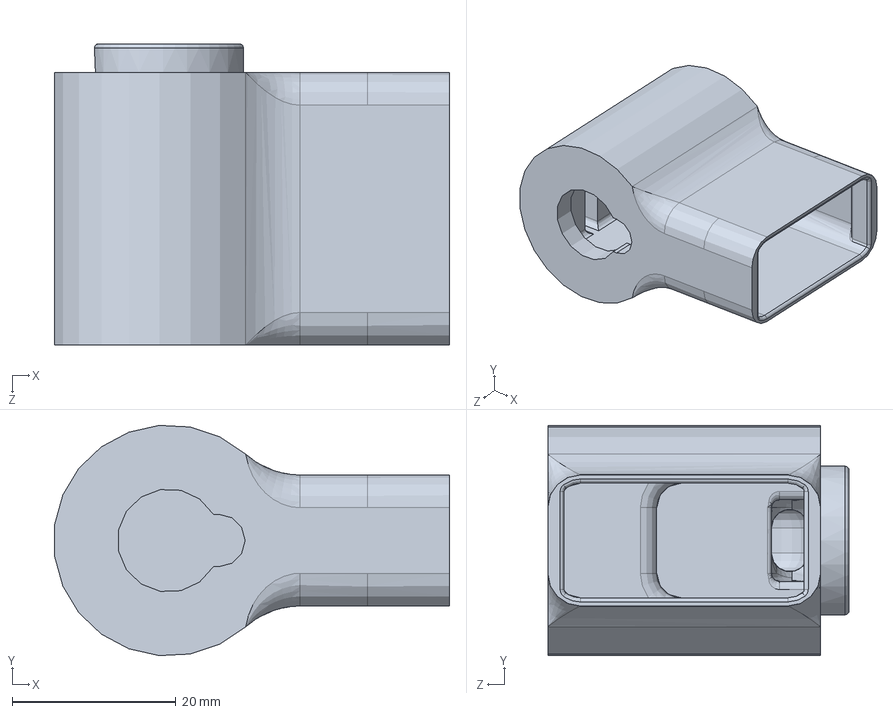
[picture p129: CAD file, 2017-05-17]
=SW 3D v3 new design/parts ogolne/P v9 uni obudowa serwa szeroka rurak.SLDPRT
48.2 x 28.1 x 36.8 mm
