KubaMiszcz/Praca-Inzynierska---RoboPajak/=SW 3D v3 new design/parts ogolne/zz/P v3 prowadnik w obejmie.SLDPRT

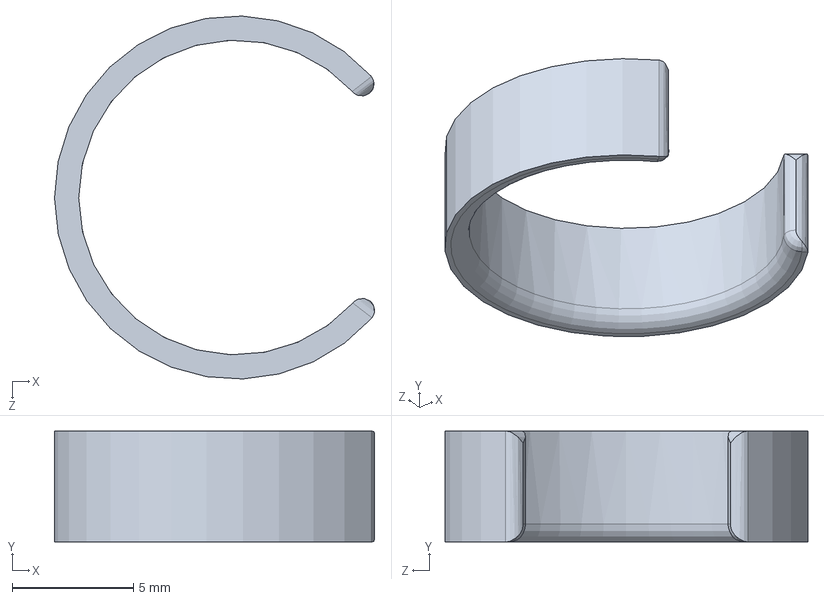
[picture p130: CAD file, 2017-05-17]
=SW 3D v3 new design/parts ogolne/zz/P v3 prowadnik w obejmie.SLDPRT
13.2 x 4.58 x 15.0 mm
