KubaMiszcz/Praca-Inzynierska---RoboPajak/=SW 3D v3 new design/S1 segment/zz/P uni obudowas serwa 90st z wpustem.SLDPRT

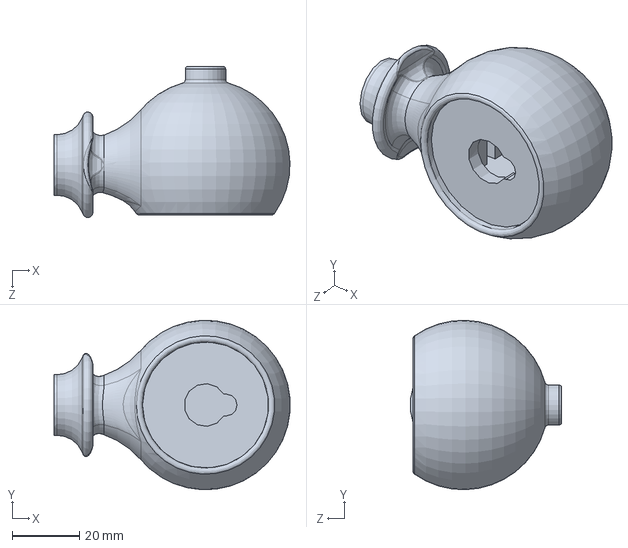
[picture p131: CAD file, 2017-05-17]
=SW 3D v3 new design/S1 segment/zz/P uni obudowas serwa 90st z wpustem.SLDPRT
70.1 x 50.3 x 44.9 mm
