KubaMiszcz/Praca-Inzynierska---RoboPajak/=SW 3D v3 new design/S2 segment/STL S2 rurka v2 wygieta polowka.STL

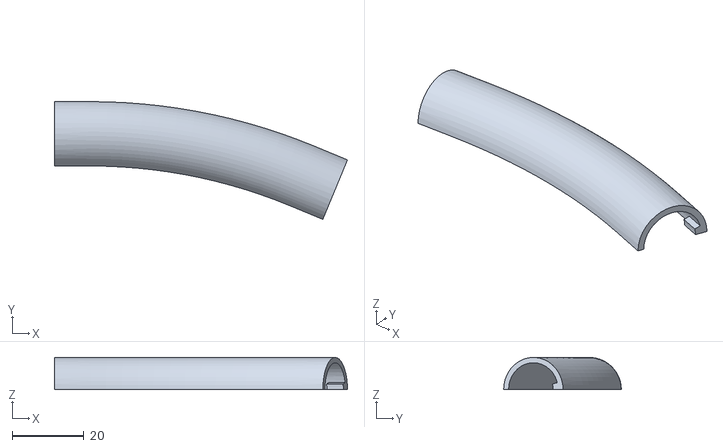
[picture p132: CAD file, 2017-05-17]
=SW 3D v3 new design/S2 segment/STL S2 rurka v2 wygieta polowka.STL
81.9 x 32.9 x 9.00
