KubaMiszcz/Praca-Inzynierska---RoboPajak/=SW 3D v3 new design/S3 segment/P S3 rurka v9 wygieta sciecia gora.STL

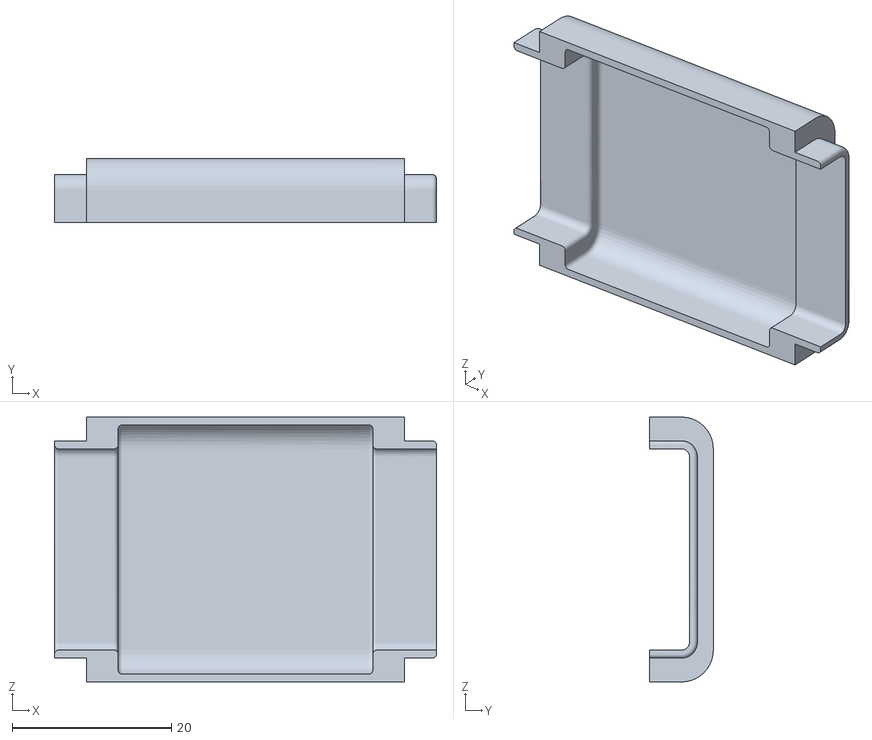
[picture p133: CAD file, 2017-05-17]
=SW 3D v3 new design/S3 segment/P S3 rurka v9 wygieta sciecia gora.STL
48.0 x 8.00 x 33.3
