KubaMiszcz/Praca-Inzynierska---RoboPajak/=SW 3D v3 new design/S3 segment/zz/P S3 rurka v6 duzy prostok.SLDPRT

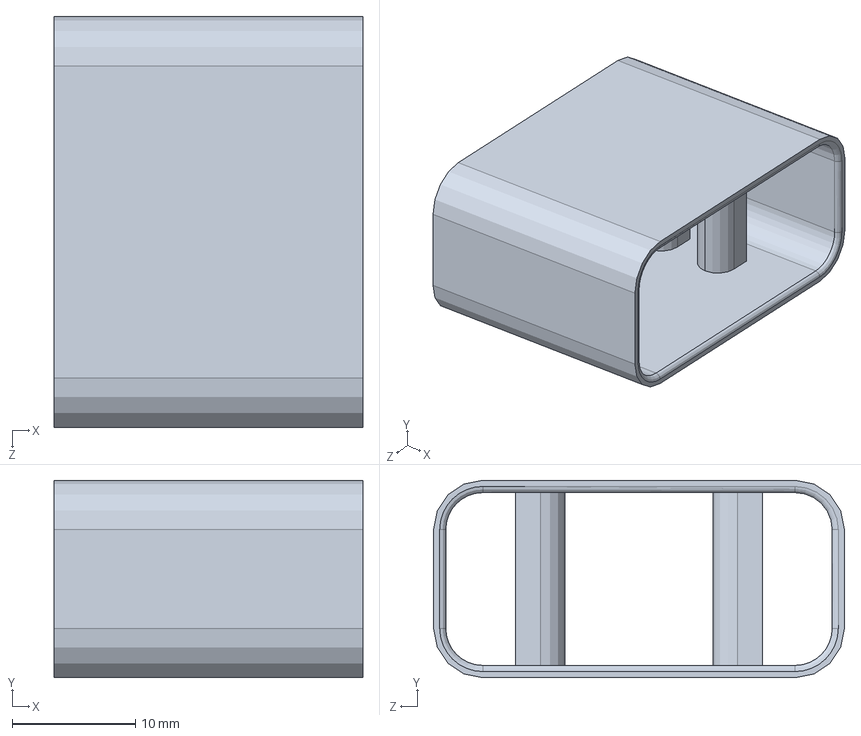
[picture p134: CAD file, 2017-05-17]
=SW 3D v3 new design/S3 segment/zz/P S3 rurka v6 duzy prostok.SLDPRT
25.0 x 16.0 x 33.3 mm
