KubaMiszcz/Praca-Inzynierska---RoboPajak/=SW 3D v3 new design/S4 segment/STL S4 palec v2 sciecie 120st polowka w pionie.STL

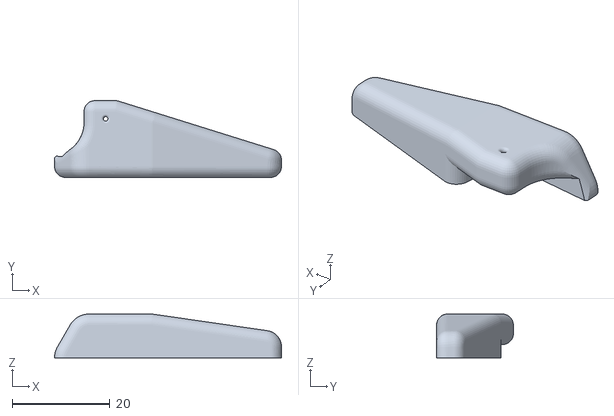
[picture p135: CAD file, 2017-05-17]
=SW 3D v3 new design/S4 segment/STL S4 palec v2 sciecie 120st polowka w pionie.STL
46.6 x 15.8 x 9.00
