KubaMiszcz/Praca-Inzynierska---RoboPajak/=SW 3D v3 new design/zzz testy/tuleja gwint.SLDPRT

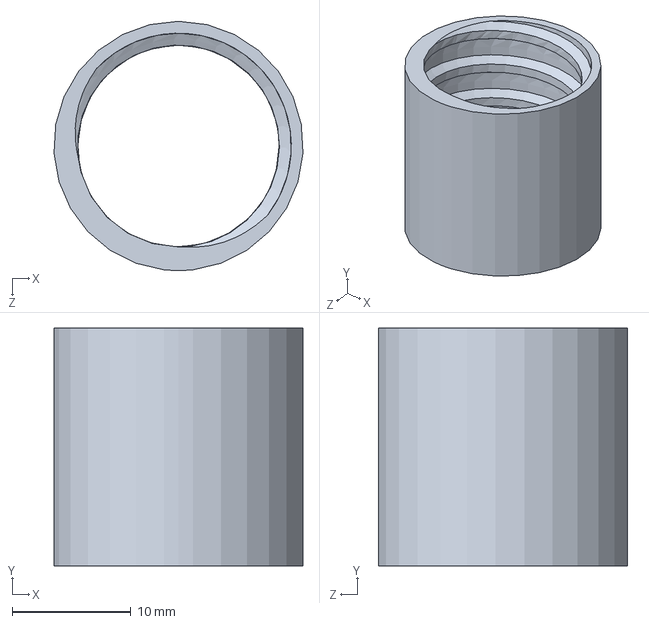
[picture p136: CAD file, 2017-05-17]
=SW 3D v3 new design/zzz testy/tuleja gwint.SLDPRT
21.0 x 20.0 x 21.0 mm
