KubaMiszcz/Praca-Inzynierska---RoboPajak/zzz inne/Solidworks model3D v1/importexport/MicroServo9g.igs

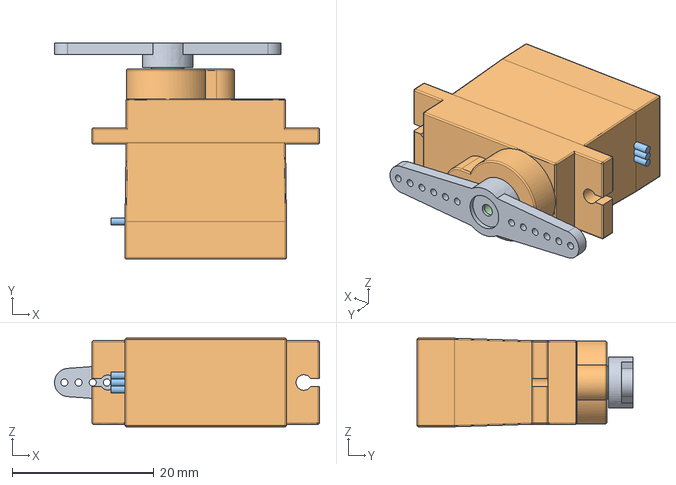
[picture p137: CAD file, 2017-05-17]
zzz inne/Solidworks model3D v1/importexport/MicroServo9g.igs
37.4 x 30.5 x 12.5 mm
