KubaMiszcz/Praca-Inzynierska---RoboPajak/zzz inne/Solidworks model3D v1/parts ogolne/obejma serwa.SLDPRT

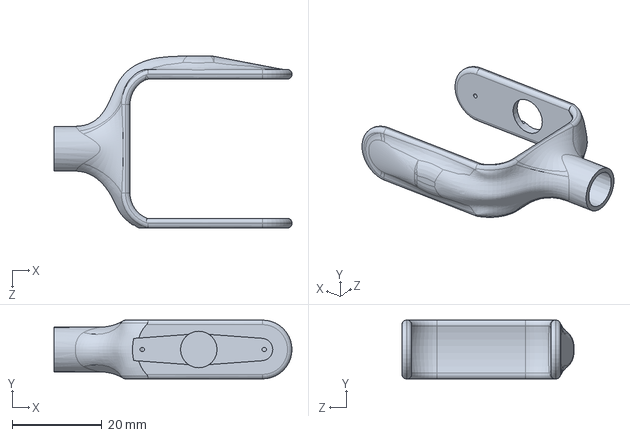
[picture p138: CAD file, 2017-05-17]
zzz inne/Solidworks model3D v1/parts ogolne/obejma serwa.SLDPRT
53.1 x 13.1 x 38.4 mm
