KubaMiszcz/Praca-Inzynierska---RoboPajak/zzz inne/Solidworks model3D v1/S4 - segment/S4 golen.SLDPRT

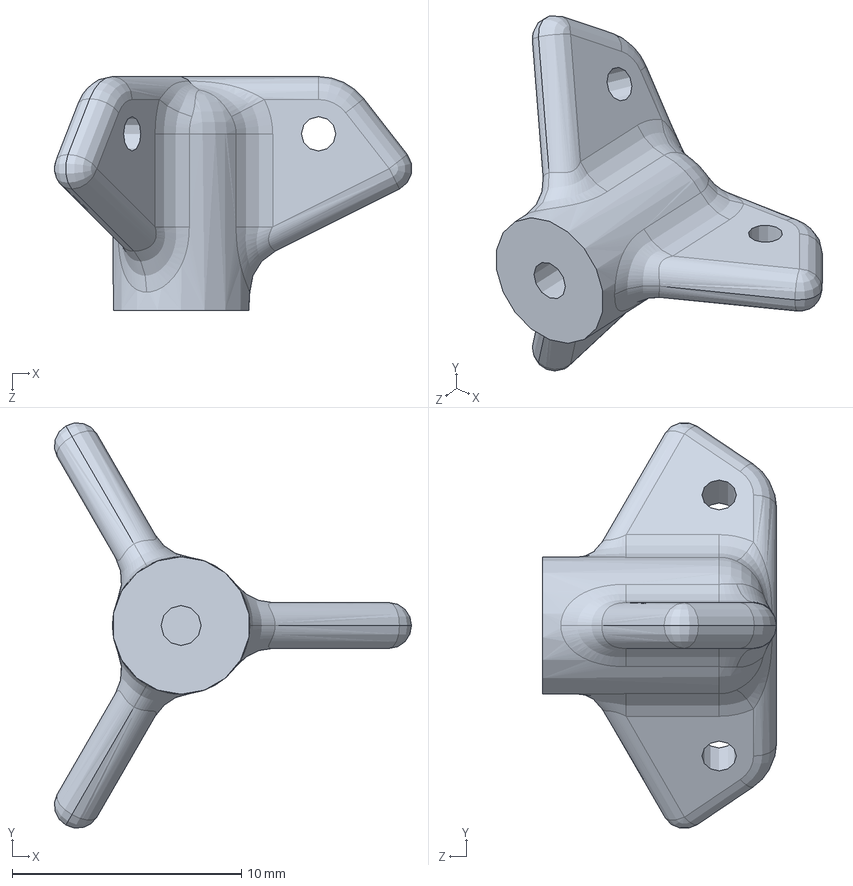
[picture p139: CAD file, 2017-05-17]
zzz inne/Solidworks model3D v1/S4 - segment/S4 golen.SLDPRT
15.6 x 17.7 x 10.2 mm
