KubaMiszcz/Praca-Inzynierska---RoboPajak/zzz inne/Solidworks model3D v1/STL export/S3 - segment - S3 obejma serwa v2 grubsza na kabel-1 B.STL

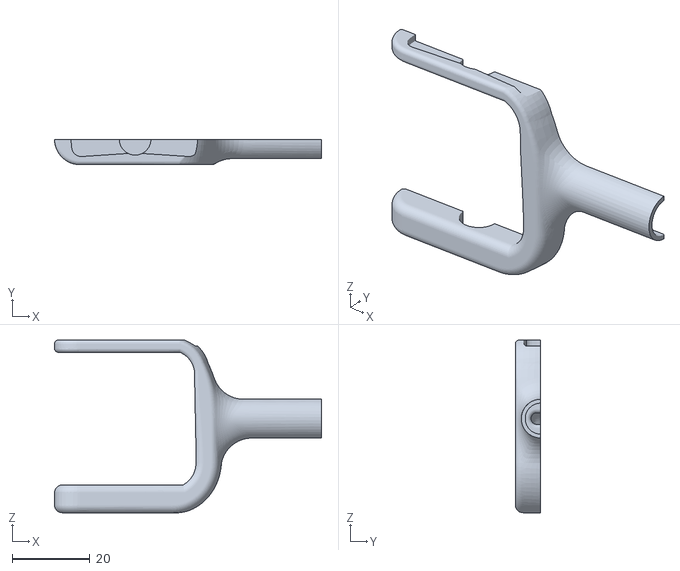
[picture p140: CAD file, 2017-05-17]
zzz inne/Solidworks model3D v1/STL export/S3 - segment - S3 obejma serwa v2 grubsza na kabel-1 B.STL
68.8 x 6.56 x 44.6
