KubaMiszcz/Praca-Inzynierska---RoboPajak/=SW 3D v2 kulkowe preguby/parts ogolne/zz/P v3 uni obejma serwa ciensza.SLDPRT

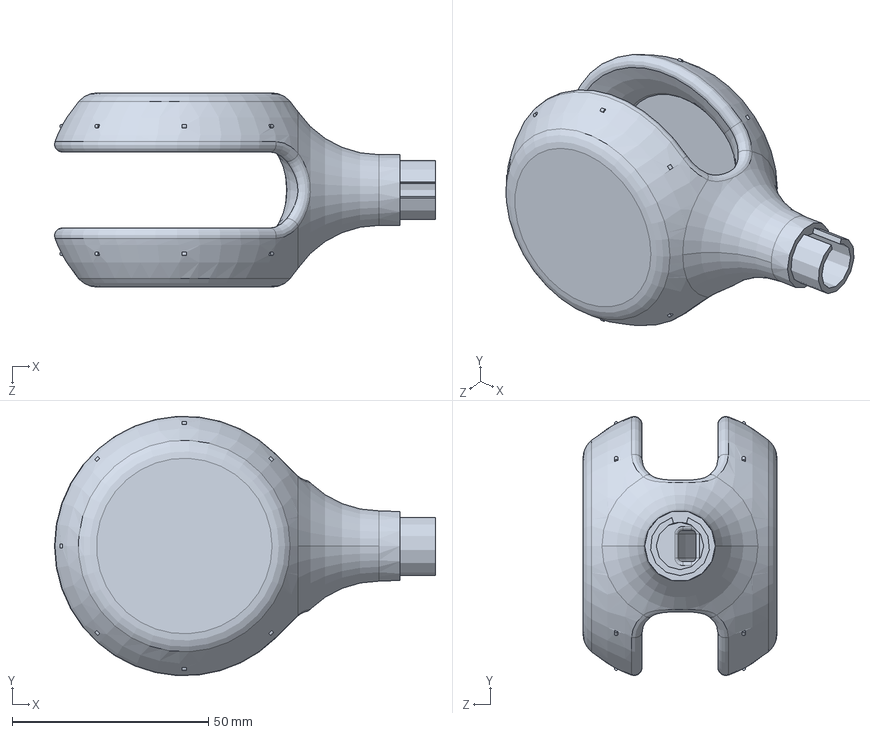
[picture p141: CAD file, 2017-05-17]
=SW 3D v2 kulkowe preguby/parts ogolne/zz/P v3 uni obejma serwa ciensza.SLDPRT
97.1 x 66.0 x 49.5 mm
