KubaMiszcz/Praca-Inzynierska---RoboPajak/=SW 3D v2 kulkowe preguby/S4 segment/STL S4 palec v2 sciecie 120st gora.STL

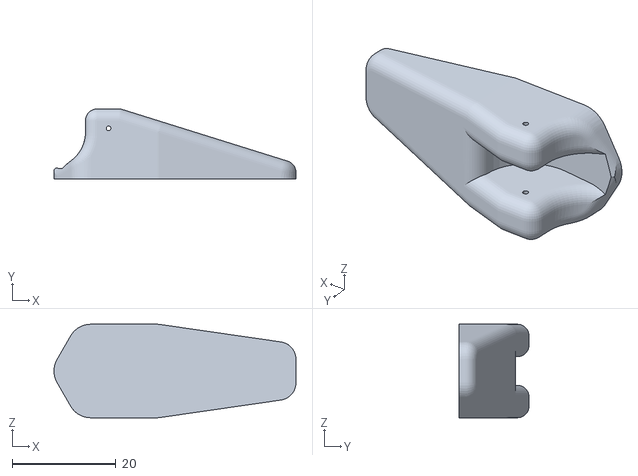
[picture p142: CAD file, 2017-05-17]
=SW 3D v2 kulkowe preguby/S4 segment/STL S4 palec v2 sciecie 120st gora.STL
46.6 x 13.5 x 18.0
