KubaMiszcz/Praca-Inzynierska---RoboPajak/=SW 3D v2 kulkowe preguby/z parts fabryczne i dodatki/P NanoPi.SLDPRT

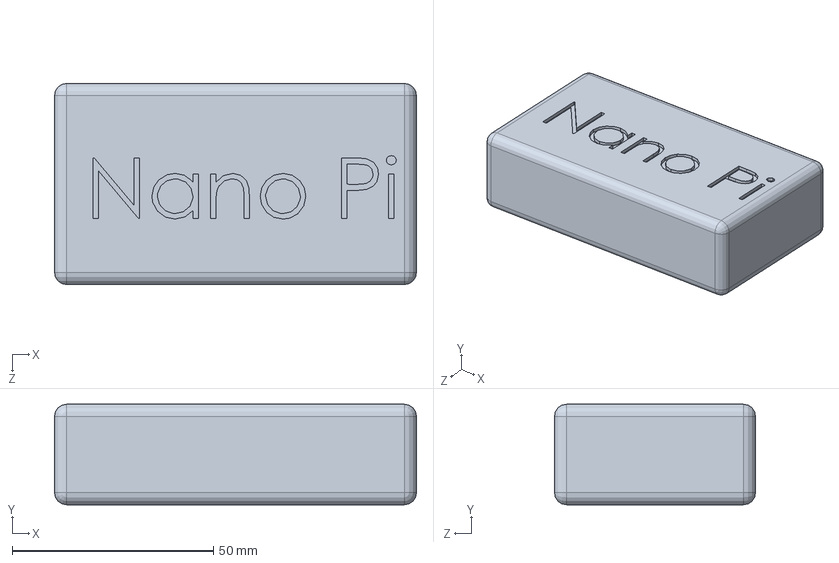
[picture p143: CAD file, 2017-05-17]
=SW 3D v2 kulkowe preguby/z parts fabryczne i dodatki/P NanoPi.SLDPRT
90.0 x 25.0 x 50.0 mm
