KubaMiszcz/Praca-Inzynierska---RoboPajak/=SW 3D v3 new design/parts ogolne/P v8a uni obudowa serwa szeroka rurak 90st.SLDPRT

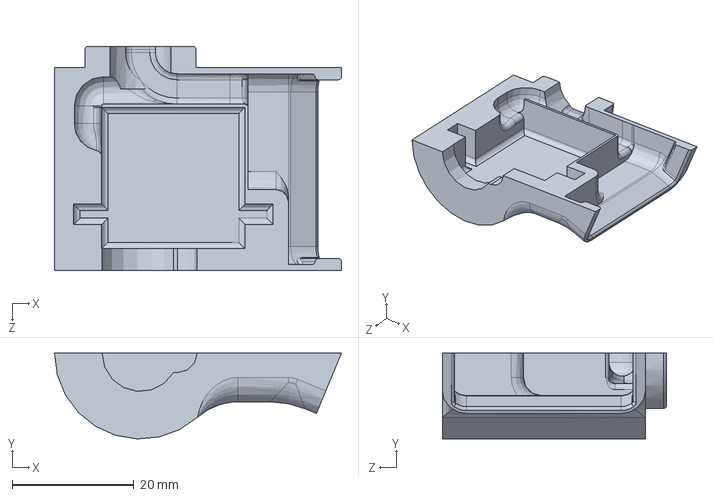
[picture p144: CAD file, 2017-05-17]
=SW 3D v3 new design/parts ogolne/P v8a uni obudowa serwa szeroka rurak 90st.SLDPRT
47.1 x 14.1 x 36.8 mm
