KubaMiszcz/Praca-Inzynierska---RoboPajak/=SW 3D v3 new design/S0 baza/==/P S0 korpus obudowa dolna.SLDPRT

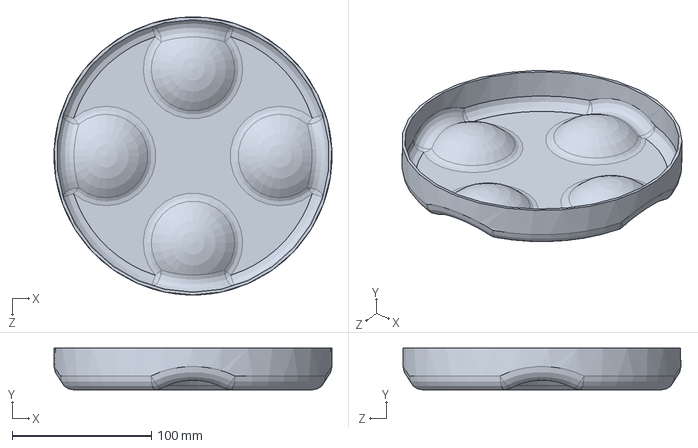
[picture p145: CAD file, 2017-05-17]
=SW 3D v3 new design/S0 baza/==/P S0 korpus obudowa dolna.SLDPRT
200.0 x 30.0 x 200.0 mm
