KubaMiszcz/Praca-Inzynierska---RoboPajak/=SW 3D v3 new design/S0 baza/P S0 v2 8kat podstawa 4 obudowy serw.SLDPRT

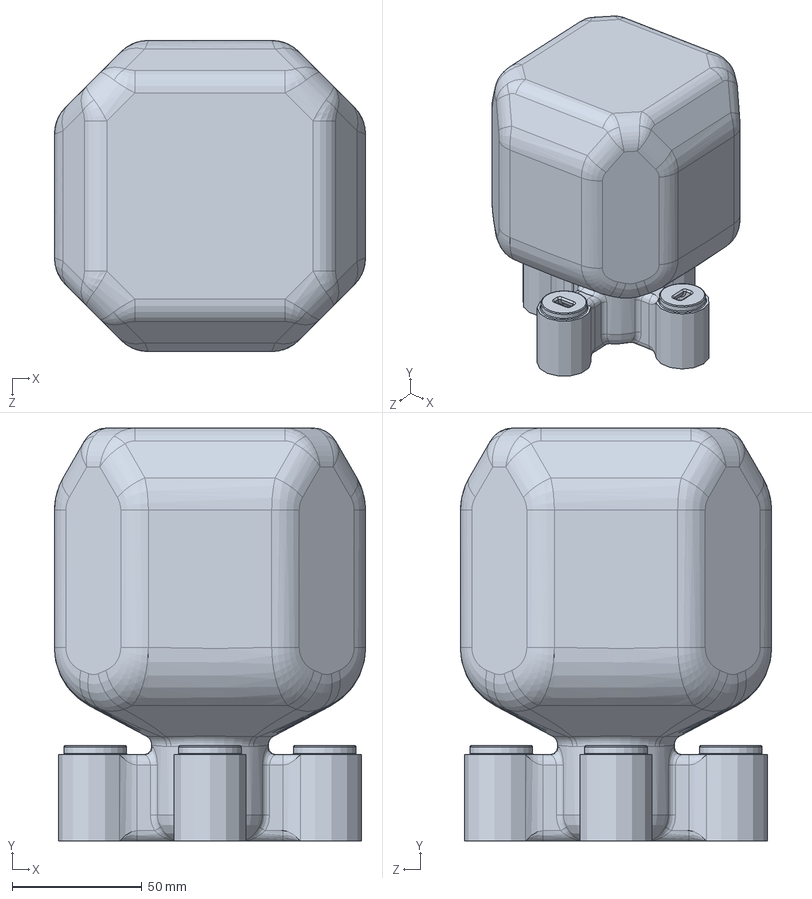
[picture p146: CAD file, 2017-05-17]
=SW 3D v3 new design/S0 baza/P S0 v2 8kat podstawa 4 obudowy serw.SLDPRT
120.0 x 159.3 x 120.0 mm
