KubaMiszcz/Praca-Inzynierska---RoboPajak/=SW 3D v3 new design/S2 segment/P S2 rurka v8 sciecia.SLDPRT

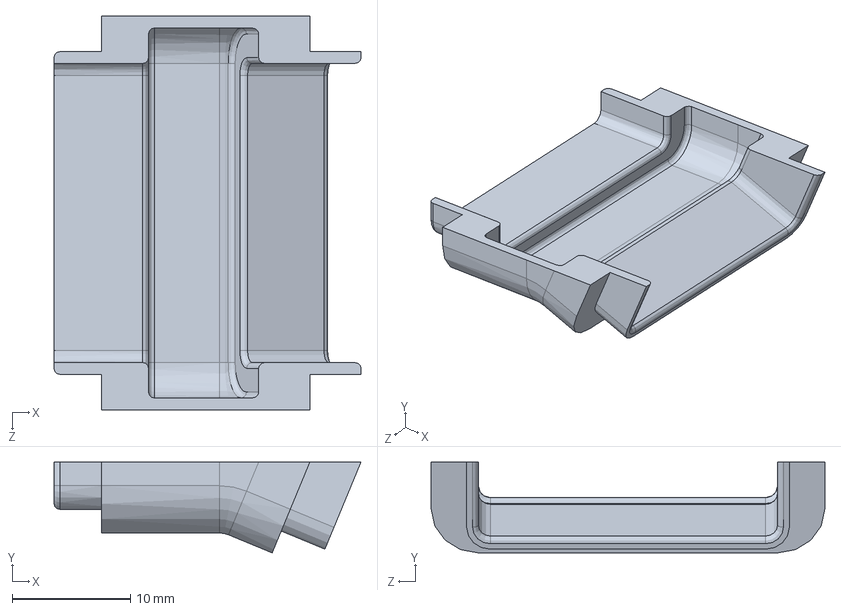
[picture p147: CAD file, 2017-05-17]
=SW 3D v3 new design/S2 segment/P S2 rurka v8 sciecia.SLDPRT
26.0 x 7.68 x 33.3 mm
