KubaMiszcz/Praca-Inzynierska---RoboPajak/=SW 3D v3 new design/S4 segment/==/P S4 v1 obejma przy goleniu.SLDPRT

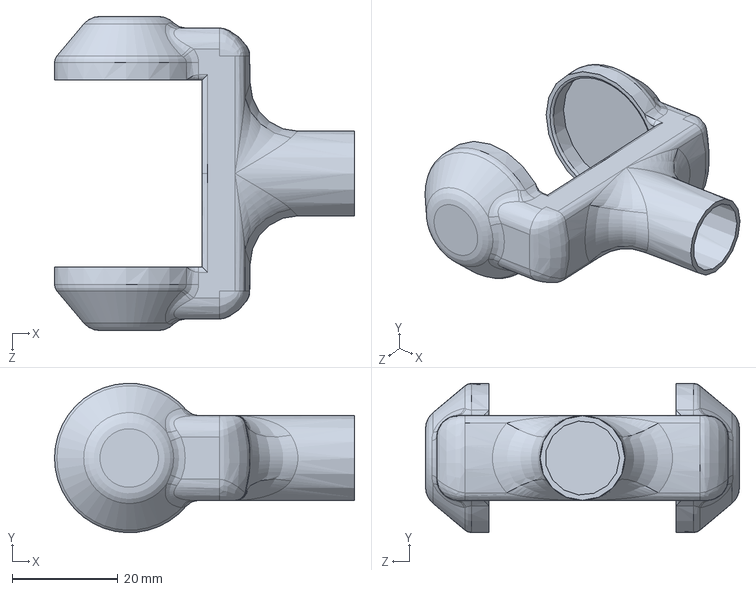
[picture p148: CAD file, 2017-05-17]
=SW 3D v3 new design/S4 segment/==/P S4 v1 obejma przy goleniu.SLDPRT
56.6 x 28.2 x 59.3 mm
