KubaMiszcz/Praca-Inzynierska---RoboPajak/=SW 3D v3 new design/S4 segment/STL S4 palec v2 sciecie 120st dosssssssssssssl.STL

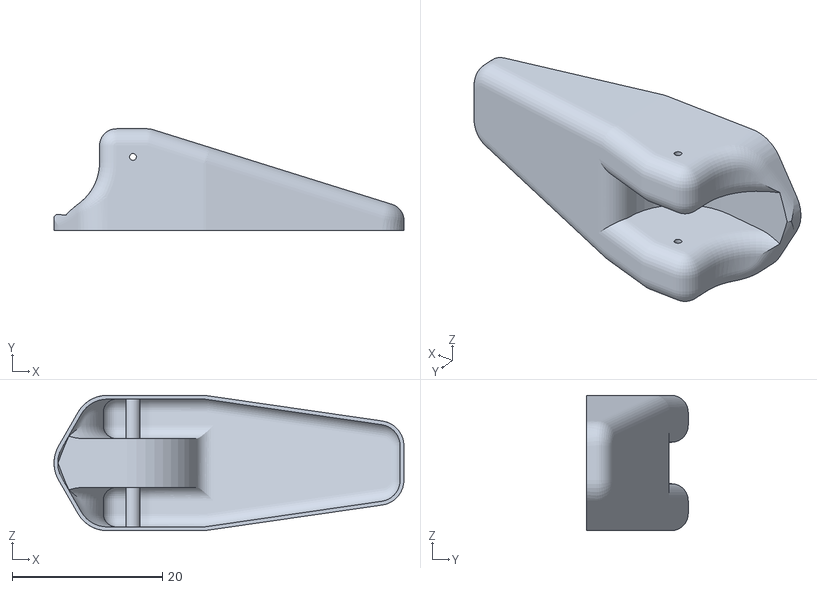
[picture p149: CAD file, 2017-05-17]
=SW 3D v3 new design/S4 segment/STL S4 palec v2 sciecie 120st dosssssssssssssl.STL
46.6 x 13.5 x 18.0
