KubaMiszcz/Praca-Inzynierska---RoboPajak/=SW 3D v3 new design/z parts fabryczne i dodatki/P STM32F103C8T6.SLDPRT

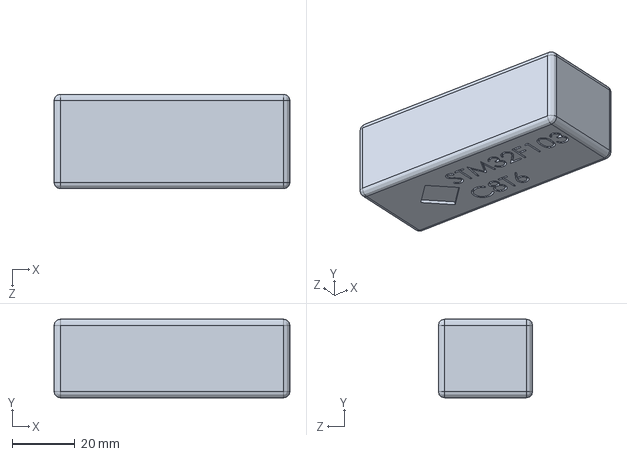
[picture p150: CAD file, 2017-05-17]
=SW 3D v3 new design/z parts fabryczne i dodatki/P STM32F103C8T6.SLDPRT
75.0 x 25.0 x 30.0 mm
