KubaMiszcz/Praca-Inzynierska---RoboPajak/zzz inne/Solidworks model3D v1/importexport/SG90.stl

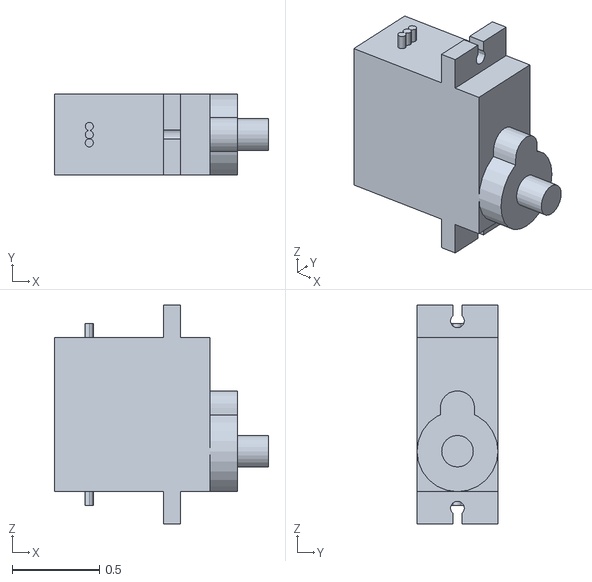
[picture p151: CAD file, 2017-05-17]
zzz inne/Solidworks model3D v1/importexport/SG90.stl
1.23 x 0.465 x 1.26
