KubaMiszcz/Praca-Inzynierska---RoboPajak/zzz inne/Solidworks model3D v1/parts ogolne/ServoArm.SLDPRT

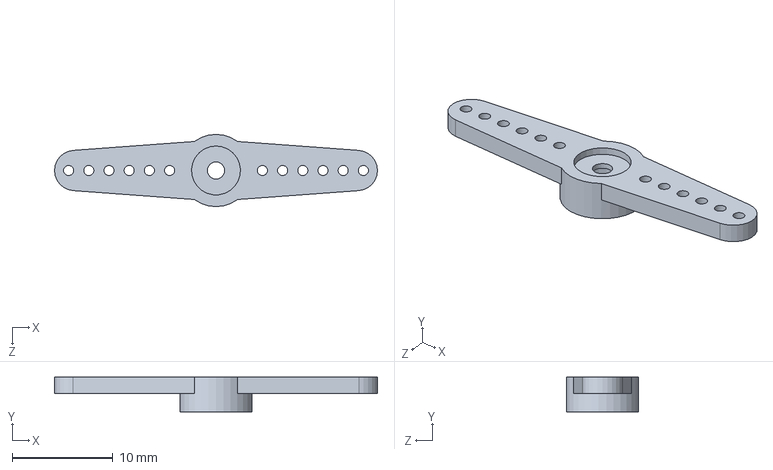
[picture p152: CAD file, 2017-05-17]
zzz inne/Solidworks model3D v1/parts ogolne/ServoArm.SLDPRT
32.0 x 3.43 x 7.16 mm
