KubaMiszcz/Praca-Inzynierska---RoboPajak/zzz inne/Solidworks model3D v1/S0 - baza/S0 obejma serwa v2 grubsza na kabel.SLDPRT

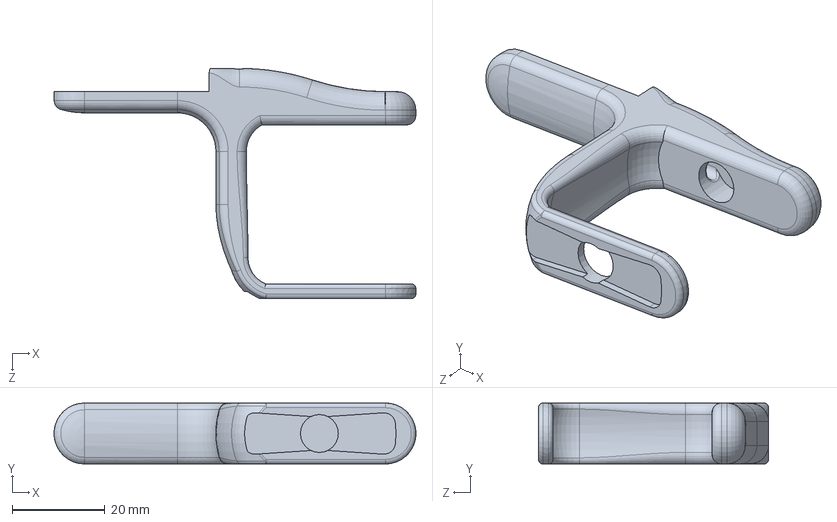
[picture p153: CAD file, 2017-05-17]
zzz inne/Solidworks model3D v1/S0 - baza/S0 obejma serwa v2 grubsza na kabel.SLDPRT
77.9 x 13.1 x 49.5 mm
