KubaMiszcz/Praca-Inzynierska---RoboPajak/zzz inne/Solidworks model3D v1/S1 - uchwyt do bazy/S1 segment 2 obudowy na serwo.SLDPRT

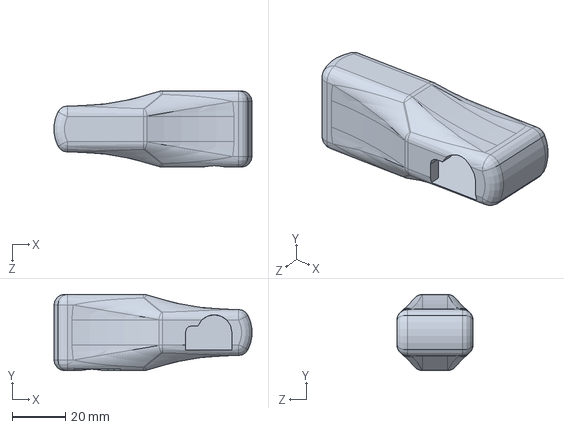
[picture p154: CAD file, 2017-05-17]
zzz inne/Solidworks model3D v1/S1 - uchwyt do bazy/S1 segment 2 obudowy na serwo.SLDPRT
74.5 x 28.7 x 28.7 mm
