KubaMiszcz/Praca-Inzynierska---RoboPajak/zzz inne/Solidworks model3D v1/S3 - segment/arch/S3 rurka v2 pokrzywiona.SLDPRT

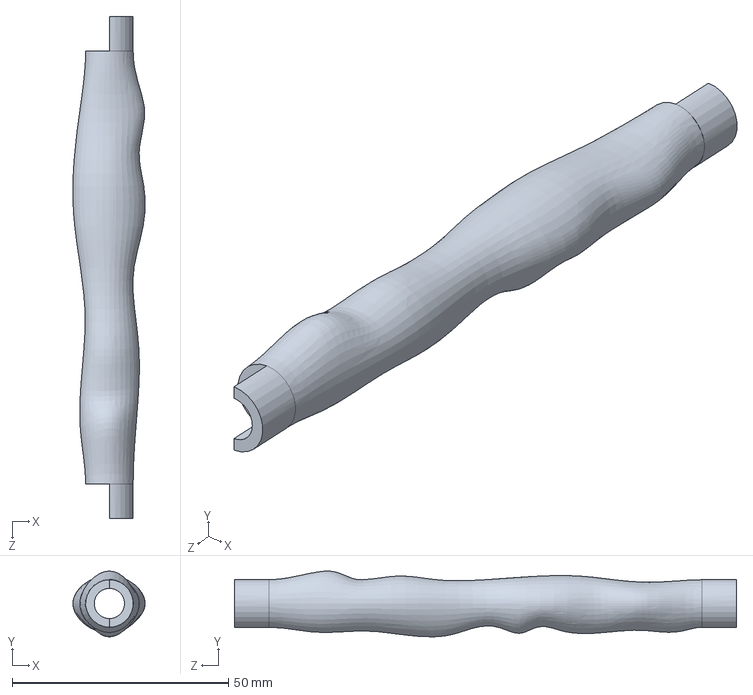
[picture p155: CAD file, 2017-05-17]
zzz inne/Solidworks model3D v1/S3 - segment/arch/S3 rurka v2 pokrzywiona.SLDPRT
16.7 x 15.2 x 116.0 mm
