KubaMiszcz/Praca-Inzynierska---RoboPajak/zzz inne/Solidworks model3D v1/S4 - segment/S4 rurka v2 pokrzywiona ze szpicem.SLDPRT

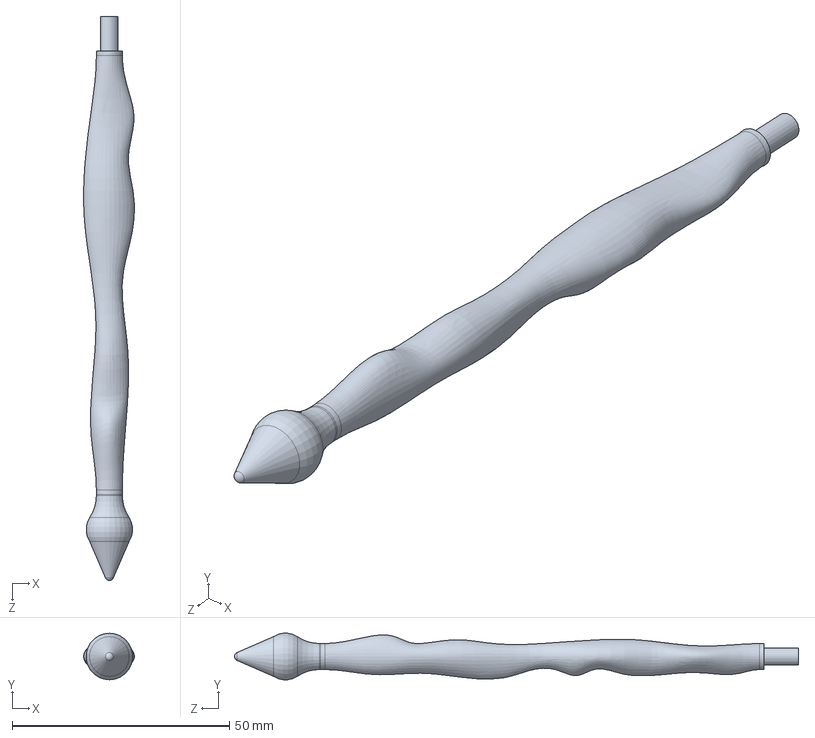
[picture p156: CAD file, 2017-05-17]
zzz inne/Solidworks model3D v1/S4 - segment/S4 rurka v2 pokrzywiona ze szpicem.SLDPRT
11.7 x 10.7 x 129.9 mm
