KubaMiszcz/Praca-Inzynierska---RoboPajak/zzz inne/Solidworks model3D v1/STL export/S4 obejma serwaB.STL

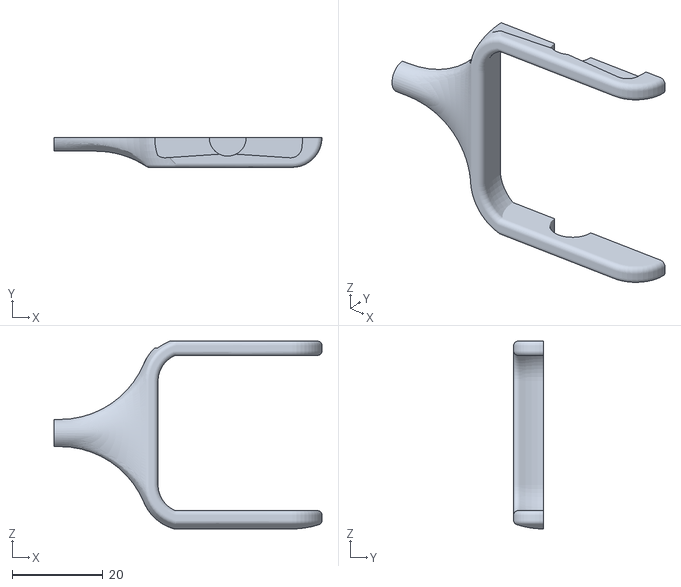
[picture p157: CAD file, 2017-05-17]
zzz inne/Solidworks model3D v1/STL export/S4 obejma serwaB.STL
59.1 x 6.56 x 41.4
