KubaMiszcz/Praca-Inzynierska---RoboPajak/=SW 3D v2 kulkowe preguby/parts ogolne/P v5 uni obudowa serwa.SLDPRT

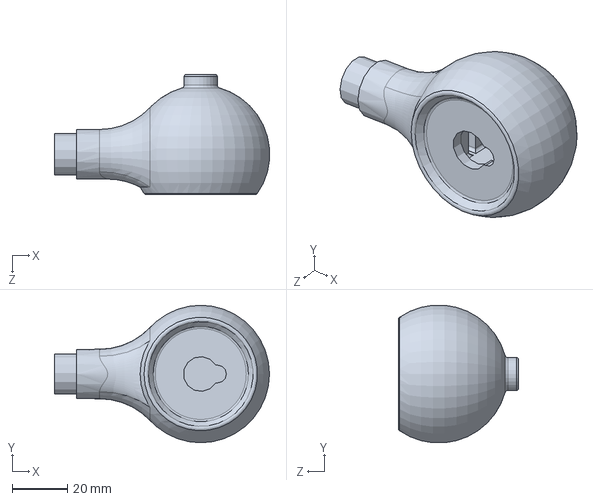
[picture p158: CAD file, 2017-05-17]
=SW 3D v2 kulkowe preguby/parts ogolne/P v5 uni obudowa serwa.SLDPRT
77.9 x 49.8 x 43.7 mm
