KubaMiszcz/Praca-Inzynierska---RoboPajak/=SW 3D v2 kulkowe preguby/parts ogolne/zz/uni obudowas serwa rurka scianki 2mm.SLDPRT

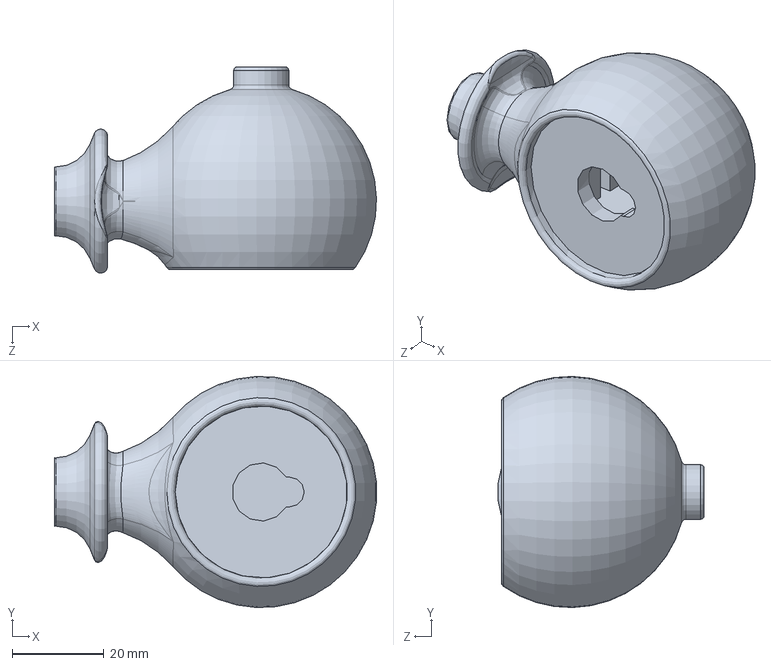
[picture p159: CAD file, 2017-05-17]
=SW 3D v2 kulkowe preguby/parts ogolne/zz/uni obudowas serwa rurka scianki 2mm.SLDPRT
70.1 x 50.3 x 44.9 mm
