KubaMiszcz/Praca-Inzynierska---RoboPajak/=SW 3D v2 kulkowe preguby/S0 baza/==/S0 podstawa.SLDPRT

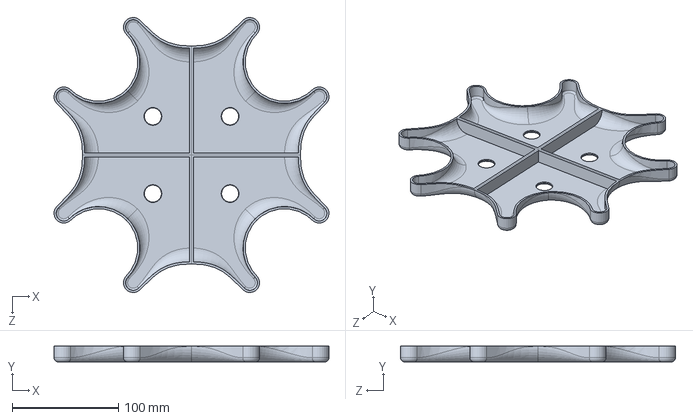
[picture p160: CAD file, 2017-05-17]
=SW 3D v2 kulkowe preguby/S0 baza/==/S0 podstawa.SLDPRT
259.1 x 15.0 x 259.1 mm
