KubaMiszcz/Praca-Inzynierska---RoboPajak/=SW 3D v2 kulkowe preguby/S0 baza/P S0 korpus obudowa gorna v2 osmiokat.SLDPRT

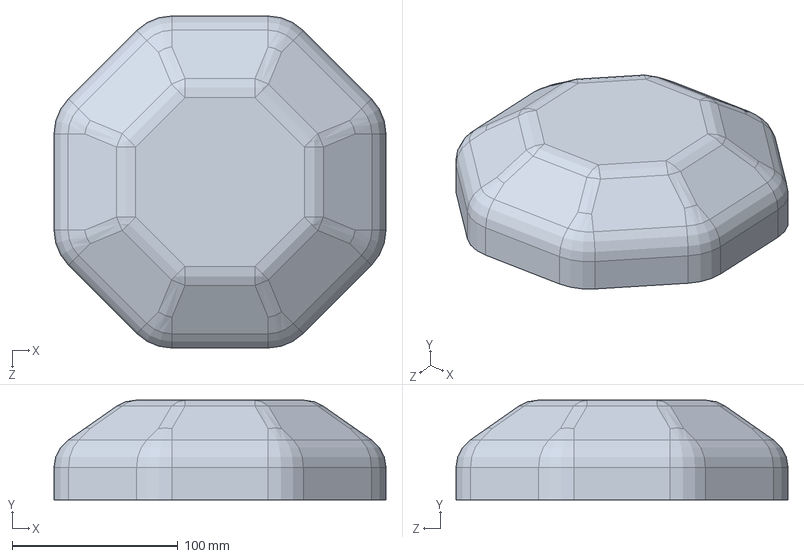
[picture p161: CAD file, 2017-05-17]
=SW 3D v2 kulkowe preguby/S0 baza/P S0 korpus obudowa gorna v2 osmiokat.SLDPRT
200.0 x 60.0 x 200.0 mm
