KubaMiszcz/Praca-Inzynierska---RoboPajak/=SW 3D v2 kulkowe preguby/parts ogolne/A uni obudowas serwa + serwo.SLDASM

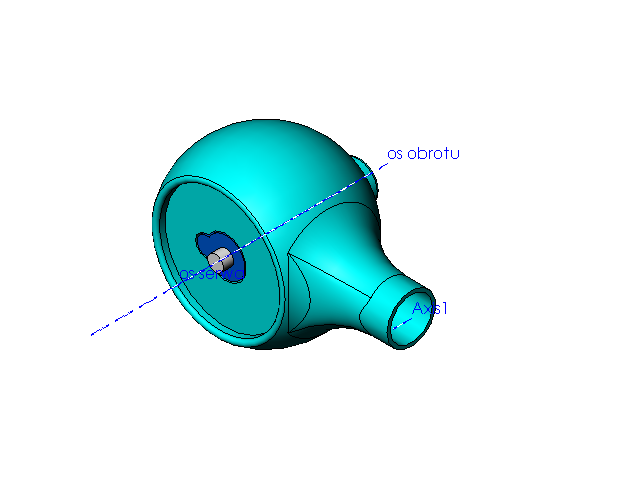
[picture p162: CAD file, 2017-05-17]
=SW 3D v2 kulkowe preguby/parts ogolne/A uni obudowas serwa + serwo.SLDASM
PRT v3 uni obudowa serwa
PRT servo SG90
