KubaMiszcz/Praca-Inzynierska---RoboPajak/(list of files, cad)

Other CAD files:
=SW 3D v3 new design/S0 baza/==/A S0 v2 baza cala.SLDASM
=SW 3D v2 kulkowe preguby/S1 segment/P S1 rurka.SLDPRT
kalibracja serwa SG90/wzornik do kalibracji.dwg
zzz inne/glowa pajaka/wzornik do kalibracji.dwg
zzz inne/Solidworks model3D v1/importexport/MicroServo9g2.sldprt
zzz inne/Solidworks model3D v1/parts ogolne/servo SG90.SLDPRT
zzz inne/Solidworks model3D v1/S4 - segment/S4 rurkav1 prosta.SLDPRT
=SW 3D v2 kulkowe preguby/parts ogolne/zz/P lacznik rurek.SLDPRT
=SW 3D v3 new design/S4 segment/==/P S4 rurka.SLDPRT
=SW 3D v3 new design/z parts fabryczne i dodatki/P servo SG90.SLDPRT
kalibracja serwa SG90/obliczenia servo sg90.dwg
plytka MKV30F128Vxx10P/MKV30F128VFL10P/STL/2016-12-16_17-09-52/LQFP-48_7X7X1_6.stp
zzz inne/Solidworks model3D v1/S1 - uchwyt do bazy/S1 obudowa na serwo v3.SLDPRT
zzz inne/Solidworks model3D v1/S2 - segment/S2 obudowa na serwo v3.SLDPRT
zzz inne/Solidworks model3D v1/S3 - segment/arch/S3 rurka v1 prosta.SLDPRT
zzz inne/Solidworks model3D v1/S3 - segment/S3 D obud serwo dol.STL
zzz inne/Solidworks model3D v1/skasuj/kolkoA.STL
=SW 3D v2 kulkowe preguby/S3 segment/P S3 rurka v2 wygieta.SLDPRT
=SW 3D v3 new design/S1 segment/zz/P S1 rurka.SLDPRT
=SW 3D v3 new design/S3 segment/P S3 rurka v9 wygieta sciecia dol.STL
=SW 3D v3 new design/zzz testy/uni obudowas serwa.SLDPRT
plytka MKV30F128Vxx10P/MKV30F128VFL10P/STL/2016-12-16_17-09-52/LQFP-48_7X7X1_6-L.stp
zzz inne/Solidworks model3D v1/skasuj/kolko1.SLDPRT
=SW 3D v2 kulkowe preguby/S0 baza/P S0 korpus obudowa dolna v2 osmiokat.SLDPRT
=SW 3D v2 kulkowe preguby/S0 baza/P S0 korpus obudowa gora.SLDPRT
=SW 3D v2 kulkowe preguby/S0 baza/P S0 korpus obudowa gorna v3 osmiokat bez pochylen.SLDPRT
=SW 3D v2 kulkowe preguby/S0 baza/P S0 lacznik baza+4obejmyPart1.SLDPRT
=SW 3D v2 kulkowe preguby/S0 baza/P S0 obejma serwa do bazy v2 import z uniparts.SLDPRT
=SW 3D v2 kulkowe preguby/S2 segment/STL S2 rurka v2 wygieta prawa.STL
=SW 3D v2 kulkowe preguby/S2 segment/STL S2 rurka v2 wygieta.STL
=SW 3D v2 kulkowe preguby/S2 segment/makeProjectedPlanarWire.x_t
=SW 3D v2 kulkowe preguby/S4 segment/P S4 palec v2 sciecie 120st.SLDPRT
=SW 3D v2 kulkowe preguby/S4 segment/P S4 rurka.SLDPRT
=SW 3D v2 kulkowe preguby/S4 segment/P S4 v3 golen.SLDPRT
=SW 3D v2 kulkowe preguby/S4 segment/STL S4 palec v2 sciecie 120st dol.STL
=SW 3D v2 kulkowe preguby/S4 segment/STL S4 palec v2 sciecie 120st gosssra.STL
=SW 3D v2 kulkowe preguby/S4 segment/STL S4 palec v2 sciecie 120st jedna calosc.STL
=SW 3D v2 kulkowe preguby/S4 segment/STL S4 v3 golen gora.STL
=SW 3D v2 kulkowe preguby/S4 segment/STL S4 v3 golen spod.STL
=SW 3D v2 kulkowe preguby/S4 segment/STL S4 v3 golen srodek.STL
=SW 3D v2 kulkowe preguby/parts ogolne/P v2 prowadnik w obejmie.SLDPRT
=SW 3D v2 kulkowe preguby/parts ogolne/P v2 uni obejma serwa.SLDPRT
=SW 3D v2 kulkowe preguby/parts ogolne/P v3 CALA uni obudowa serwa.STL
=SW 3D v2 kulkowe preguby/parts ogolne/P v3 uni obudowa serwa.SLDPRT
=SW 3D v2 kulkowe preguby/parts ogolne/P v4 uni obudowa serwa.SLDPRT
=SW 3D v2 kulkowe preguby/parts ogolne/P zaslepka obejmy serwa.SLDPRT
=SW 3D v2 kulkowe preguby/parts ogolne/STL v2 uni obej wieksze pol.STL
=SW 3D v2 kulkowe preguby/parts ogolne/STL v3 uni obud serv czapka dol.STL
=SW 3D v2 kulkowe preguby/parts ogolne/STL v3 uni obud serv dolna wer z czapka.STL
=SW 3D v2 kulkowe preguby/parts ogolne/STL v3 uni obud serv dolna.STL
=SW 3D v2 kulkowe preguby/parts ogolne/STL v3 uni obud serv gorna wer z czapka.STL
=SW 3D v2 kulkowe preguby/parts ogolne/STL v3 uni obud serv gorna.STL
=SW 3D v2 kulkowe preguby/parts ogolne/STL v3 uni obud serv rurka.STL
=SW 3D v2 kulkowe preguby/parts ogolne/STL v3 uni obud serv walek.STL
=SW 3D v2 kulkowe preguby/parts ogolne/STL v3 uni obudowa serwa AAA.STL
=SW 3D v2 kulkowe preguby/parts ogolne/zz/P prowadnik w obejmie.SLDPRT
=SW 3D v2 kulkowe preguby/parts ogolne/zz/P szablon arm.SLDPRT
=SW 3D v2 kulkowe preguby/parts ogolne/zz/P uni obejma serwa bez znacznikow.SLDPRT
=SW 3D v2 kulkowe preguby/parts ogolne/zz/P v2 uni obudowa serwaxx.SLDPRT
=SW 3D v2 kulkowe preguby/parts ogolne/zz/P v3 uni obudowas serwa ciensza.SLDPRT
=SW 3D v2 kulkowe preguby/parts ogolne/zz/uni obejma serwa - Kopia.SLDPRT
=SW 3D v2 kulkowe preguby/parts ogolne/zz/uni obudowas serwa rurka scianki 3mm.SLDPRT
=SW 3D v2 kulkowe preguby/z parts fabryczne i dodatki/P DoubleServoArm.SLDPRT
=SW 3D v2 kulkowe preguby/z parts fabryczne i dodatki/P SingleServoArm.SLDPRT
=SW 3D v2 kulkowe preguby/z parts fabryczne i dodatki/P aku zel 6v.SLDPRT
=SW 3D v2 kulkowe preguby/zzz testy/uni obejma serwa.SLDPRT
=SW 3D v2 kulkowe preguby/zzz testy/uni obudowas serwa.SLDPRT
=SW 3D v3 new design/S0 baza/==/P S0 korpus obudowa dolna v2 osmiokat.SLDPRT
=SW 3D v3 new design/S0 baza/==/P S0 korpus obudowa gora.SLDPRT
=SW 3D v3 new design/S0 baza/==/P S0 korpus obudowa gorna v3 osmiokat bez pochylen.SLDPRT
=SW 3D v3 new design/S0 baza/==/P S0 obejma serwa do bazy v2 import z uniparts.SLDPRT
=SW 3D v3 new design/S0 baza/P S0 podstawa 4 obudowy serw.SLDPRT
=SW 3D v3 new design/S0 baza/P S0 v2 podstawa 4 obudowy serw.SLDPRT
=SW 3D v3 new design/S1 segment/zz/P S1 obudowy serw o 90st.SLDPRT
=SW 3D v3 new design/S2 segment/P S2 rurka v6.SLDPRT
=SW 3D v3 new design/S2 segment/P S2 rurka v7 sciecia.SLDPRT
=SW 3D v3 new design/S2 segment/STL S2 rurka v2 wygieta prawa.STL
=SW 3D v3 new design/S2 segment/STL S2 rurka v2 wygieta.STL
=SW 3D v3 new design/S3 segment/P S3 rurka v8 wygieta sciecia.SLDPRT
=SW 3D v3 new design/S3 segment/P S3 rurka v9 wygieta sciecia.SLDPRT
=SW 3D v3 new design/S3 segment/zz/P S3 rurka v5 prosta.SLDPRT
=SW 3D v3 new design/S4 segment/==/P S4 golen.SLDPRT
=SW 3D v3 new design/S4 segment/==/P S4 palec v2 sciecie 120st.SLDPRT
=SW 3D v3 new design/S4 segment/==/P S4 v3 golen.SLDPRT
=SW 3D v3 new design/S4 segment/P S4 trzpien do endstopu.SLDPRT
=SW 3D v3 new design/S4 segment/P S4 v4 golen.SLDPRT
=SW 3D v3 new design/S4 segment/STL S4 palec v2 sciecie 120st dol.STL
=SW 3D v3 new design/S4 segment/STL S4 palec v2 sciecie 120st gosssra.STL
=SW 3D v3 new design/S4 segment/STL S4 palec v2 sciecie 120st jedna calosc.STL
=SW 3D v3 new design/S4 segment/STL S4 v3 golen gora.STL
=SW 3D v3 new design/S4 segment/STL S4 v3 golen spod.STL
=SW 3D v3 new design/S4 segment/STL S4 v3 golen srodek.STL
=SW 3D v3 new design/parts ogolne/P v8 uni obejma serwa szeroka rurka.SLDPRT
=SW 3D v3 new design/parts ogolne/P v8a uni obejma serwa bez rurki.SLDPRT
=SW 3D v3 new design/parts ogolne/STL v8 obej mniejsza.STL
=SW 3D v3 new design/parts ogolne/STL v8 obej wieksza.STL
=SW 3D v3 new design/parts ogolne/STL v8 obud czapka.STL
=SW 3D v3 new design/parts ogolne/STL v8 obud dol szer rur.STL
=SW 3D v3 new design/parts ogolne/STL v8 obud gor szer rur.STL
=SW 3D v3 new design/parts ogolne/dP v8a uni obudowa serwa szeroka rurak 90st.STL
=SW 3D v3 new design/parts ogolne/gP v8a uni obudowa serwa szeroka rurak 90st.STL
=SW 3D v3 new design/parts ogolne/makeProjectedPlanarWire.x_t
=SW 3D v3 new design/parts ogolne/pppP v9 uni obejma serwa szeroka rurka+1mm.SLDPRT
=SW 3D v3 new design/parts ogolne/rozklad obejma i obud proste.amf
=SW 3D v3 new design/parts ogolne/rozklad obejma.amf
=SW 3D v3 new design/parts ogolne/zz/P lacznik rurek.SLDPRT
=SW 3D v3 new design/parts ogolne/zz/P prowadnik w obejmie.SLDPRT
=SW 3D v3 new design/parts ogolne/zz/P szablon arm.SLDPRT
=SW 3D v3 new design/parts ogolne/zz/P uni obejma serwa bez znacznikow.SLDPRT
=SW 3D v3 new design/parts ogolne/zz/P v2 prowadnik w obejmie.SLDPRT
=SW 3D v3 new design/parts ogolne/zz/P v2 uni obejma serwa.SLDPRT
=SW 3D v3 new design/parts ogolne/zz/P v2 uni obudowa serwaxx.SLDPRT
=SW 3D v3 new design/parts ogolne/zz/P v3 uni obudowas serwa ciensza.SLDPRT
=SW 3D v3 new design/parts ogolne/zz/P v5 uni obudowa serwa.SLDPRT
=SW 3D v3 new design/parts ogolne/zz/P v6 uni obejma serwa.SLDPRT
=SW 3D v3 new design/parts ogolne/zz/P v6 uni obudowa serwa.SLDPRT
=SW 3D v3 new design/parts ogolne/zz/P v7 uni obejma serwa.SLDPRT
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
