KubaMiszcz/Praca-Inzynierska---RoboPajak/kalibracja serwa SG90/obliczenia servo sg90.xlsx

stopnie | mikrosekundy recznie | mikrosekundy proporcjonalne
 |  | 503.75
0 | 565 | 565 | skrajna waretosc odczytana
45 | 1019 | 1068.75
90 | 1475 | 1572.5
135 | 1980 | 2076.25
180 | 2580 | 2580 | skrajna waretosc odczytana
stopnie | mikrosekundy recznie
0 | 565 | 565
22.5 | 792 | 792
45 | 1019 | 1019
67.5 | 1247 | 1247
90 | 1475 | 1475
112.5 | 1727.5 | 1720 | -0.44%
135 | 1980 | 1980
157.5 | 2280 | 2280
180 | 2580 | 2580
