KubaMiszcz/Praca-Inzynierska---RoboPajak/plytka MKV30F128Vxx10P/MKV30F128VFL10PminimumV2/MKV30F128VFL10PminimumV2.brd.pdf

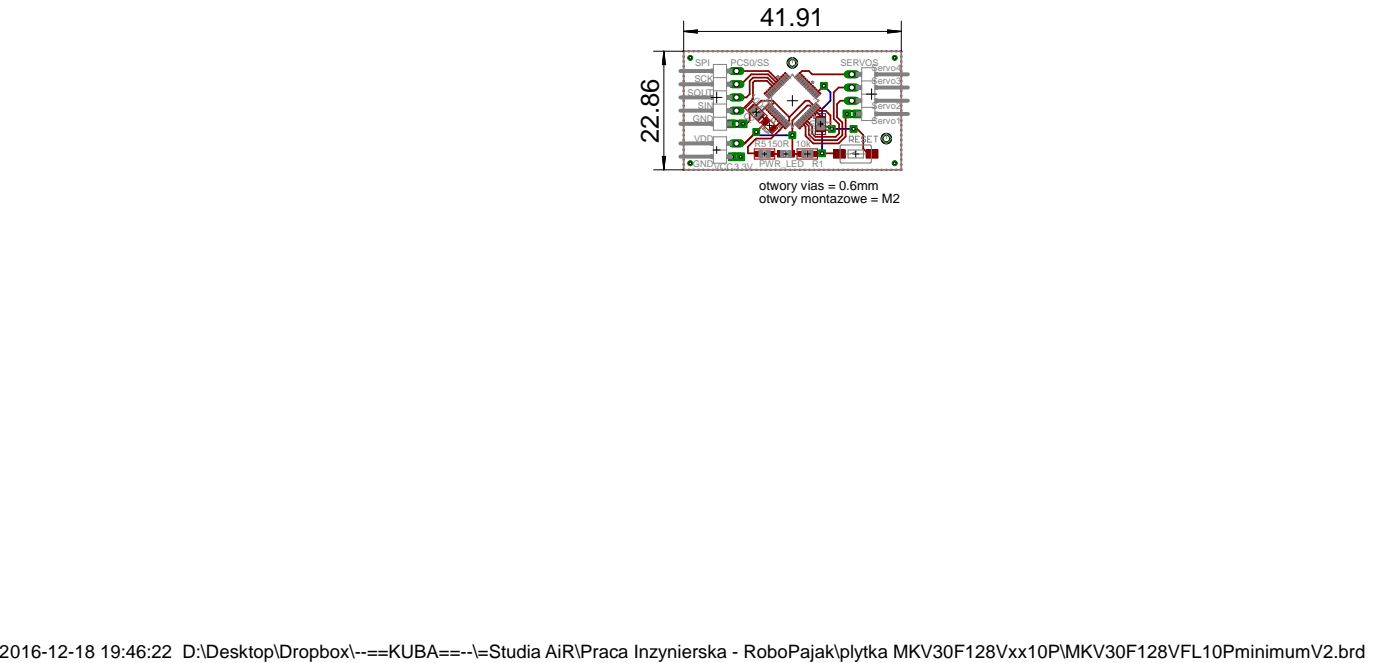
[picture p163: page 1]
VSS VSS; VSSA; VDD VDD; VDDA; Servo4 Servo3; Servo1; Servo2; PCS0/SS; SCK SOUT SIN GND; VDD; GND; SPI; SERVOS; PWR_LED; VCC; otwory vias = 0.6mm otwory montazowe = M2

2016-12-18 19:46:22 D:\Desktop\Dropbox\--==KUBA==--\=Studia AiR\Praca Inzynierska - RoboPajak\plytka MKV30F128Vxx10P\MKV30F128VFL10PminimumV2.brd
