KubaMiszcz/Praca-Inzynierska---RoboPajak/plytka MKV30F128Vxx10P/MKV30F128VFL10PminimumV2/MKV30F128VFL10PminimumV2.sch.pdf

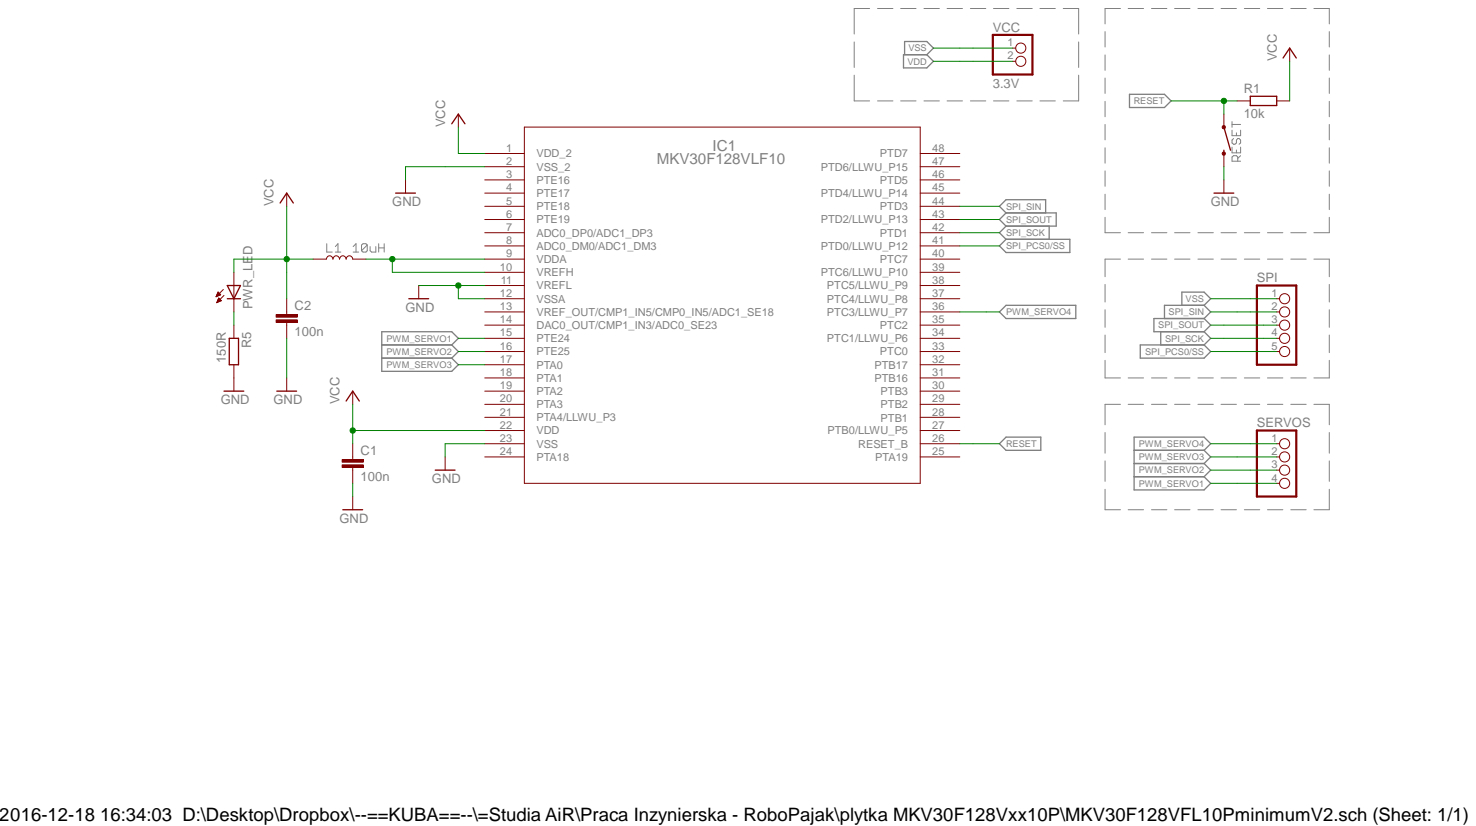
[picture p164: page 1]
MKV30F128VLF10; GND; VCC; VDD_2 1 VSS_2 2 PTE16 3 PTE17 4 PTE18 5 PTE19 6 ADC0_DP0/ADC1_DP3 7 ADC0_DM0/ADC1_DM3 8 VDDA 9 VREFH 10 VREFL 11 VSSA 12 VREF_OUT/CMP1_IN5/CMP0_IN5/ADC1_SE18 13 DAC0_OUT/CMP1_IN3/ADC0_SE23 14 PTE24 15 PTE25 16 PTA0 17 PTA1 18 PTA2 19 PTA3 20 PTA4/LLWU_P3 21 VDD 22 VSS 23; PTA18 24; PTA19; 25 RESET_B; 26 PTB0/LLWU_P5; 27 PTB1; 28 PTB2; 29 PTB3; 30 PTB16; 31 PTB17; 32 PTC0; 33 PTC1/LLWU_P6; 34 PTC2; 35 PTC3/LLWU_P7; 36 PTC4/LLWU_P8; 37 PTC5/LLWU_P9; 38 PTC6/LLWU_P10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

2016-12-18 16:34:03 D:\Desktop\Dropbox\--==KUBA==--\=Studia AiR\Praca Inzynierska - RoboPajak\plytka MKV30F128Vxx10P\MKV30F128VFL10PminimumV2.sch (Sheet: 1/1)
