KubaMiszcz/Praca-Inzynierska---RoboPajak/plytka MKV30F128Vxx10P/MKV30F128VFL10PmaximumV2/MKV30F128VFL10PmaximumV2.brd

## EAGLE design plytka MKV30F128Vxx10P/MKV30F128VFL10PmaximumV2/MKV30F128VFL10PmaximumV2.brd (2017-05-17)

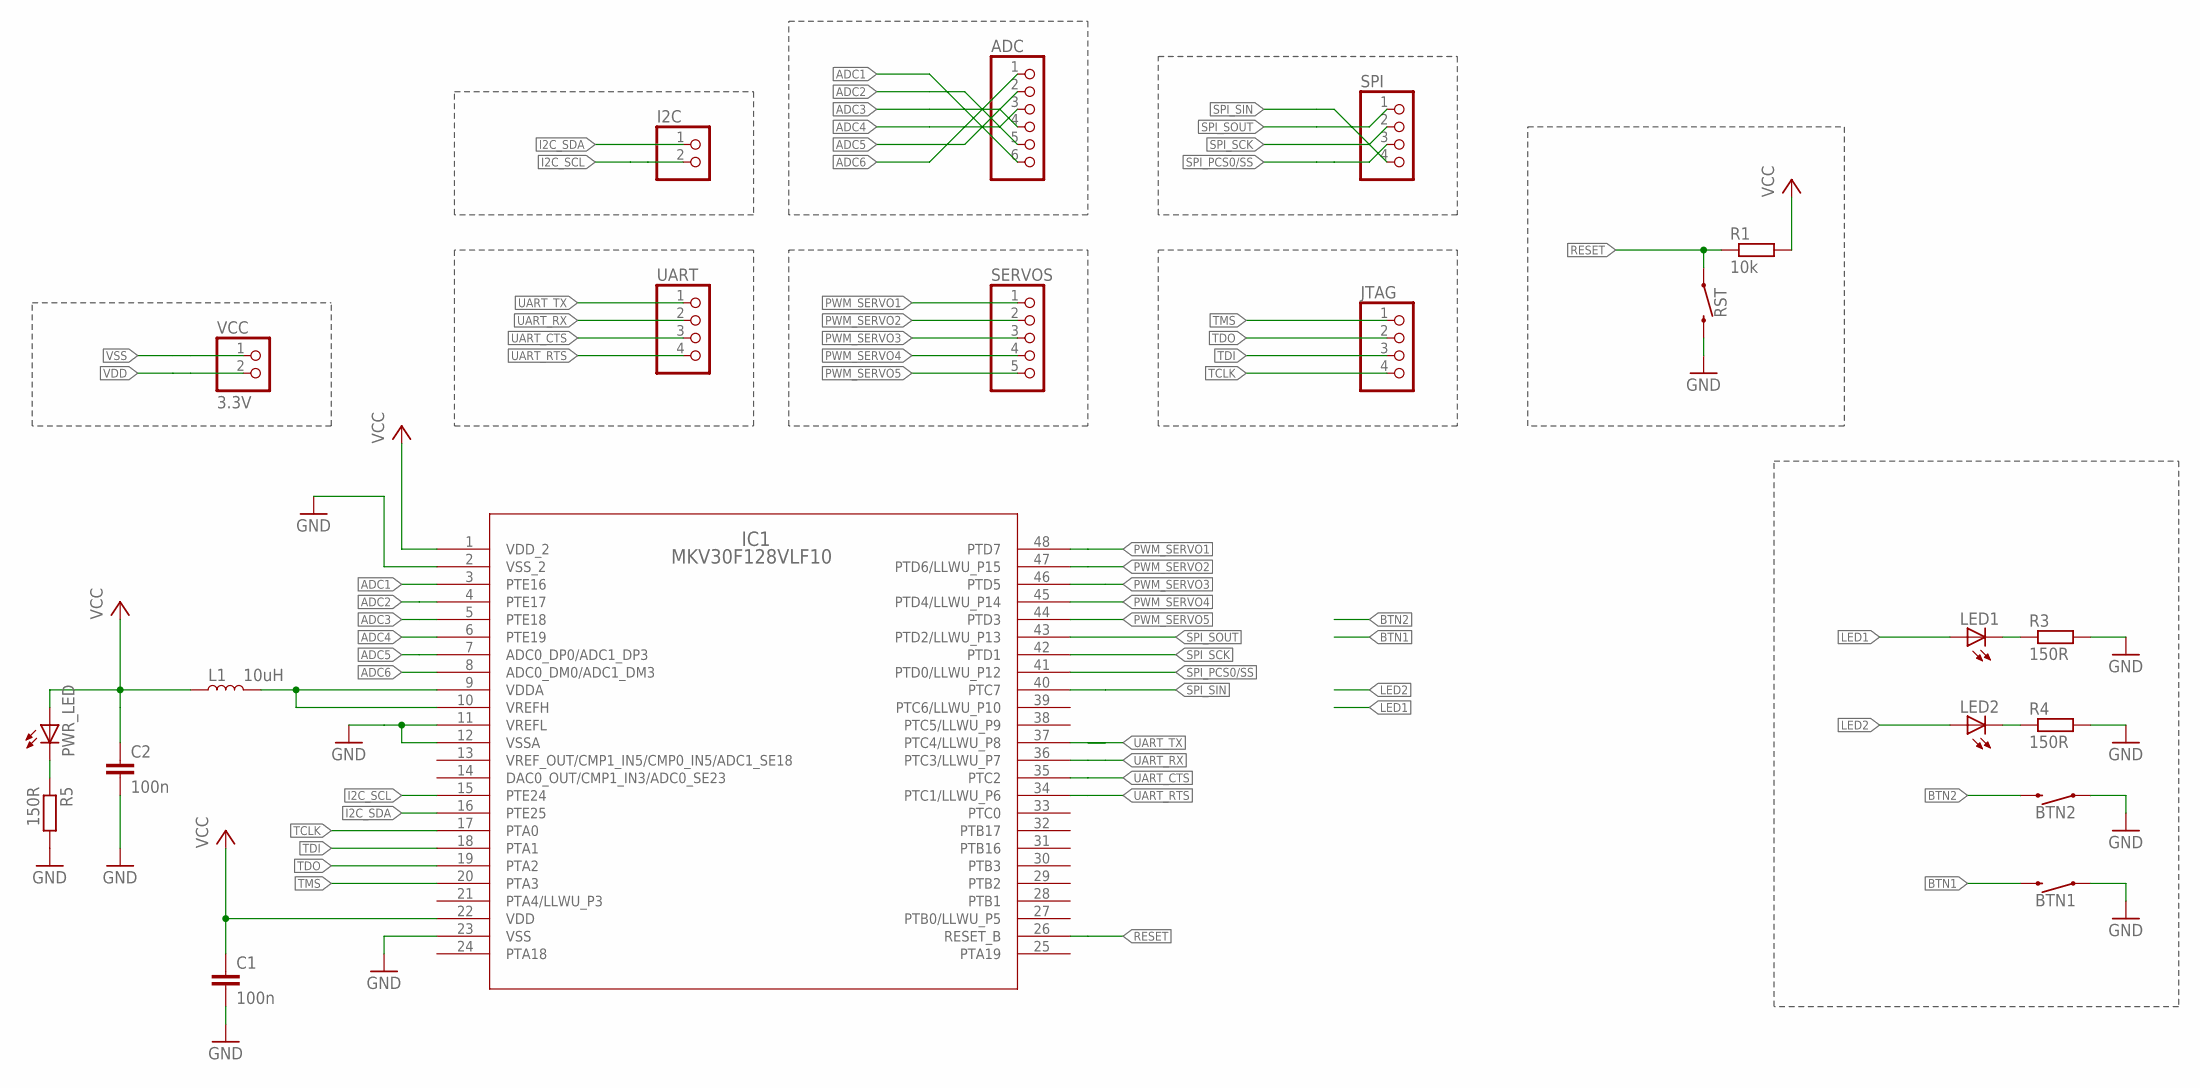
[picture p165: schematic MKV30F128VFL10PmaximumV2.sch]

Parts:
ADC: PINHD-1X6/90; 1X06/90
BTN1, BTN2: MOMENTARY-SWITCH-SPST-SMD-6.0X3.5MM; TACTILE_SWITCH_SMD_6.0X3.5MM
C1, C2: 100n; C0805
I2C: PINHD-1X2/90; 1X02/90
IC1: MKV30F128VLF10; LQFP-48_7X7X1.6
JTAG: PINHD-1X4/90; 1X04/90
L1: 10uH; 0805
LED1, LED2: LEDCHIP-LED0805; CHIP-LED0805
PWR_LED: LEDCHIP-LED0805; CHIP-LED0805
R1: 10k; R0805W
R3, R4, R5: 150R; R0805W
RST: MOMENTARY-SWITCH-SPST-SMD-6.0X3.5MM; TACTILE_SWITCH_SMD_6.0X3.5MM
SERVOS: PINHD-1X5/90; 1X05/90
SPI: PINHD-1X4/90; 1X04/90
UART: PINHD-1X4/90; 1X04/90
VCC: 3.3V; 1X02/90

Connections:
ADC1: ADC.6, IC1.3 (PTE16)
ADC2: ADC.5, IC1.4 (PTE17)
ADC3: ADC.4, IC1.5 (PTE18)
ADC4: ADC.3, IC1.6 (PTE19)
ADC5: ADC.2, IC1.7 (ADC0_DP0/ADC1_DP3)
ADC6: ADC.1, IC1.8 (ADC0_DM0/ADC1_DM3)
BTN1: BTN1.2
BTN2: BTN2.2
I2C_SCL: I2C.2, IC1.15 (PTE24)
I2C_SDA: I2C.1, IC1.16 (PTE25)
LED1: LED1.A
LED2: LED2.A
unnamed: LED2.C, R4.1
unnamed: LED1.C, R3.1
unnamed: PWR_LED.C, R5.1
PWM_SERVO1: IC1.48 (PTD7), SERVOS.1
PWM_SERVO2: IC1.47 (PTD6/LLWU_P15), SERVOS.2
PWM_SERVO3: IC1.46 (PTD5), SERVOS.3
PWM_SERVO4: IC1.45 (PTD4/LLWU_P14), SERVOS.4
PWM_SERVO5: IC1.44 (PTD3), SERVOS.5
RESET: IC1.26 (RESET_B), R1.1, RST.1
SPI_PCS0/SS: IC1.41 (PTD0/LLWU_P12), SPI.3
SPI_SCK: IC1.42 (PTD1), SPI.2
SPI_SIN: IC1.40 (PTC7), SPI.4
SPI_SOUT: IC1.43 (PTD2/LLWU_P13), SPI.1
TCLK: IC1.17 (PTA0), JTAG.4
TDI: IC1.18 (PTA1), JTAG.3
TDO: IC1.19 (PTA2), JTAG.2
TMS: IC1.20 (PTA3), JTAG.1
UART_CTS: IC1.35 (PTC2), UART.3
UART_RTS: IC1.34 (PTC1/LLWU_P6), UART.4
UART_RX: IC1.36 (PTC3/LLWU_P7), UART.2
UART_TX: IC1.37 (PTC4/LLWU_P8), UART.1
VDD: C1.1, C2.1, IC1.1 (VDD_2), IC1.22 (VDD), L1.1, PWR_LED.A, R1.2, VCC.2
VDDA: IC1.9 (VDDA), IC1.10 (VREFH), L1.2
VSS: BTN1.1, BTN2.1, C1.2, C2.2, IC1.2 (VSS_2), IC1.11 (VREFL), IC1.12 (VSSA), IC1.23 (VSS), R3.2, R4.2, R5.2, RST.2, VCC.1

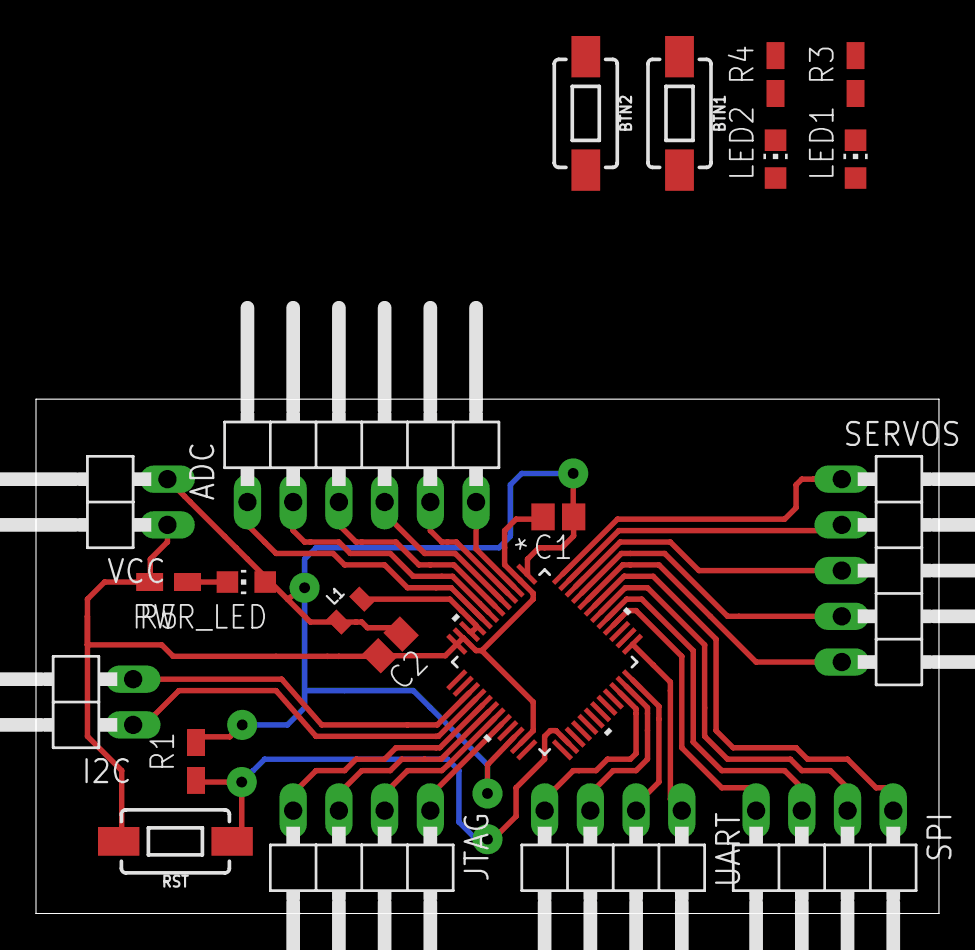
[picture p166: board MKV30F128VFL10PmaximumV2.brd from above]

Board: 2 copper layers, 50.2 x 28.6 mm, 21 parts (0 on the bottom side), 32 nets.
