KubaMiszcz/Praca-Inzynierska---RoboPajak/plytka MKV30F128Vxx10P/MKV30F128VFL10PminimumV2/MKV30F128VFL10PminimumV2.brd

## EAGLE design plytka MKV30F128Vxx10P/MKV30F128VFL10PminimumV2/MKV30F128VFL10PminimumV2.brd (2017-05-17)

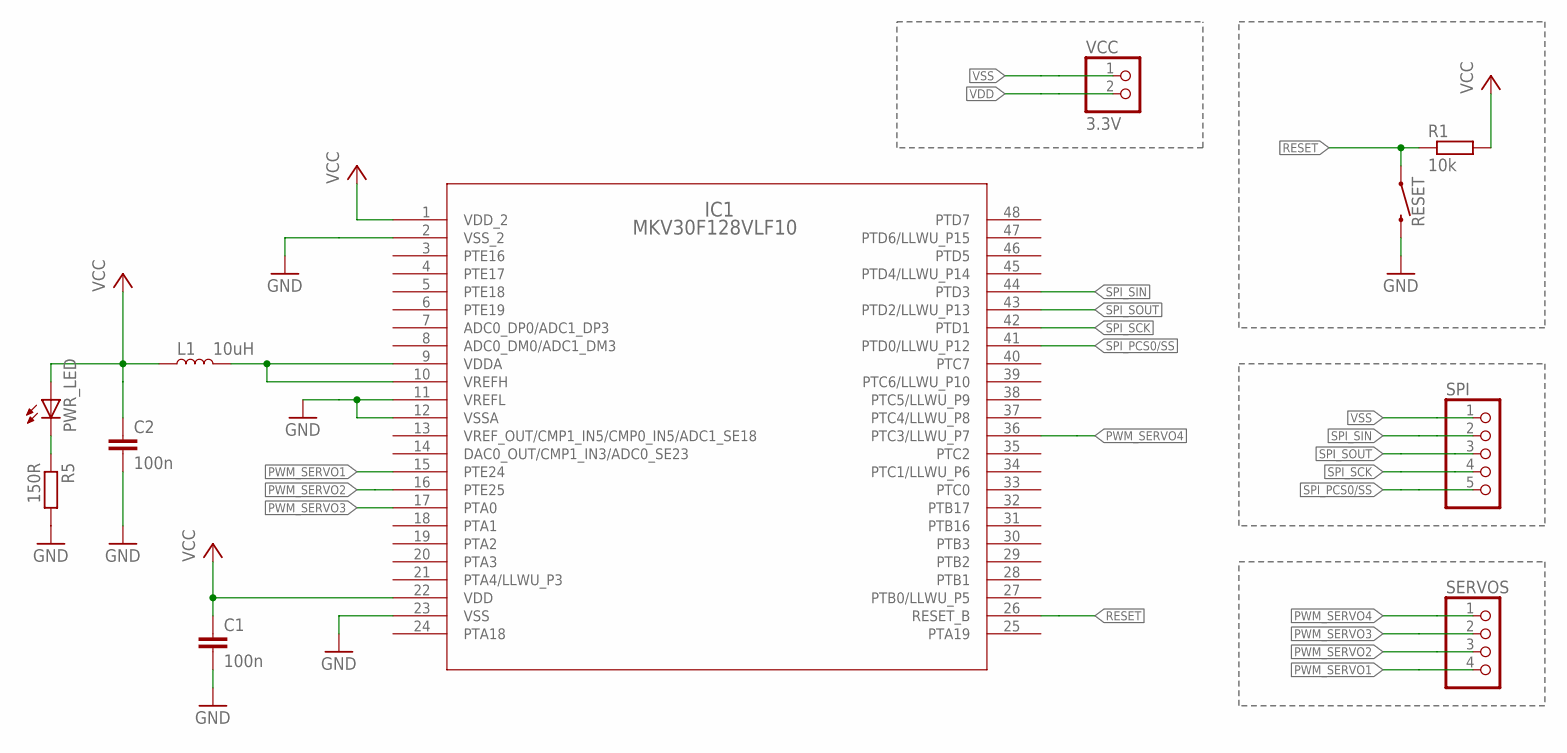
[picture p167: schematic MKV30F128VFL10PminimumV2.sch]

Parts:
C1, C2: 100n; C0805
IC1: MKV30F128VLF10; LQFP-48_7X7X1.6
L1: 10uH; 0805
PWR_LED: LEDCHIP-LED0805; CHIP-LED0805
R1: 10k; R0805W
R5: 150R; R0805W
RESET: MOMENTARY-SWITCH-SPST-SMD-6.0X3.5MM; TACTILE_SWITCH_SMD_6.0X3.5MM
SERVOS: PINHD-1X4/90; 1X04/90
SPI: PINHD-1X5/90; 1X05/90
VCC: 3.3V; 1X02/90

Connections:
unnamed: PWR_LED.C, R5.1
PWM_SERVO1: IC1.15 (PTE24), SERVOS.4
PWM_SERVO2: IC1.16 (PTE25), SERVOS.3
PWM_SERVO3: IC1.17 (PTA0), SERVOS.2
PWM_SERVO4: IC1.36 (PTC3/LLWU_P7), SERVOS.1
RESET: IC1.26 (RESET_B), R1.1, RESET.1
SPI_PCS0/SS: IC1.41 (PTD0/LLWU_P12), SPI.5
SPI_SCK: IC1.42 (PTD1), SPI.4
SPI_SIN: IC1.44 (PTD3), SPI.2
SPI_SOUT: IC1.43 (PTD2/LLWU_P13), SPI.3
VDD: C1.1, C2.1, IC1.1 (VDD_2), IC1.22 (VDD), L1.1, PWR_LED.A, R1.2, VCC.2
VDDA: IC1.9 (VDDA), IC1.10 (VREFH), L1.2
VSS: C1.2, C2.2, IC1.2 (VSS_2), IC1.11 (VREFL), IC1.12 (VSSA), IC1.23 (VSS), R5.2, RESET.2, SPI.1, VCC.1

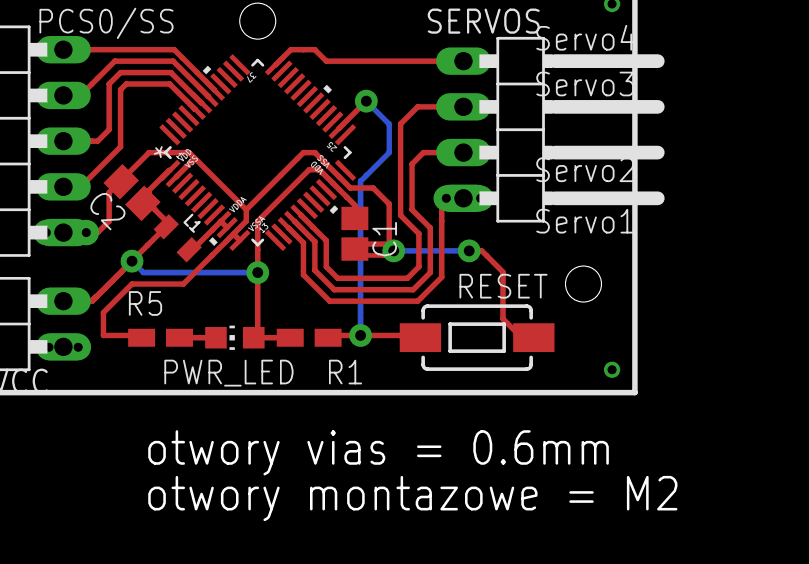
[picture p168: board MKV30F128VFL10PminimumV2.brd from above]

Board: 2 copper layers, 11 parts (0 on the bottom side), 13 nets.
