KubaMiszcz/Praca-Inzynierska---RoboPajak/robopajak software/robopajak - kinematyka prosta cpp/robopajak/Robot.cpp

// 
// 
// 

#include "Robot.h"

void Robot::init()
{


}

Robot::Robot()
{
}

Robot::Robot(RobotLeg LegFL, RobotLeg LegFR, RobotLeg LegRL, RobotLeg LegRR)
{
}

void Robot::MoveToPoint(float X, float Y, float Z)
{
}

void Robot::Rotate(float alfa)
{
}


Robot RobotObj;
